Mirokuki/Battery-Charger/docs/board-top.png

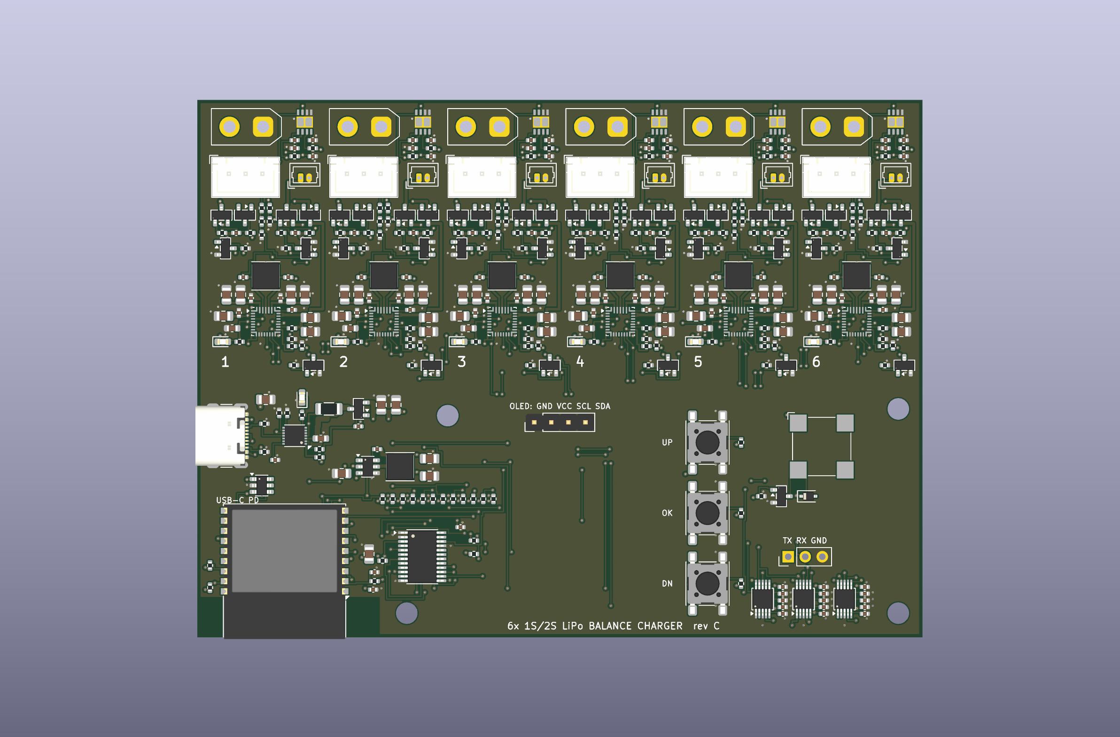
docs/board-top.png
