Mirokuki/Battery-Charger/docs/copper.png

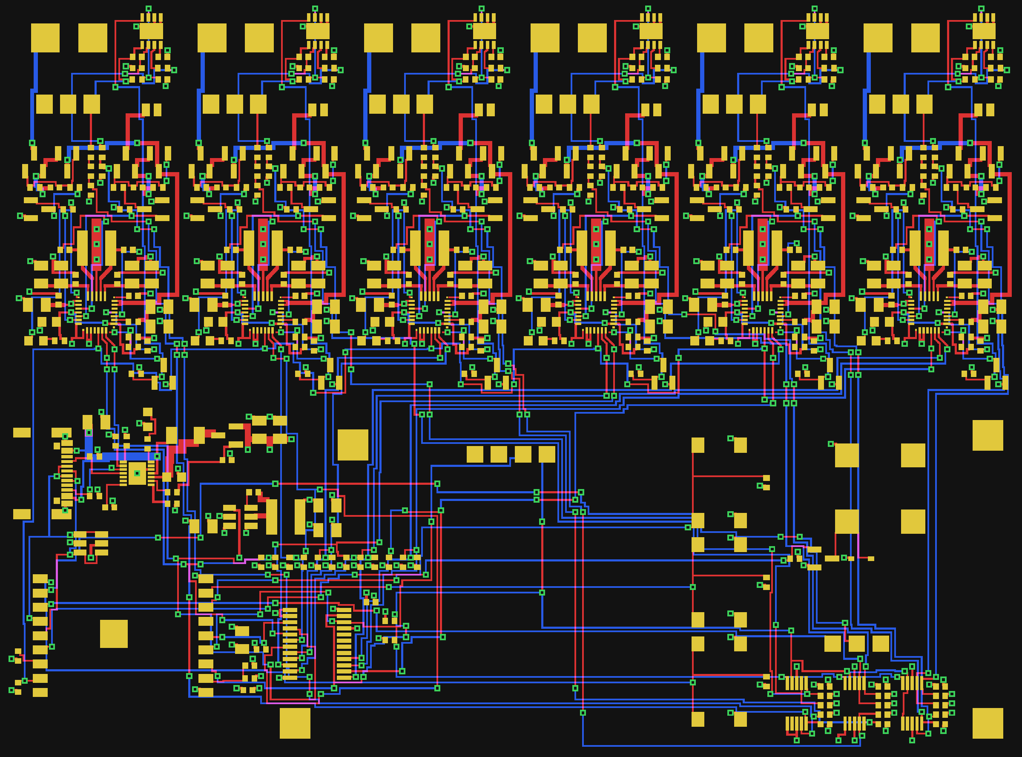
docs/copper.png
