Mirokuki/Battery-Charger/fab/BOM_JLCPCB.csv

Comment | Designator | Footprint | LCSC Part # | MPN | Qty | Assembly
CMT-8504-100-SMT | BZ1 | MagneticBuzzer_CUI_CMT-8504-100-SMT |  | CMT-8504-100-SMT-TR | 1 | SMT
100nF 50V | C1,C8,C12,C14,C20,C21,C22,C23,C24,C25,C26,C27,C28,C29,C30,C31,C32,C33,C34,C106,C109,C113,C116,C117,C118,C119,C120,C121,C206,C209,C213,C216,C217,C218,C219,C220,C221,C306,C309,C313,C316,C317,C318,C319,C320,C321,C406,C409,C413,C416,C417,C418,C419,C420,C421,C506,C509,C513,C516,C517,C518,C519,C520,C521,C606,C609,C613,C616,C617,C618,C619,C620,C621 | C_0402_1005Metric | C307331 | CL05B104KB54PNC | 73 | SMT
1uF 50V | C2 | C_0603_1608Metric | C15849 | CL10A105KB8NNNC | 1 | SMT
1uF 16V | C3,C13 | C_0402_1005Metric | C52923 | CL05A105KA5NQNC | 2 | SMT
10uF 25V | C4,C5,C6,C7,C11,C105,C107,C108,C114,C115,C205,C207,C208,C214,C215,C305,C307,C308,C314,C315,C405,C407,C408,C414,C415,C505,C507,C508,C514,C515,C605,C607,C608,C614,C615 | C_0805_2012Metric | C15850 | CL21A106KAYNNNE | 35 | SMT
22uF 25V | C9,C10,C110,C111,C210,C211,C310,C311,C410,C411,C510,C511,C610,C611 | C_0805_2012Metric | C45783 | CL21A226MAQNNNE | 14 | SMT
47nF 50V | C101,C103,C201,C203,C301,C303,C401,C403,C501,C503,C601,C603 | C_0402_1005Metric |  | CL05B473KB5NNNC | 12 | SMT
4.7uF 16V | C102,C202,C302,C402,C502,C602 | C_0603_1608Metric | C19666 | CL10A475KO8NNNC | 6 | SMT
1nF 50V | C104,C204,C304,C404,C504,C604 | C_0402_1005Metric | C1523 | CL05B102KB5NNNC | 6 | SMT
PD OK (blue) | D1 | LED_0603_1608Metric | C72041 | 19-217/BHC-ZL1M2RY/3T | 1 | SMT
1N4148WS | D2 | D_SOD-323 | C2128 | 1N4148WS | 1 | SMT
CHARGING (green) | D101,D201,D301,D401,D501,D601 | LED_0603_1608Metric | C72043 | 19-217/GHC-YR1S2/3T | 6 | SMT
USB4105-GF-A | J1 | USB_C_Receptacle_GCT_USB4105-xx-A_16P_TopMnt_Horizontal | C3020560 | USB4105-GF-A | 1 | SMT
OLED 0.96in SSD1306 (GND VCC SCL SDA) | J2 | PinHeader_1x04_P2.54mm_Vertical |  |  | 1 | hand-solder (through-hole)
XT30 2S | J101,J201,J301,J401,J501,J601 | AMASS_XT30UPB-M_1x02_P5.0mm_Vertical | C99101 | XT30UPB-M | 6 | hand-solder (through-hole)
PicoBlade 1S | J102,J202,J302,J402,J502,J602 | Molex_PicoBlade_53047-0210_1x02_P1.25mm_Vertical |  | 0530470210 | 6 | hand-solder (through-hole)
XH balance 2S | J103,J203,J303,J403,J503,J603 | JST_XH_B3B-XH-A_1x03_P2.50mm_Vertical | C144394 | B3B-XH-A | 6 | hand-solder (through-hole)
4.7uH 2A | L1 | L_Changjiang_FNR4030S |  | FNR4030S4R7MT | 1 | SMT
2.2uH 3A | L101,L201,L301,L401,L501,L601 | L_Changjiang_FNR4030S |  | FNR4030S2R2MT | 6 | SMT
AO3400A | Q1 | SOT-23 | C20917 | AO3400A | 1 | SMT
2N7002 | Q2,Q105,Q106,Q107,Q205,Q206,Q207,Q305,Q306,Q307,Q405,Q406,Q407,Q505,Q506,Q507,Q605,Q606,Q607 | SOT-23 | C8545 | 2N7002 | 19 | SMT
AO3401A | Q101,Q102,Q103,Q104,Q201,Q202,Q203,Q204,Q301,Q302,Q303,Q304,Q401,Q402,Q403,Q404,Q501,Q502,Q503,Q504,Q601,Q602,Q603,Q604 | SOT-23 | C15127 | AO3401A | 24 | SMT
5.1k | R1,R2 | R_0402_1005Metric | C25905 | 0402WGF5101TCE | 2 | SMT
5mR 1% | R3 | R_1206_3216Metric |  | PE1206FKF470R005Z | 1 | SMT
6.2k | R4 | R_0402_1005Metric |  | 0402WGF6201TCE | 1 | SMT
200R | R5 | R_0402_1005Metric | C25087 | 0402WGF2000TCE | 1 | SMT
82k | R6 | R_0402_1005Metric | C25958 | 0402WGF8202TCE | 1 | SMT
100k | R7,R17,R116,R216,R316,R416,R516,R616 | R_0402_1005Metric | C25741 | 0402WGF1003TCE | 8 | SMT
2.2k | R8 | R_0402_1005Metric | C25879 | 0402WGF2201TCE | 1 | SMT
10k | R9,R10,R11,R14,R15,R16,R18,R102,R103,R107,R110,R112,R113,R202,R203,R207,R210,R212,R213,R302,R303,R307,R310,R312,R313,R402,R403,R407,R410,R412,R413,R502,R503,R507,R510,R512,R513,R602,R603,R607,R610,R612,R613 | R_0402_1005Metric | C25744 | 0402WGF1002TCE | 43 | SMT
4.7k | R12,R13,R105,R205,R305,R405,R505,R605 | R_0402_1005Metric | C25900 | 0402WGF4701TCE | 8 | SMT
1k | R101,R201,R301,R401,R501,R601 | R_0402_1005Metric | C11702 | 0402WGF1001TCE | 6 | SMT
100R | R104,R115,R204,R215,R304,R315,R404,R415,R504,R515,R604,R615 | R_0402_1005Metric | C25076 | 0402WGF1000TCE | 12 | SMT
47k | R106,R109,R206,R209,R306,R309,R406,R409,R506,R509,R606,R609 | R_0402_1005Metric | C25792 | 0402WGF4702TCE | 12 | SMT
68k | R108,R111,R208,R211,R308,R311,R408,R411,R508,R511,R608,R611 | R_0402_1005Metric | C36871 | 0402WGF6802TCE | 12 | SMT
120R | R114,R214,R314,R414,R514,R614 | R_0402_1005Metric |  | 0402WGF1200TCE | 6 | SMT
1M 0.1% | R117,R118,R119,R120,R121,R217,R218,R219,R220,R221,R317,R318,R319,R320,R321,R417,R418,R419,R420,R421,R517,R518,R519,R520,R521,R617,R618,R619,R620,R621 | R_0402_1005Metric |  | RT0402BRD071ML | 30 | SMT
BTN_UP | SW1 | SW_SPST_PTS645Sx43SMTR92 |  | PTS645SM95SMTR92 LFS | 1 | SMT
BTN_OK | SW2 | SW_SPST_PTS645Sx43SMTR92 |  | PTS645SM95SMTR92 LFS | 1 | SMT
BTN_DN | SW3 | SW_SPST_PTS645Sx43SMTR92 |  | PTS645SM95SMTR92 LFS | 1 | SMT
AP33771C | U1 | DFN-14-1EP_3x3mm_P0.4mm_EP1.78x2.35mm |  | AP33771CFBZ-13-FA02 | 1 | SMT
AP63203WU | U2 | TSOT-23-6 | C780769 | AP63203WU-7 | 1 | SMT
ESP32-C3-WROOM-02-N4 | U3 | ESP32-C3-WROOM-02 | C2934560 | ESP32-C3-WROOM-02-N4 | 1 | SMT
USBLC6-2SC6 | U4 | SOT-23-6 | C7519 | USBLC6-2SC6 | 1 | SMT
TCA9548APWR | U5 | TSSOP-24_4.4x7.8mm_P0.65mm | C130026 | TCA9548APWR | 1 | SMT
ADS1115 | U6,U7,U8 | TSSOP-10_3x3mm_P0.5mm | C37593 | ADS1115IDGSR | 3 | SMT
BQ25798 | U101,U201,U301,U401,U501,U601 | Texas_RQM0029A_VQFN-29_4x4mm_P0.4mm | C2876768 | BQ25798RQMR | 6 | SMT
BQ29209 | U102,U202,U302,U402,U502,U602 | VSON-8-1EP_3x3mm_P0.65mm_EP1.65x2.4mm |  | BQ29209DRBR | 6 | SMT
