Mirokuki/Battery-Charger/case/case_lid.stl

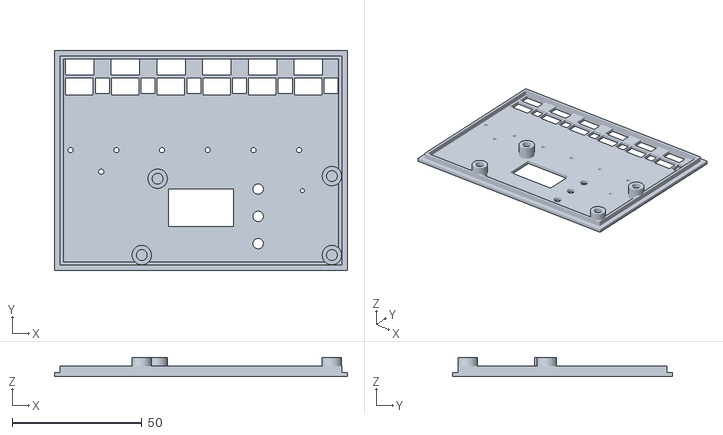
[picture p3: CAD file, 2026-11-12]
case/case_lid.stl
112.8 x 84.8 x 7.50
