Mirokuki/Battery-Charger/case/case_base.stl

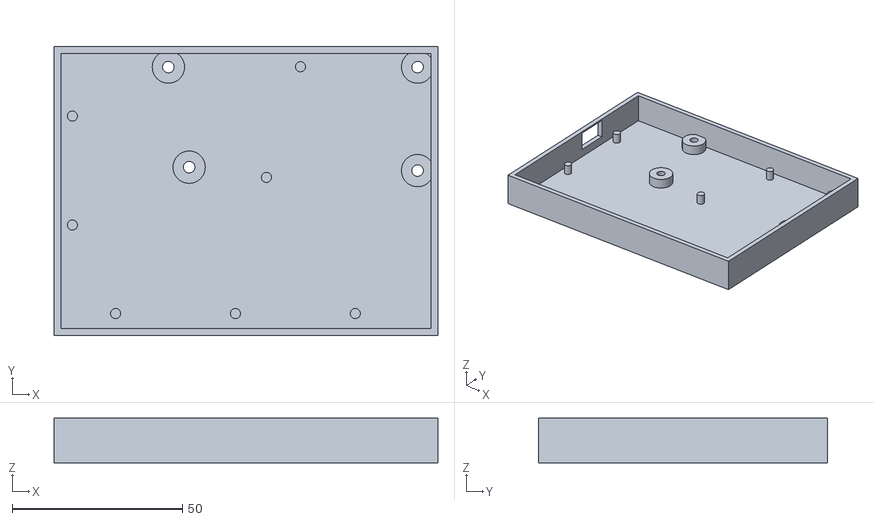
[picture p4: CAD file, 2026-11-12]
case/case_base.stl
112.8 x 84.8 x 13.2
