Mirokuki/Battery-Charger/docs/schematic.pdf

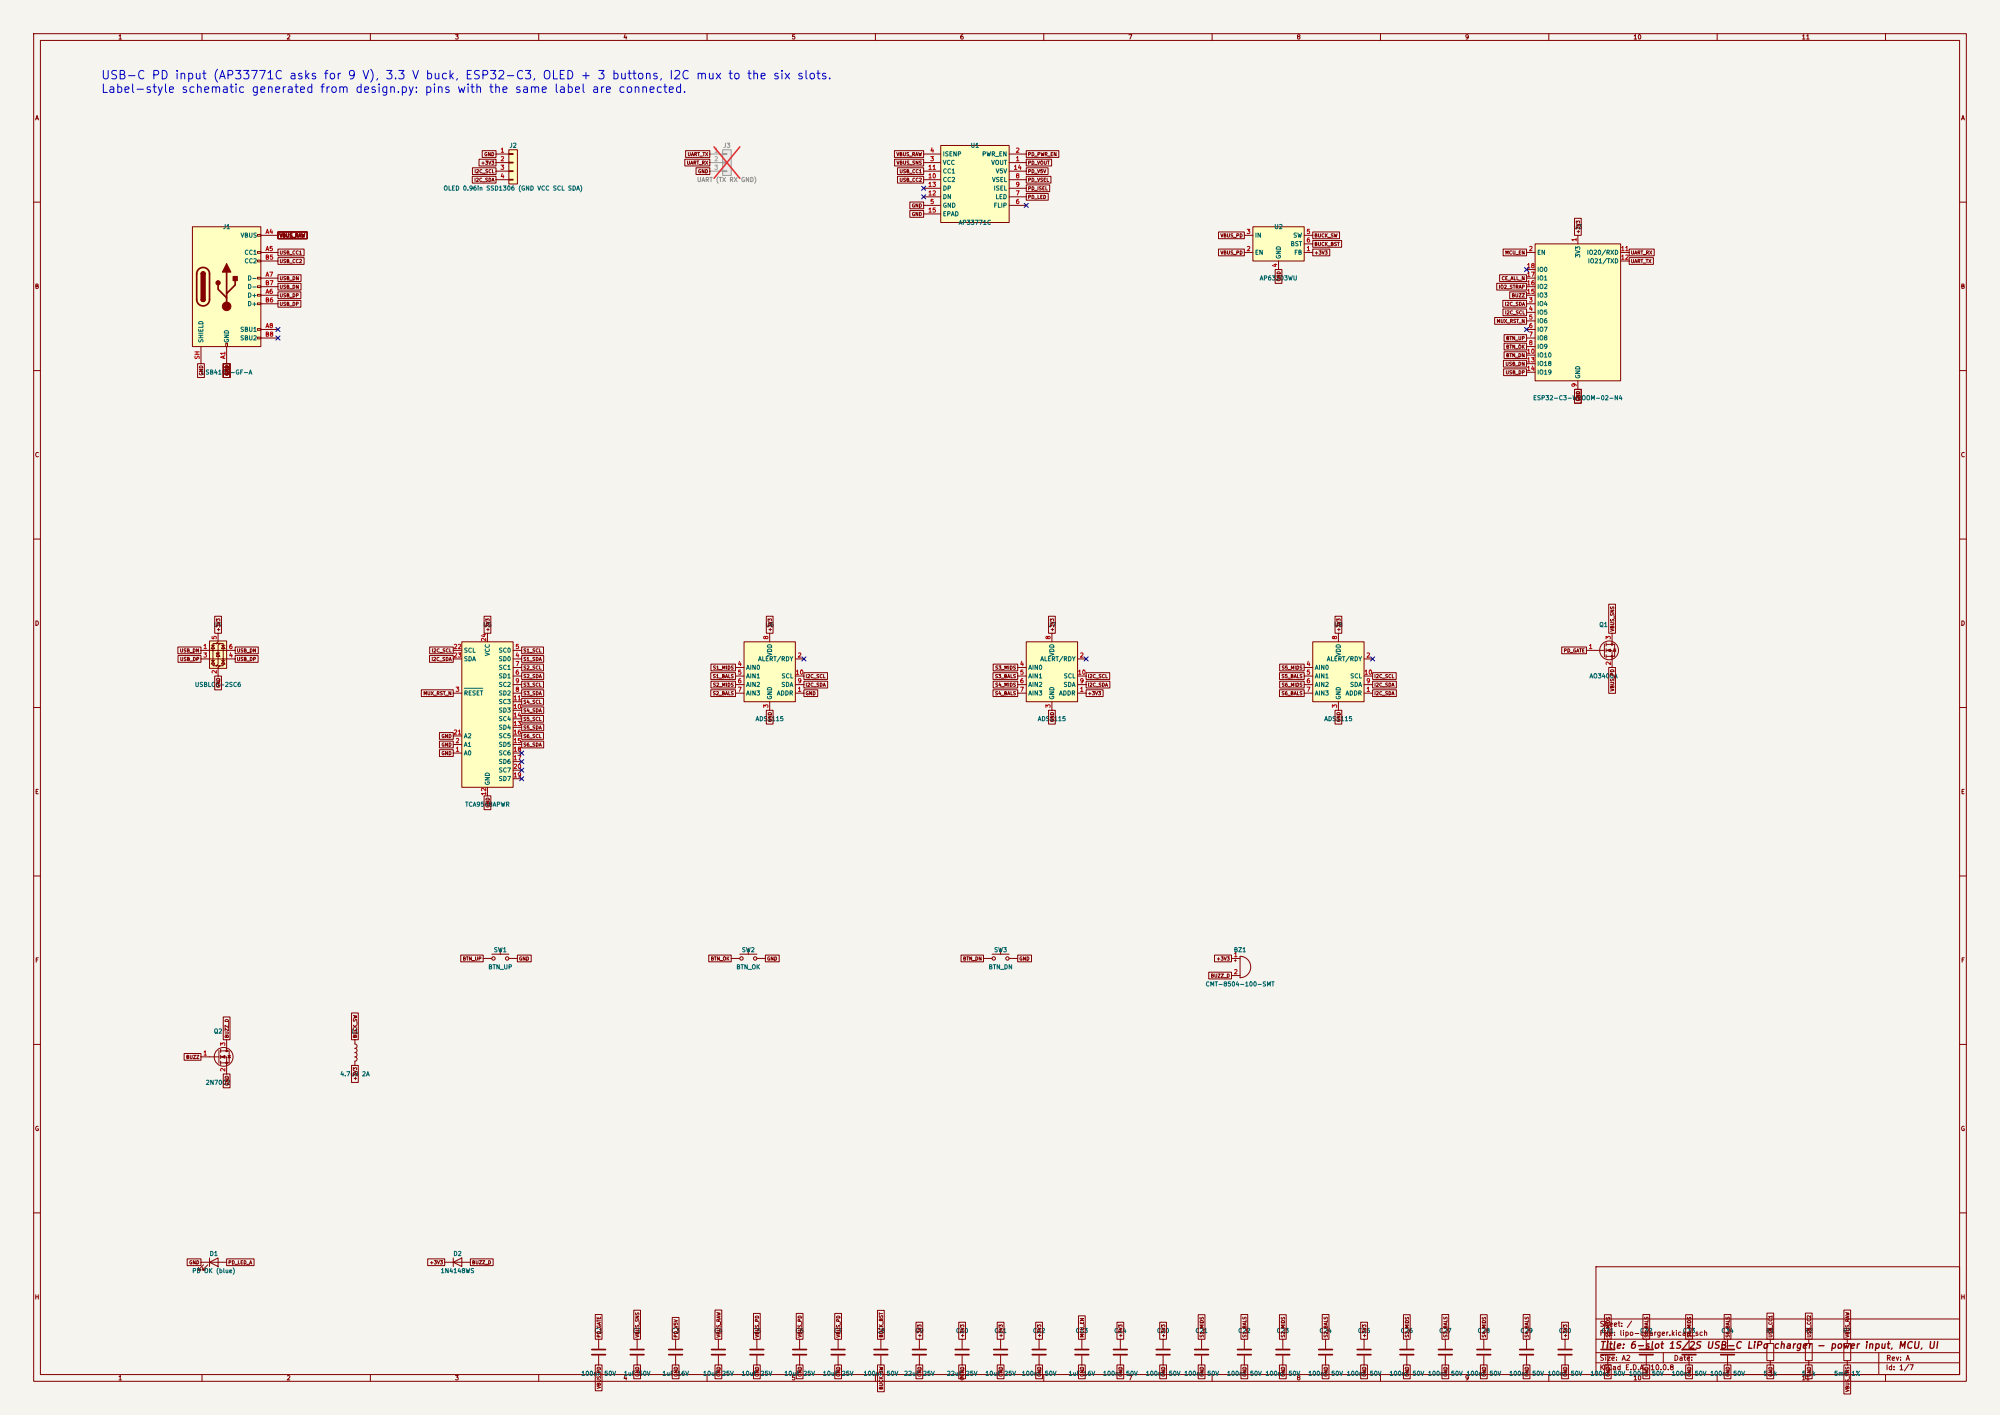
[picture p5: page 1]

USB-C PD input (AP33771C asks for 9 V), 3.3 V buck, ESP32-C3, OLED + 3 buttons, I2C mux to the six slots.
Label-style schematic generated from design.py: pins with the same label are connected.

J2 OLED 0.96in SSD1306 (GND VCC SCL SDA)

File: lipo-charger.kicad_sch
Title: 6-slot 1S/2S USB-C LiPo charger - power input, MCU, UI

Size: A2 | | | Rev: A
KiCad E.D.A. | 100nF | 10.0.8 50V | 5mR | 1% | Id: 1/7

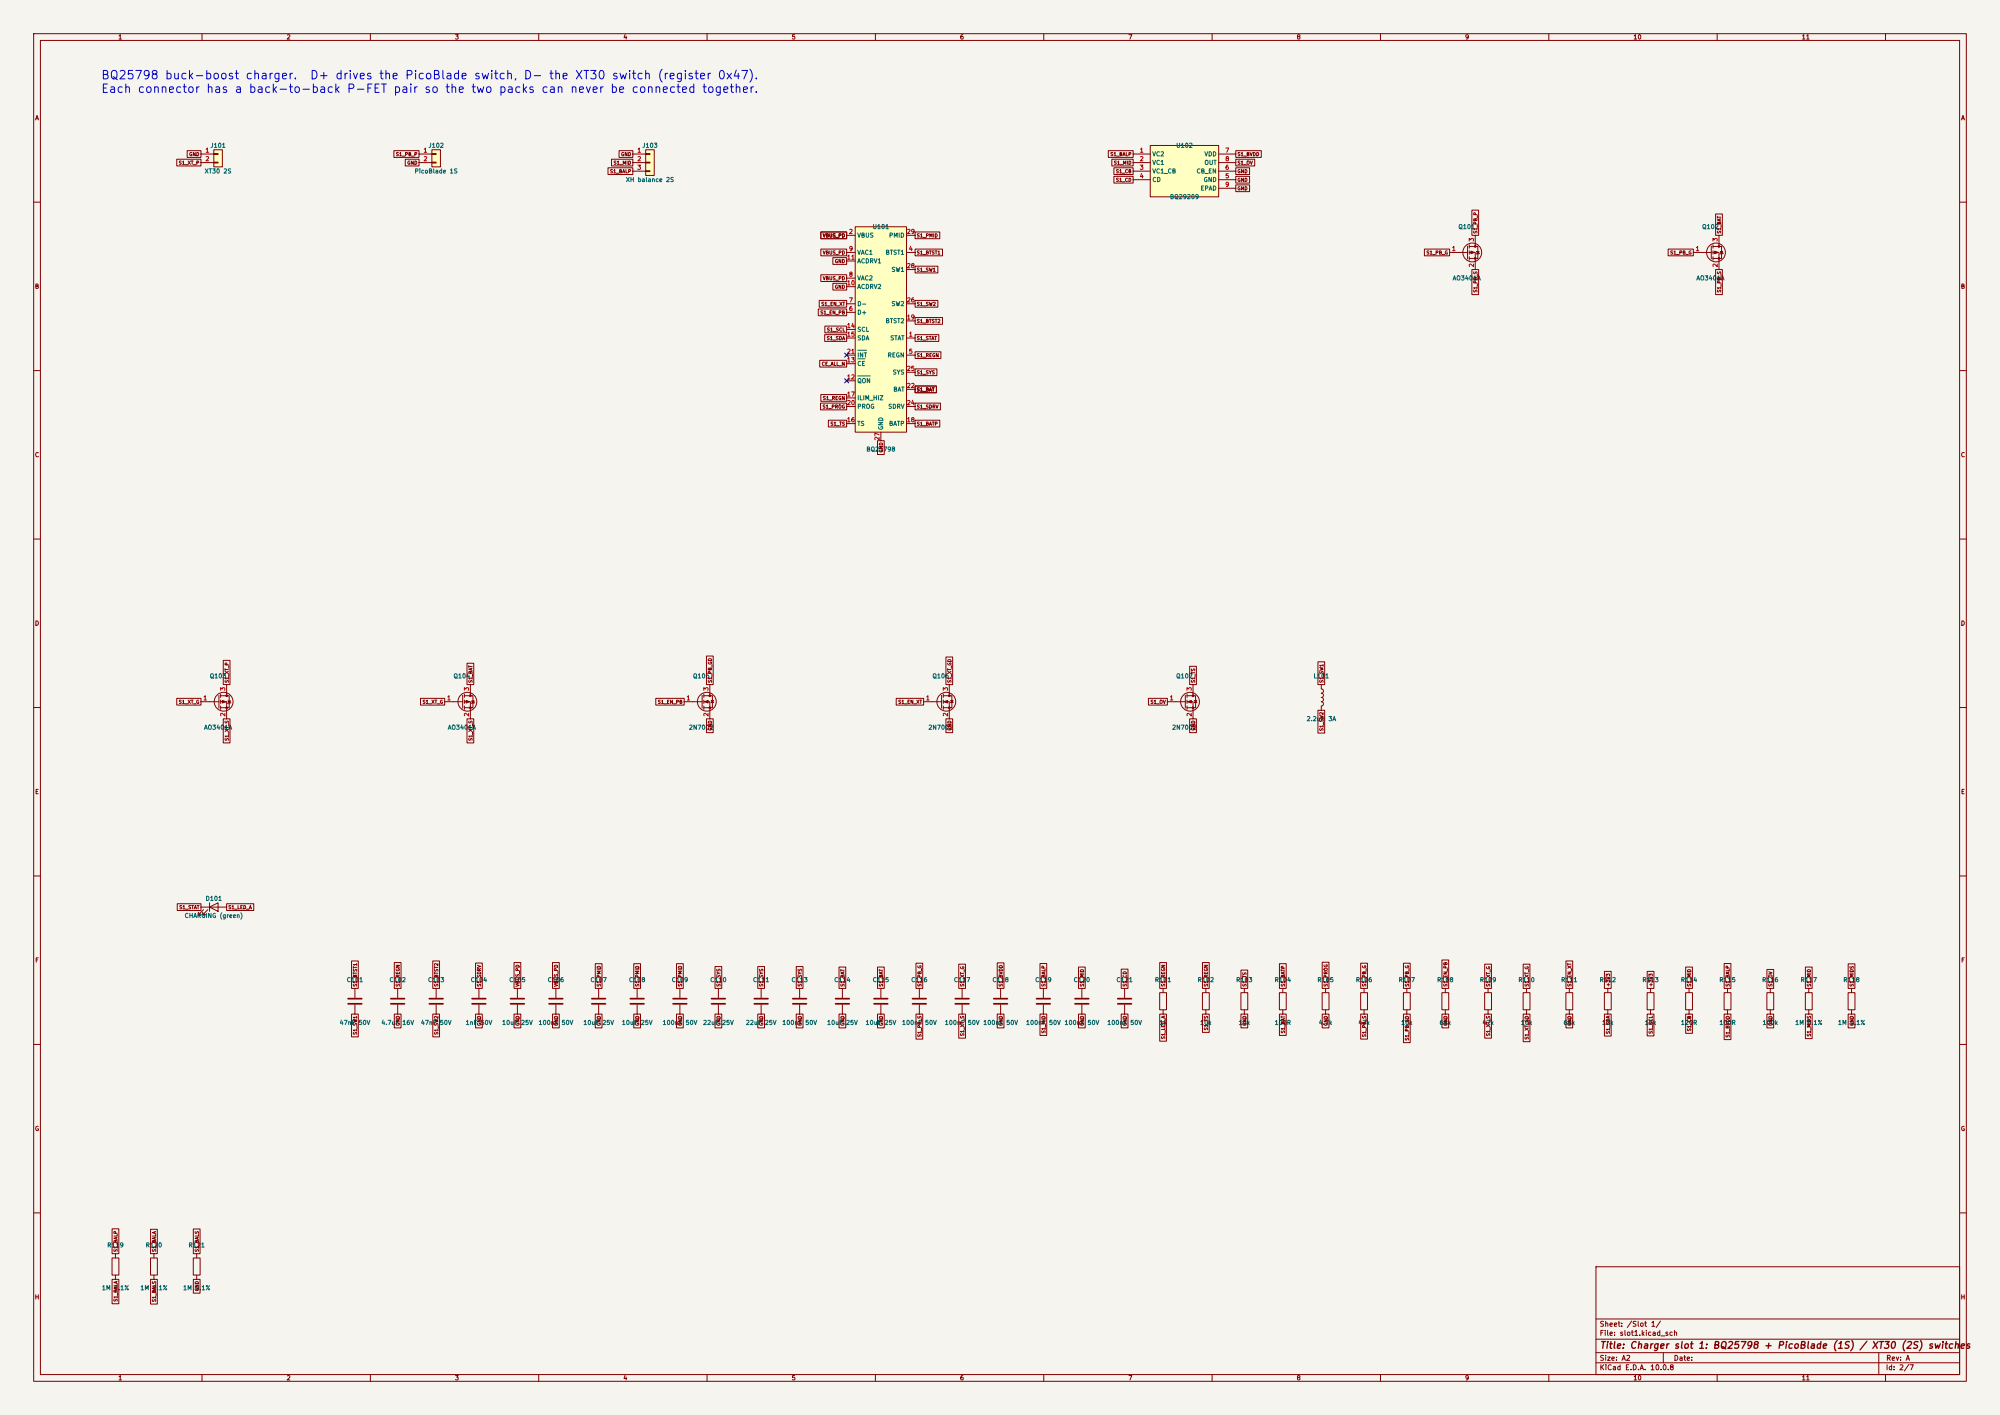
[picture p6: page 2]

BQ25798 buck-boost charger. D+ drives the PicoBlade switch, D- the XT30 switch (register 0x47).
Each connector has a back-to-back P-FET pair so the two packs can never be connected together.

Sheet: /Slot 1/
File: slot1.kicad_sch
Title: Charger slot 1: BQ25798 + PicoBlade (1S) / XT30 (2S) switches

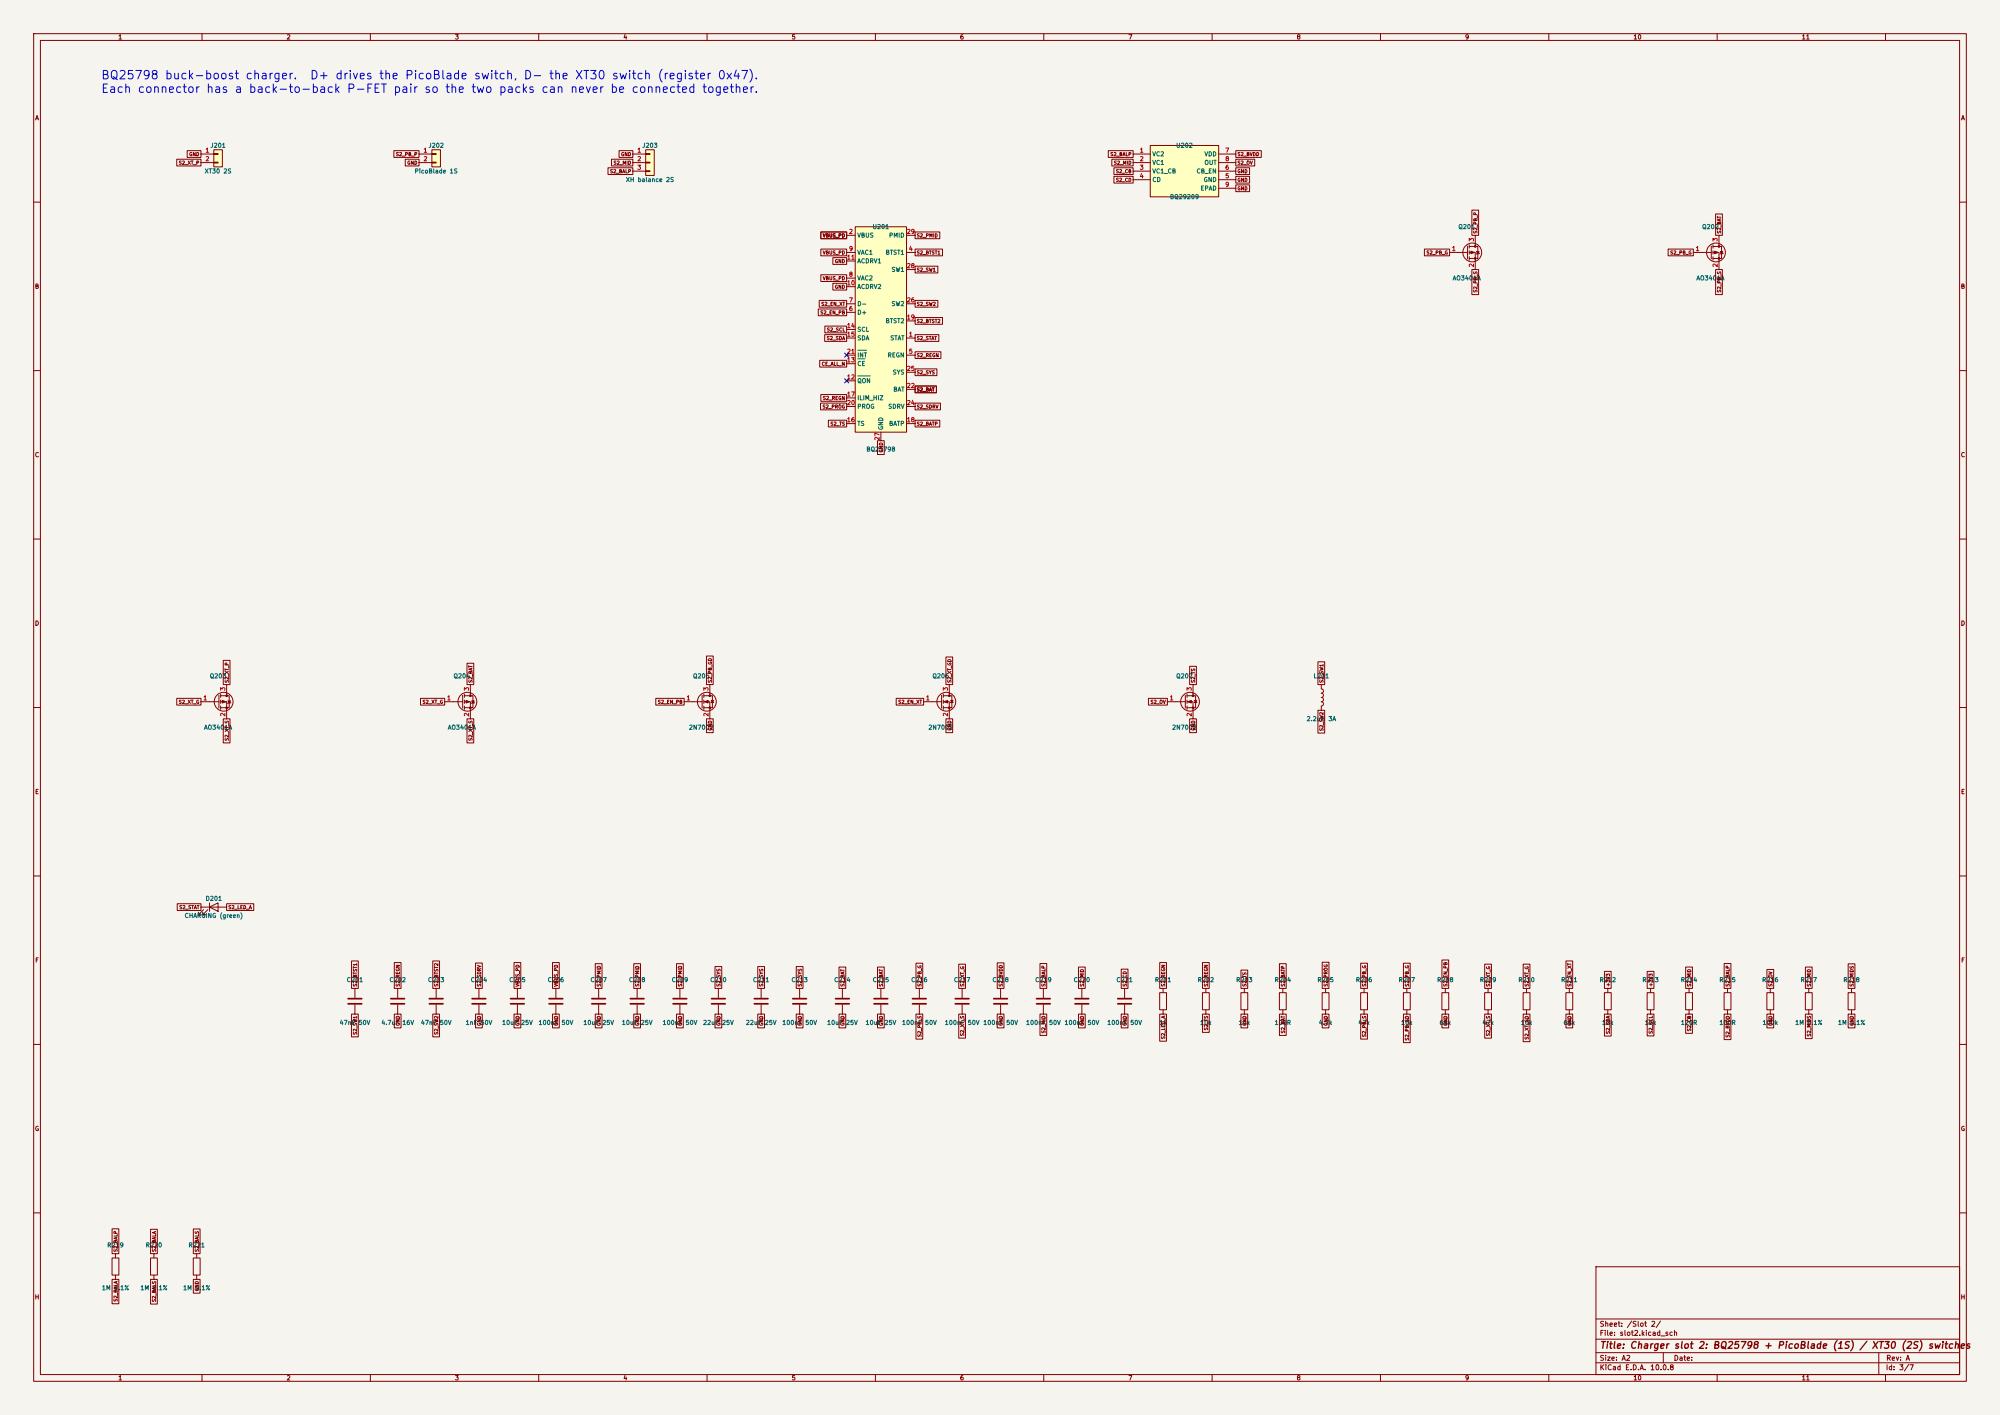
[picture p7: page 3]

File: slot2.kicad_sch
Title: Charger slot 2: BQ25798 + PicoBlade (1S) / XT30 (2S) switches

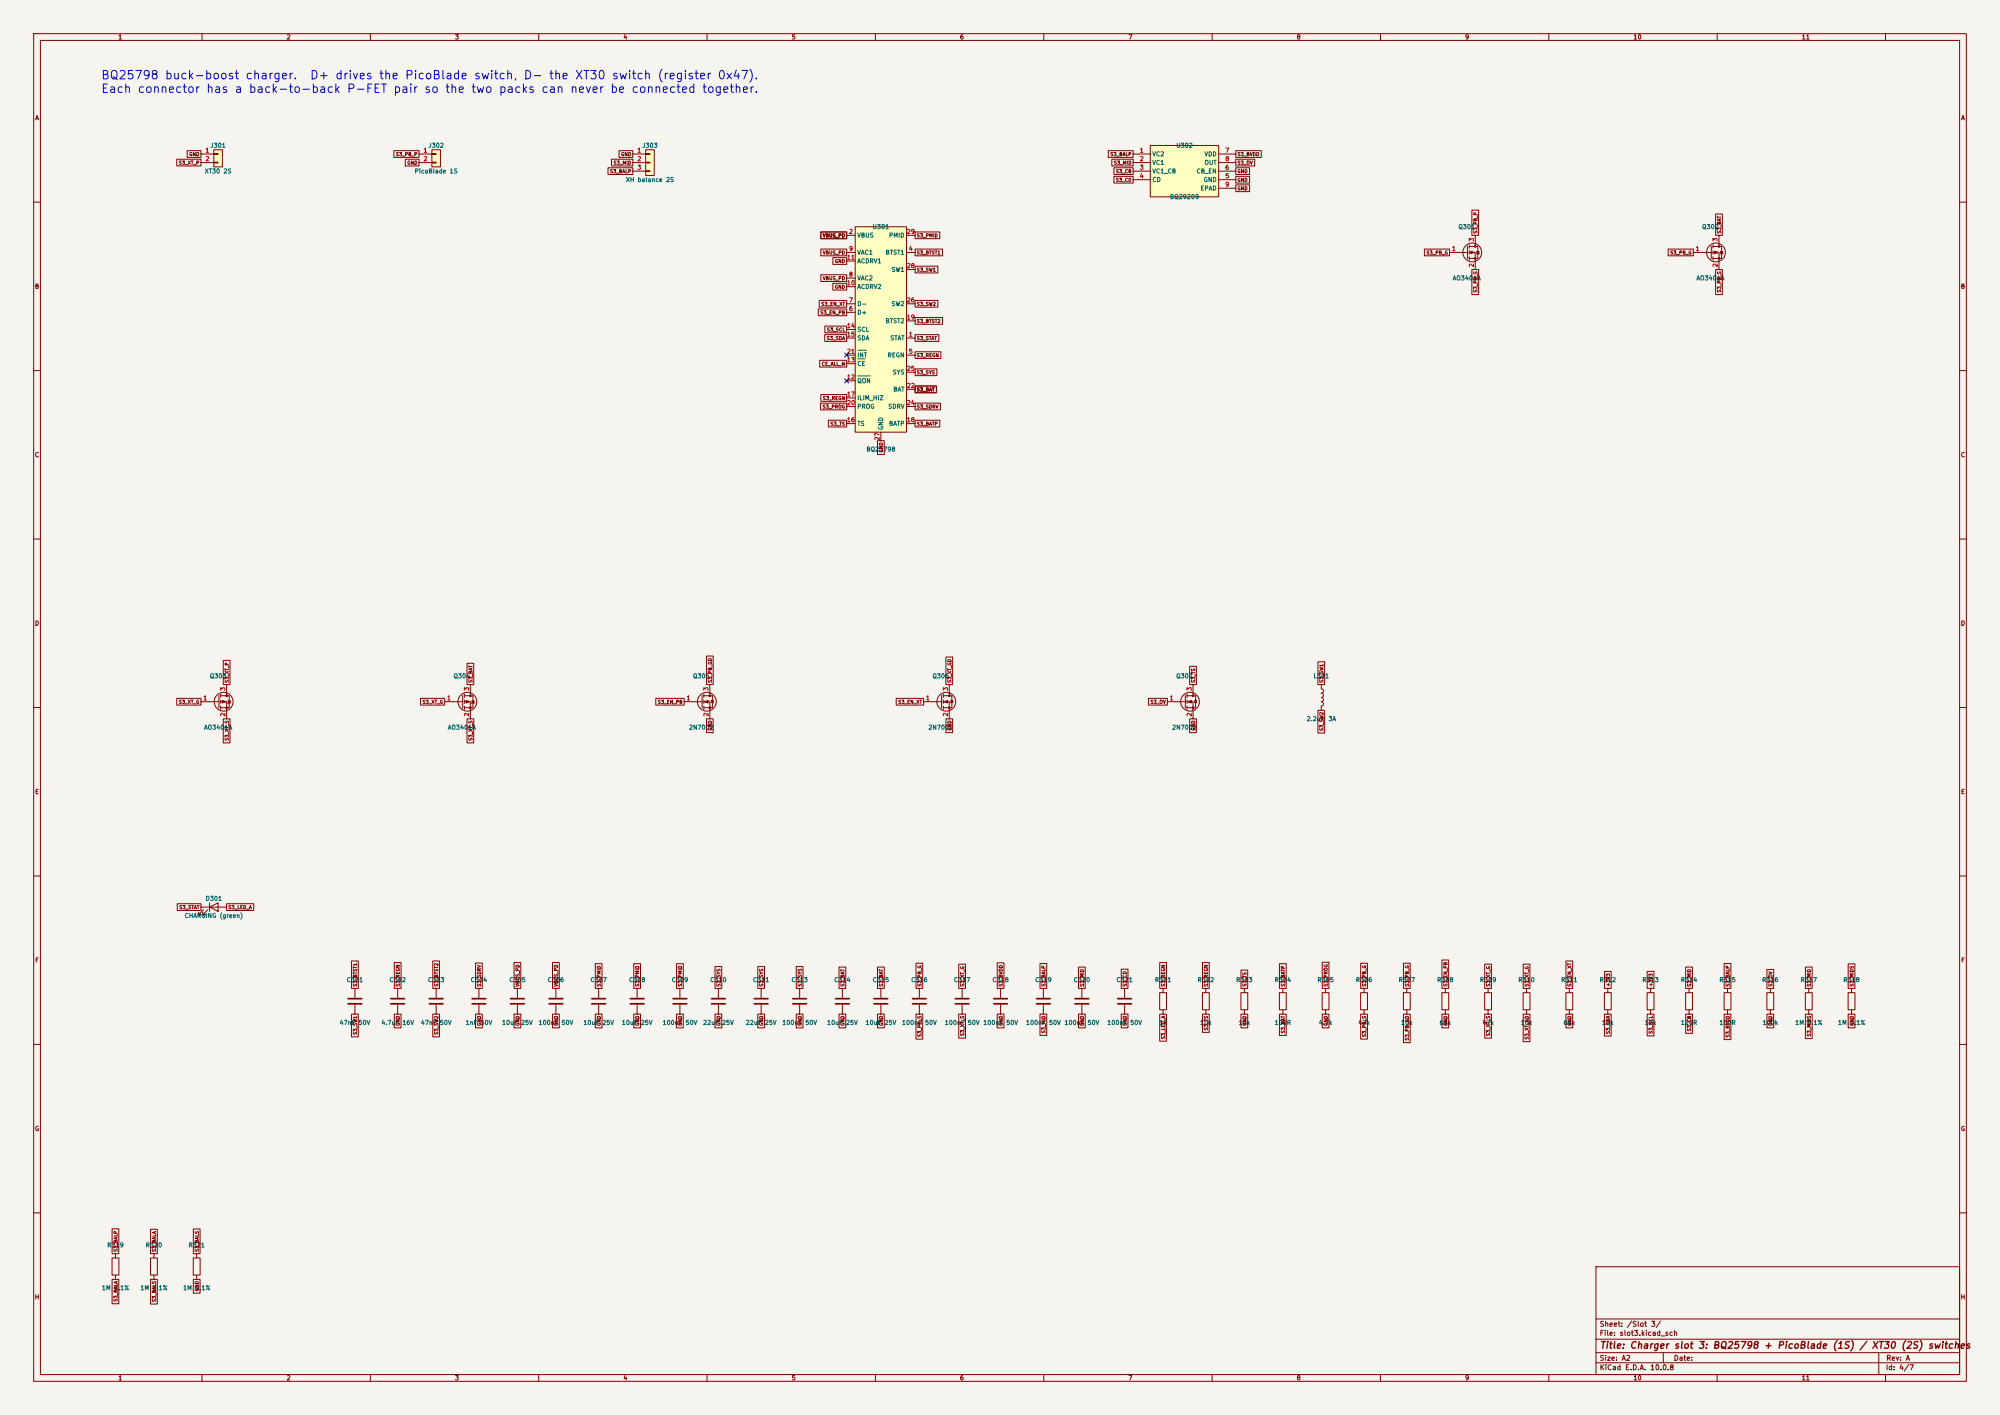
[picture p8: page 4]

File: slot3.kicad_sch
Title: Charger slot 3: BQ25798 + PicoBlade (1S) / XT30 (2S) switches

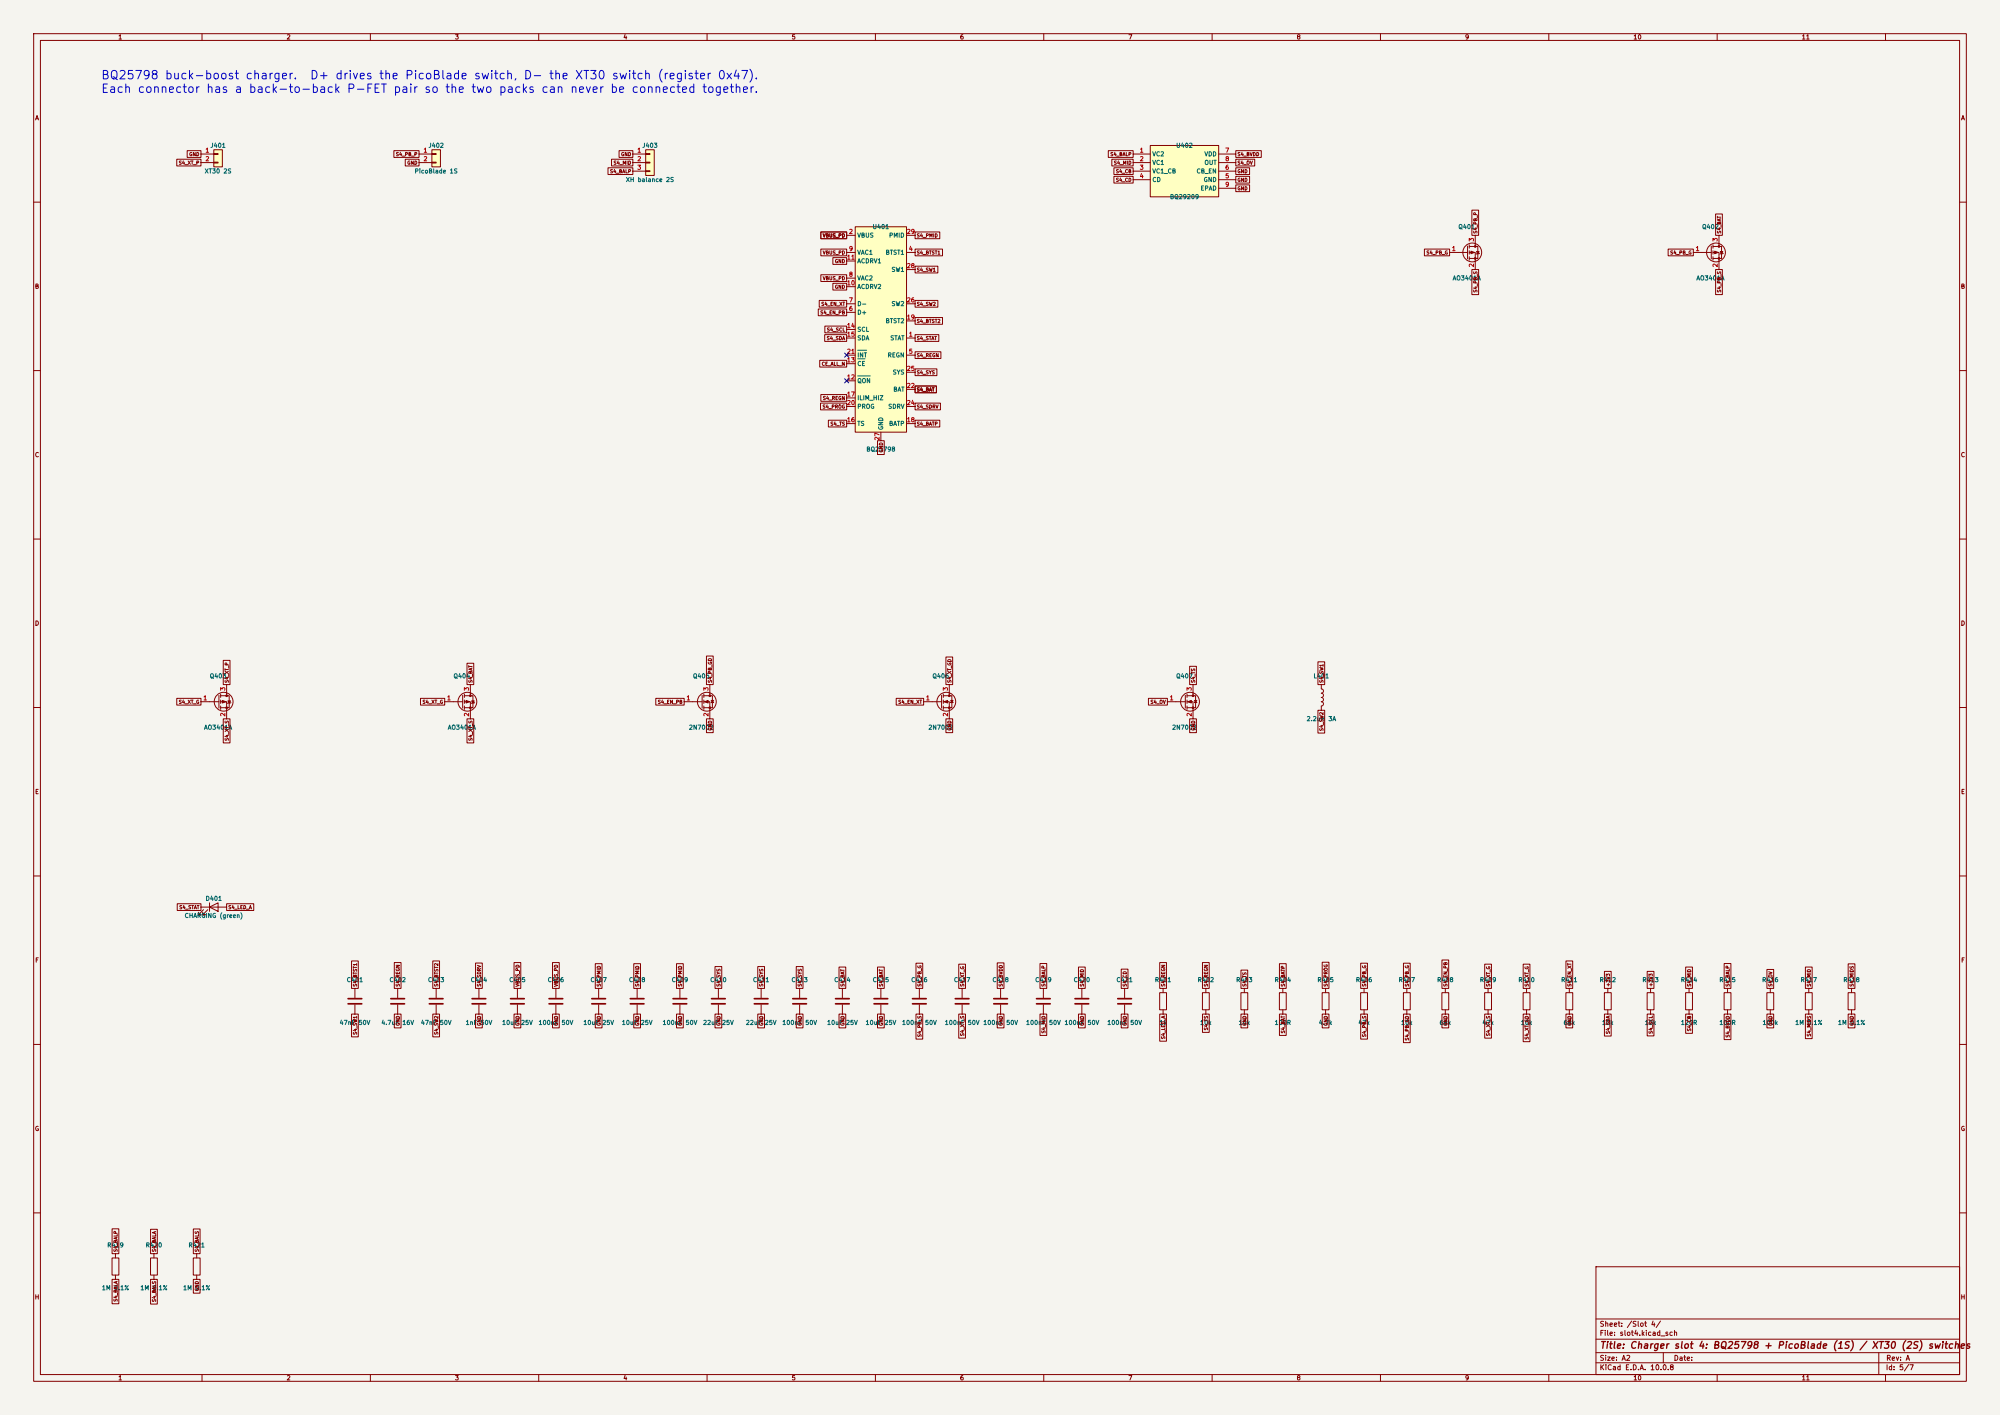
[picture p9: page 5]

File: slot4.kicad_sch
Title: Charger slot 4: BQ25798 + PicoBlade (1S) / XT30 (2S) switches

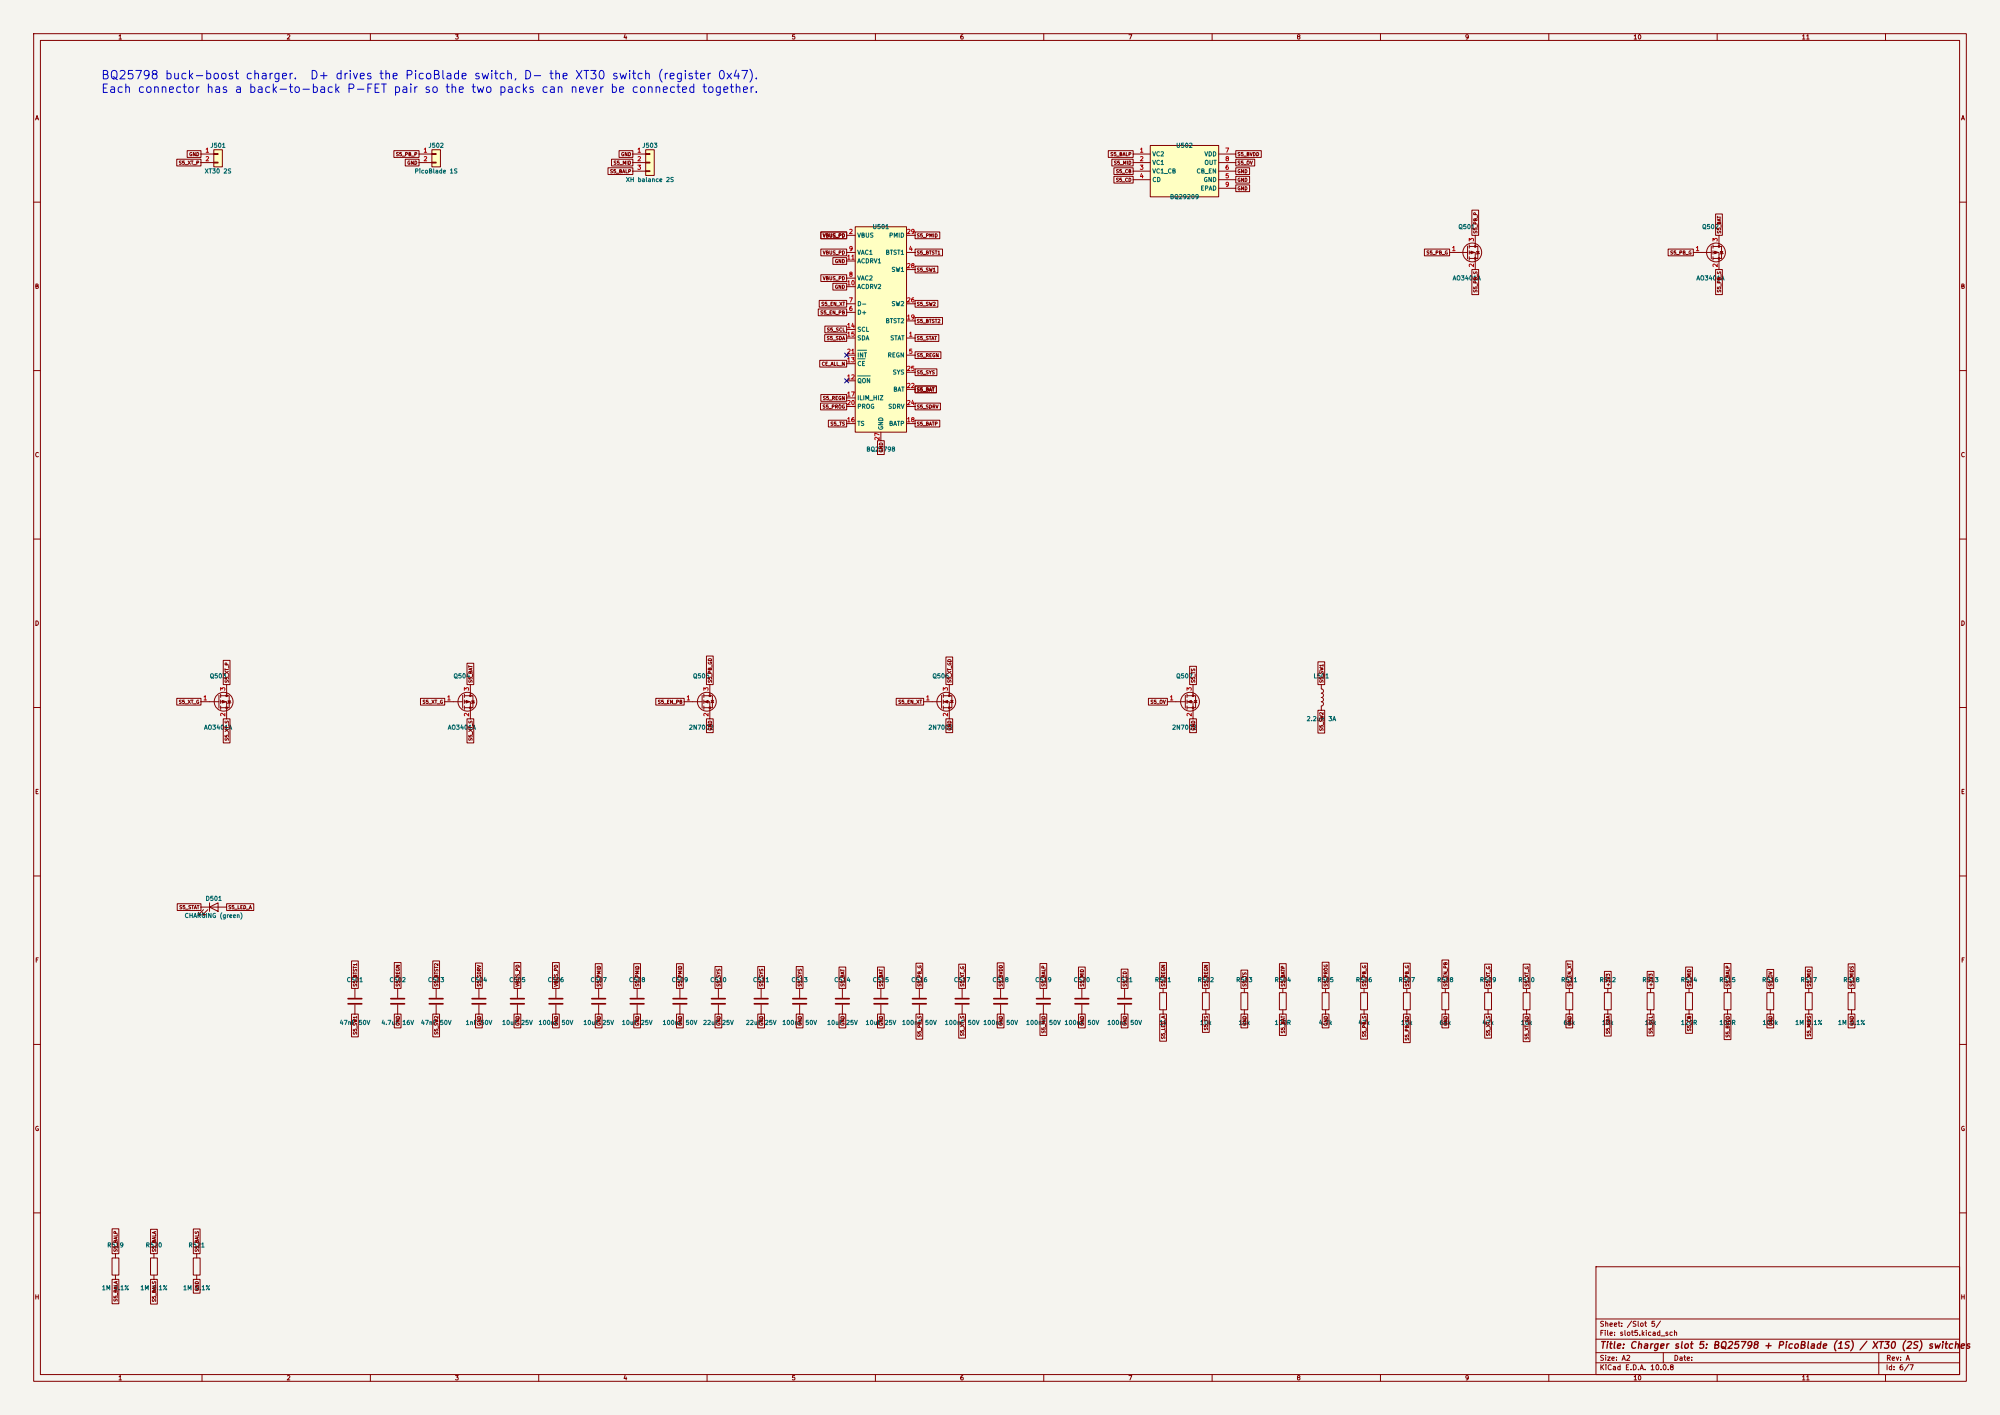
[picture p10: page 6]

File: slot5.kicad_sch
Title: Charger slot 5: BQ25798 + PicoBlade (1S) / XT30 (2S) switches

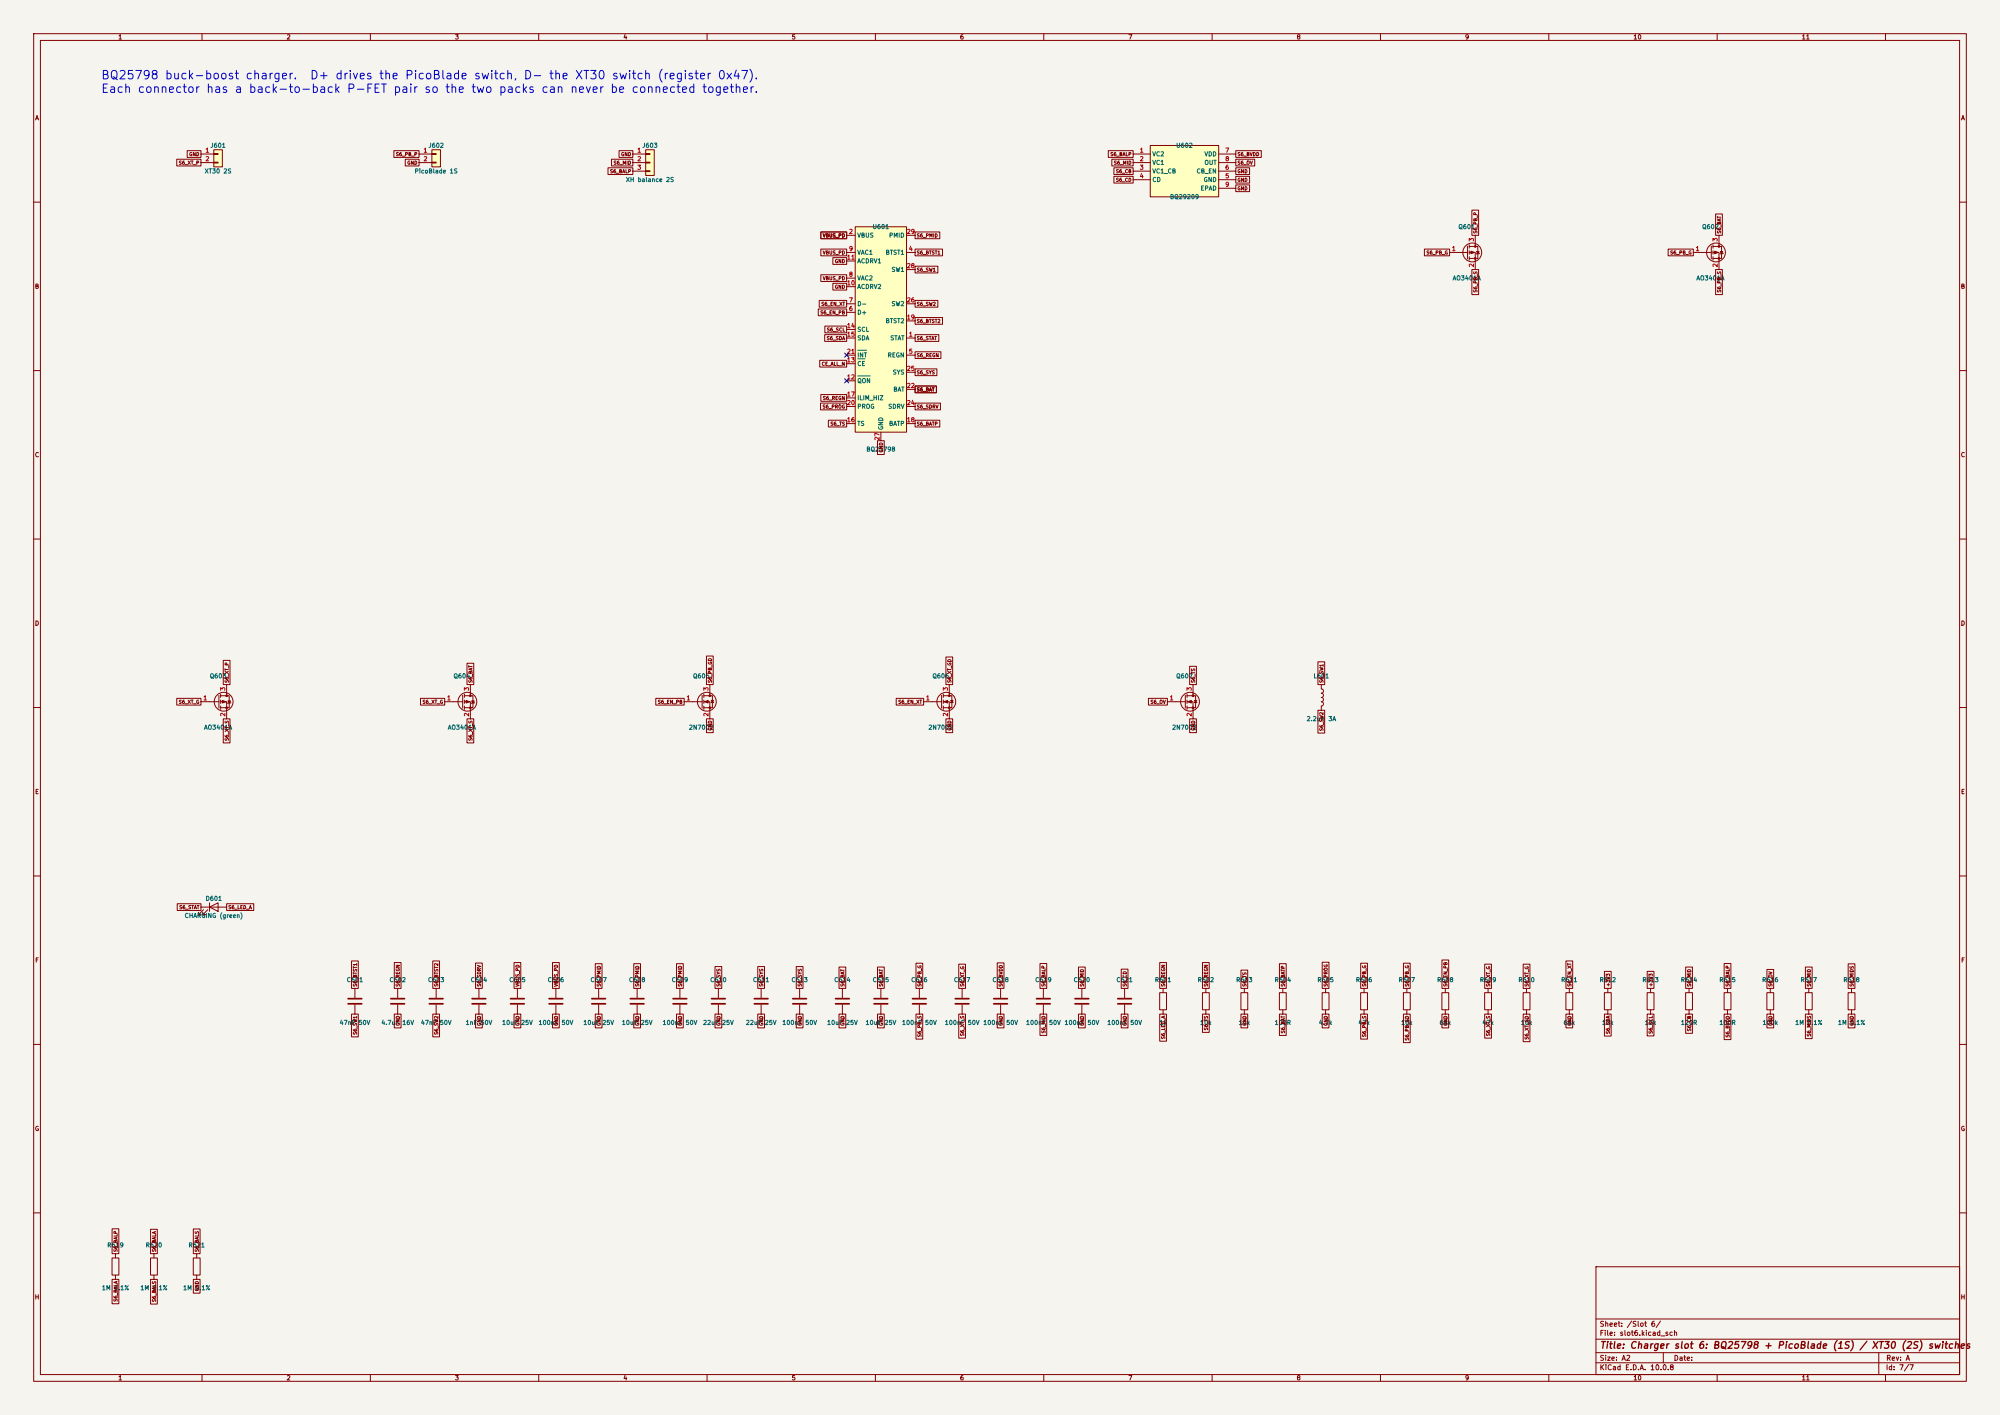
[picture p11: page 7]

File: slot6.kicad_sch
Title: Charger slot 6: BQ25798 + PicoBlade (1S) / XT30 (2S) switches
