Mirokuki/Battery-Charger/hardware/lipo-charger.kicad_pcb

## KiCad design hardware/lipo-charger.kicad_pcb (2026-11-13)

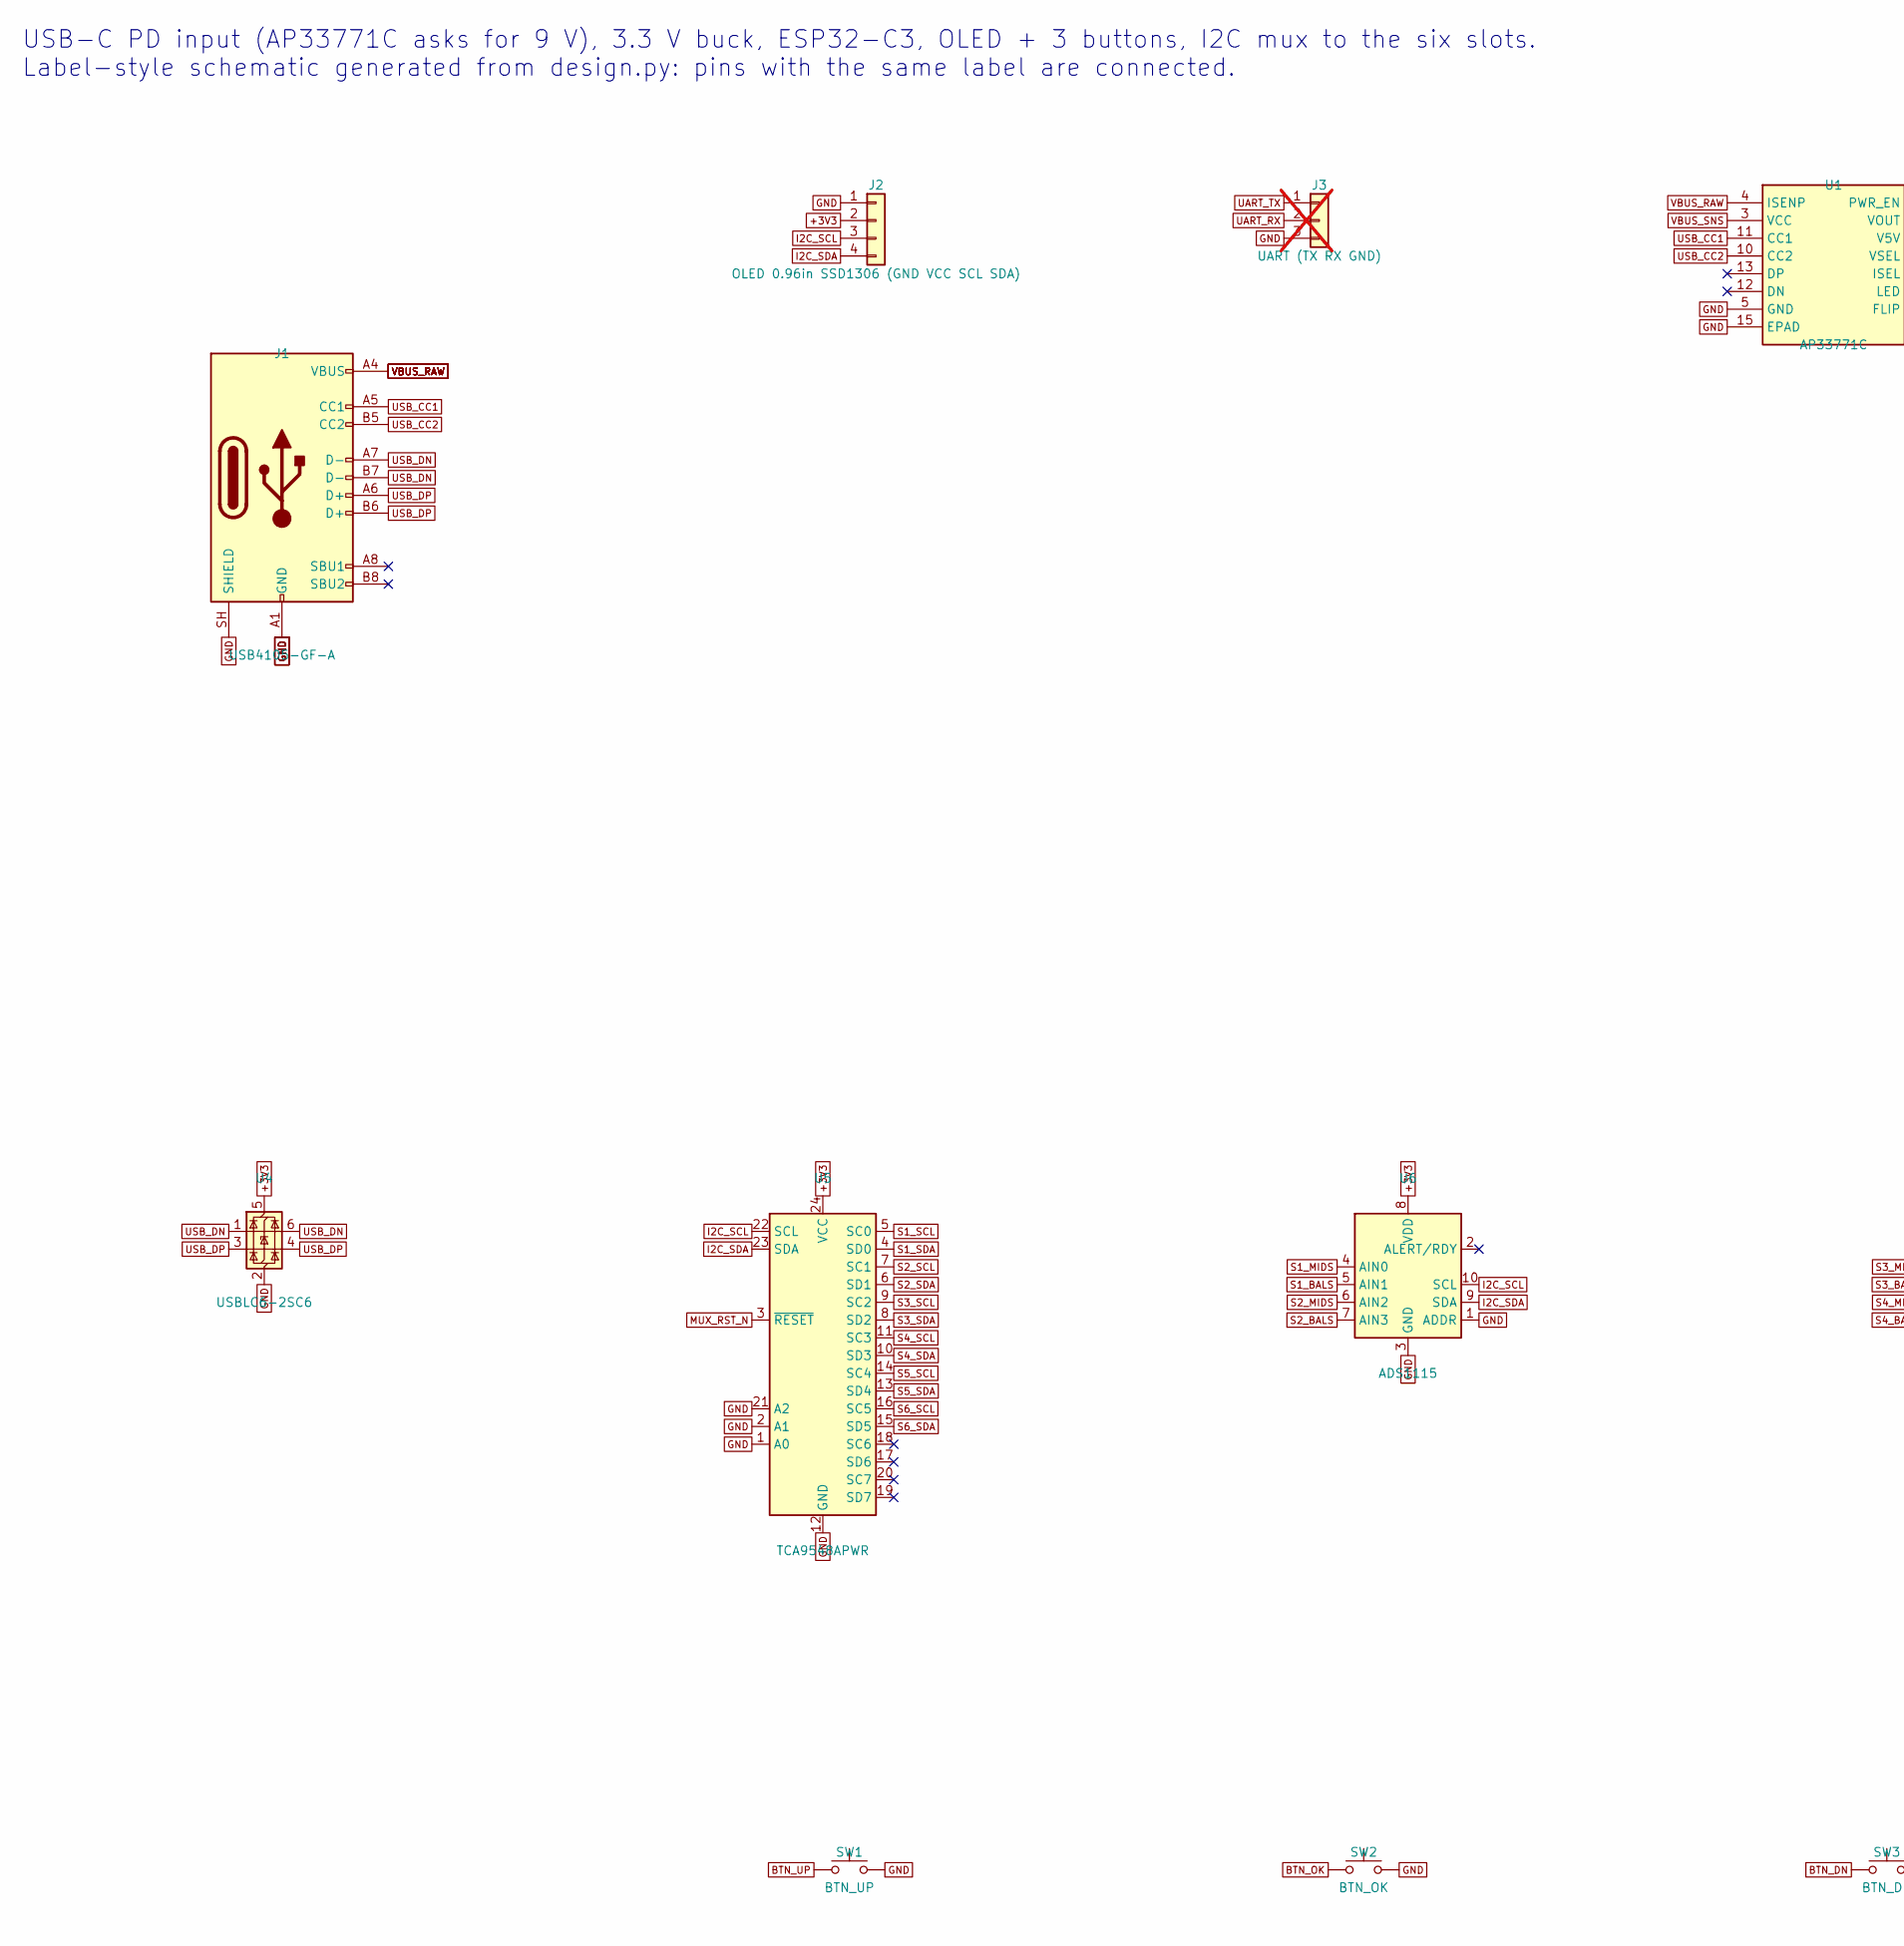
[picture p12: schematic lipo-charger.kicad_sch, 6-slot 1S/2S USB-C LiPo charger - power input, MCU, UI, part in row 1, column 1]

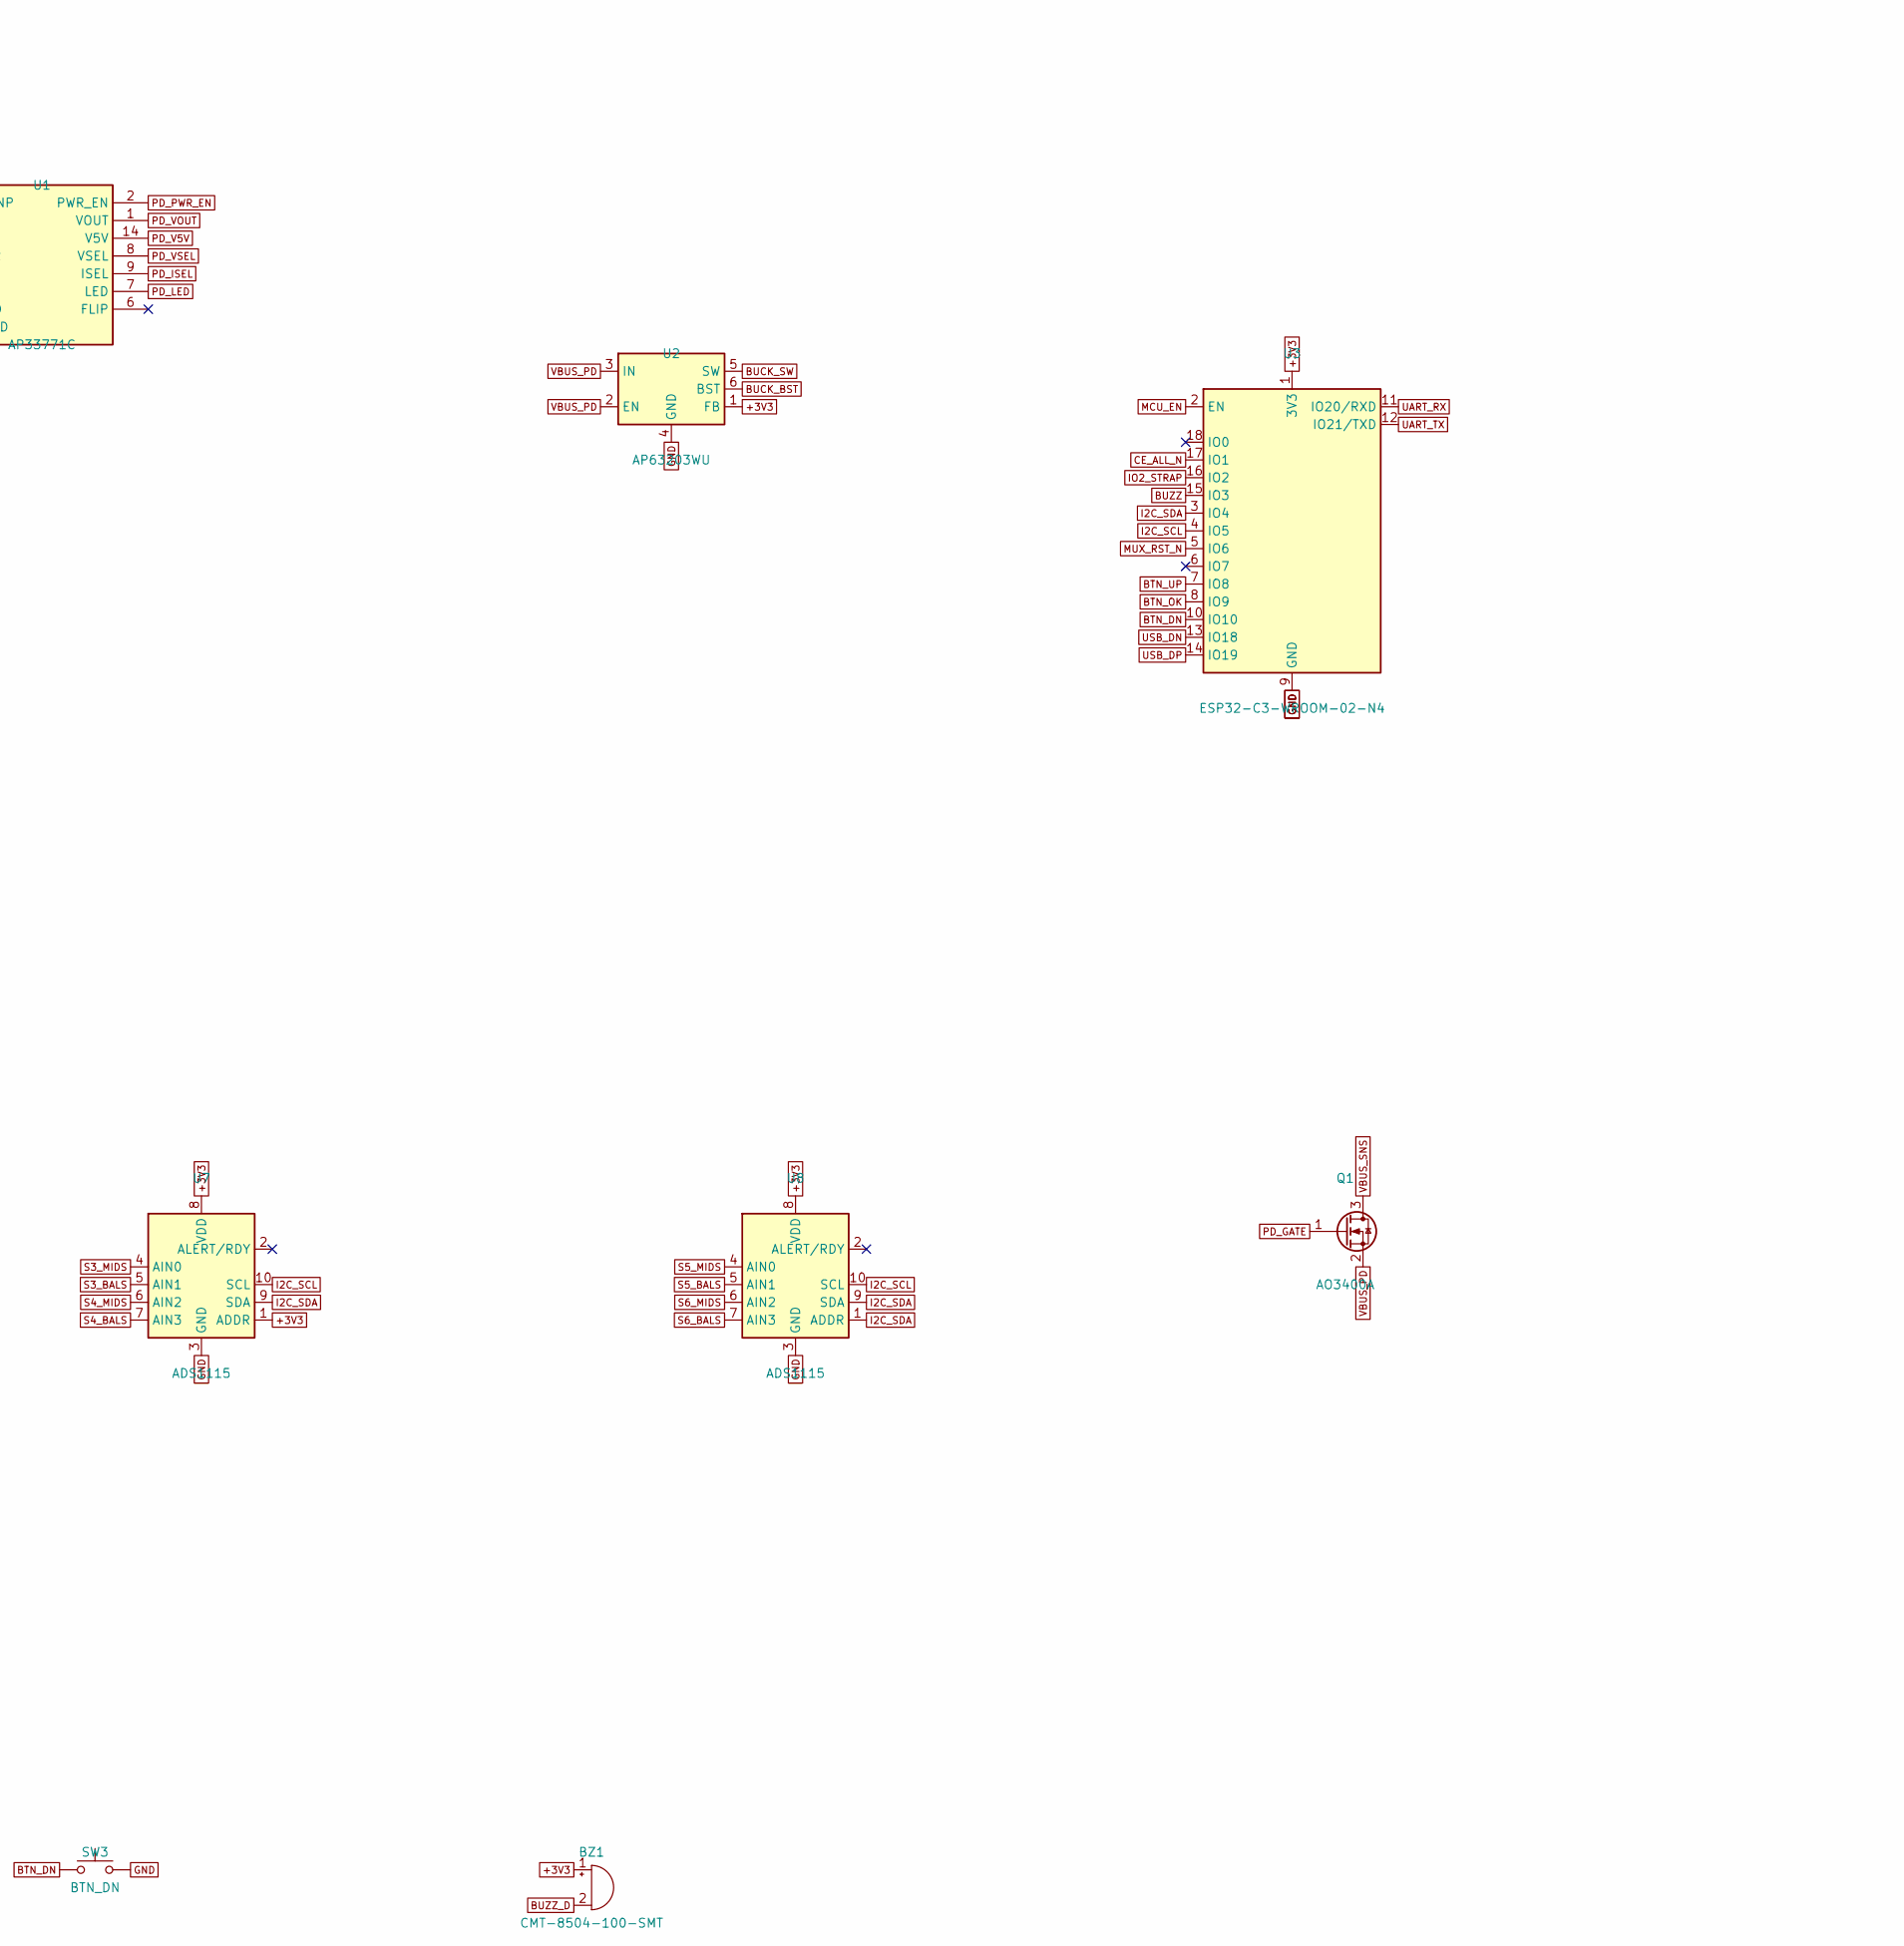
[picture p13: schematic lipo-charger.kicad_sch, 6-slot 1S/2S USB-C LiPo charger - power input, MCU, UI, part in row 1, column 2]

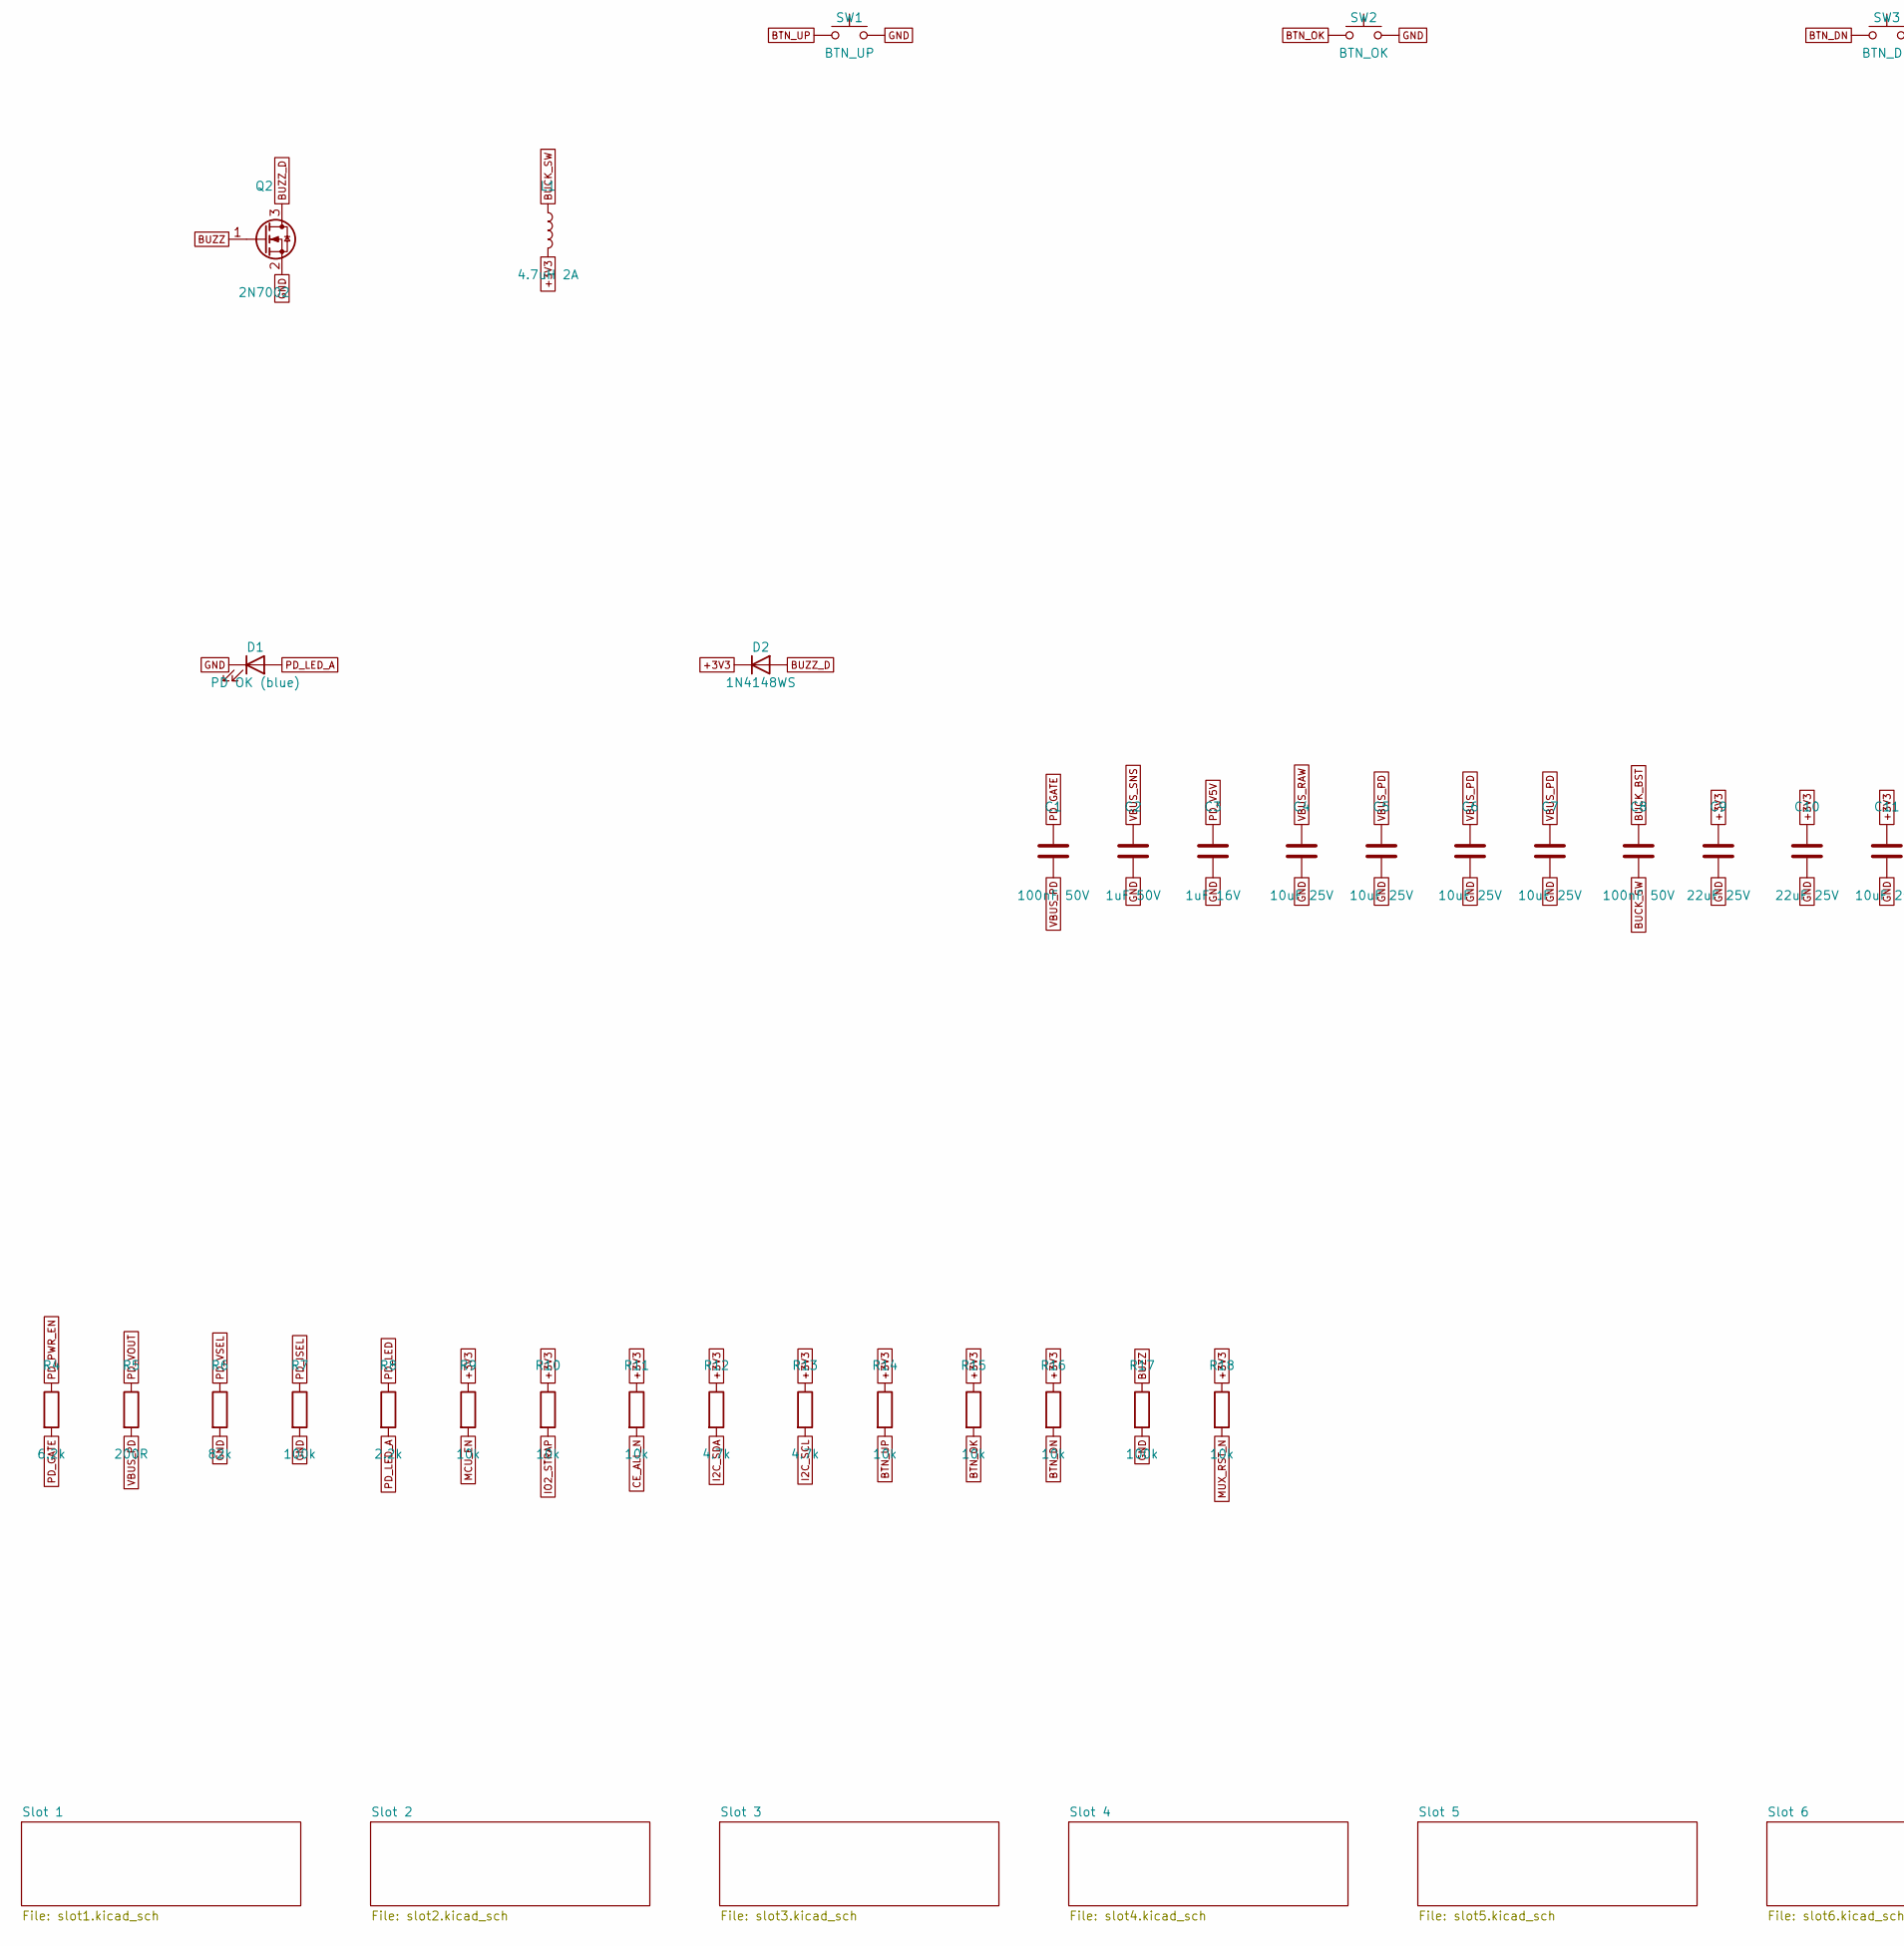
[picture p14: schematic lipo-charger.kicad_sch, 6-slot 1S/2S USB-C LiPo charger - power input, MCU, UI, part in row 2, column 1]

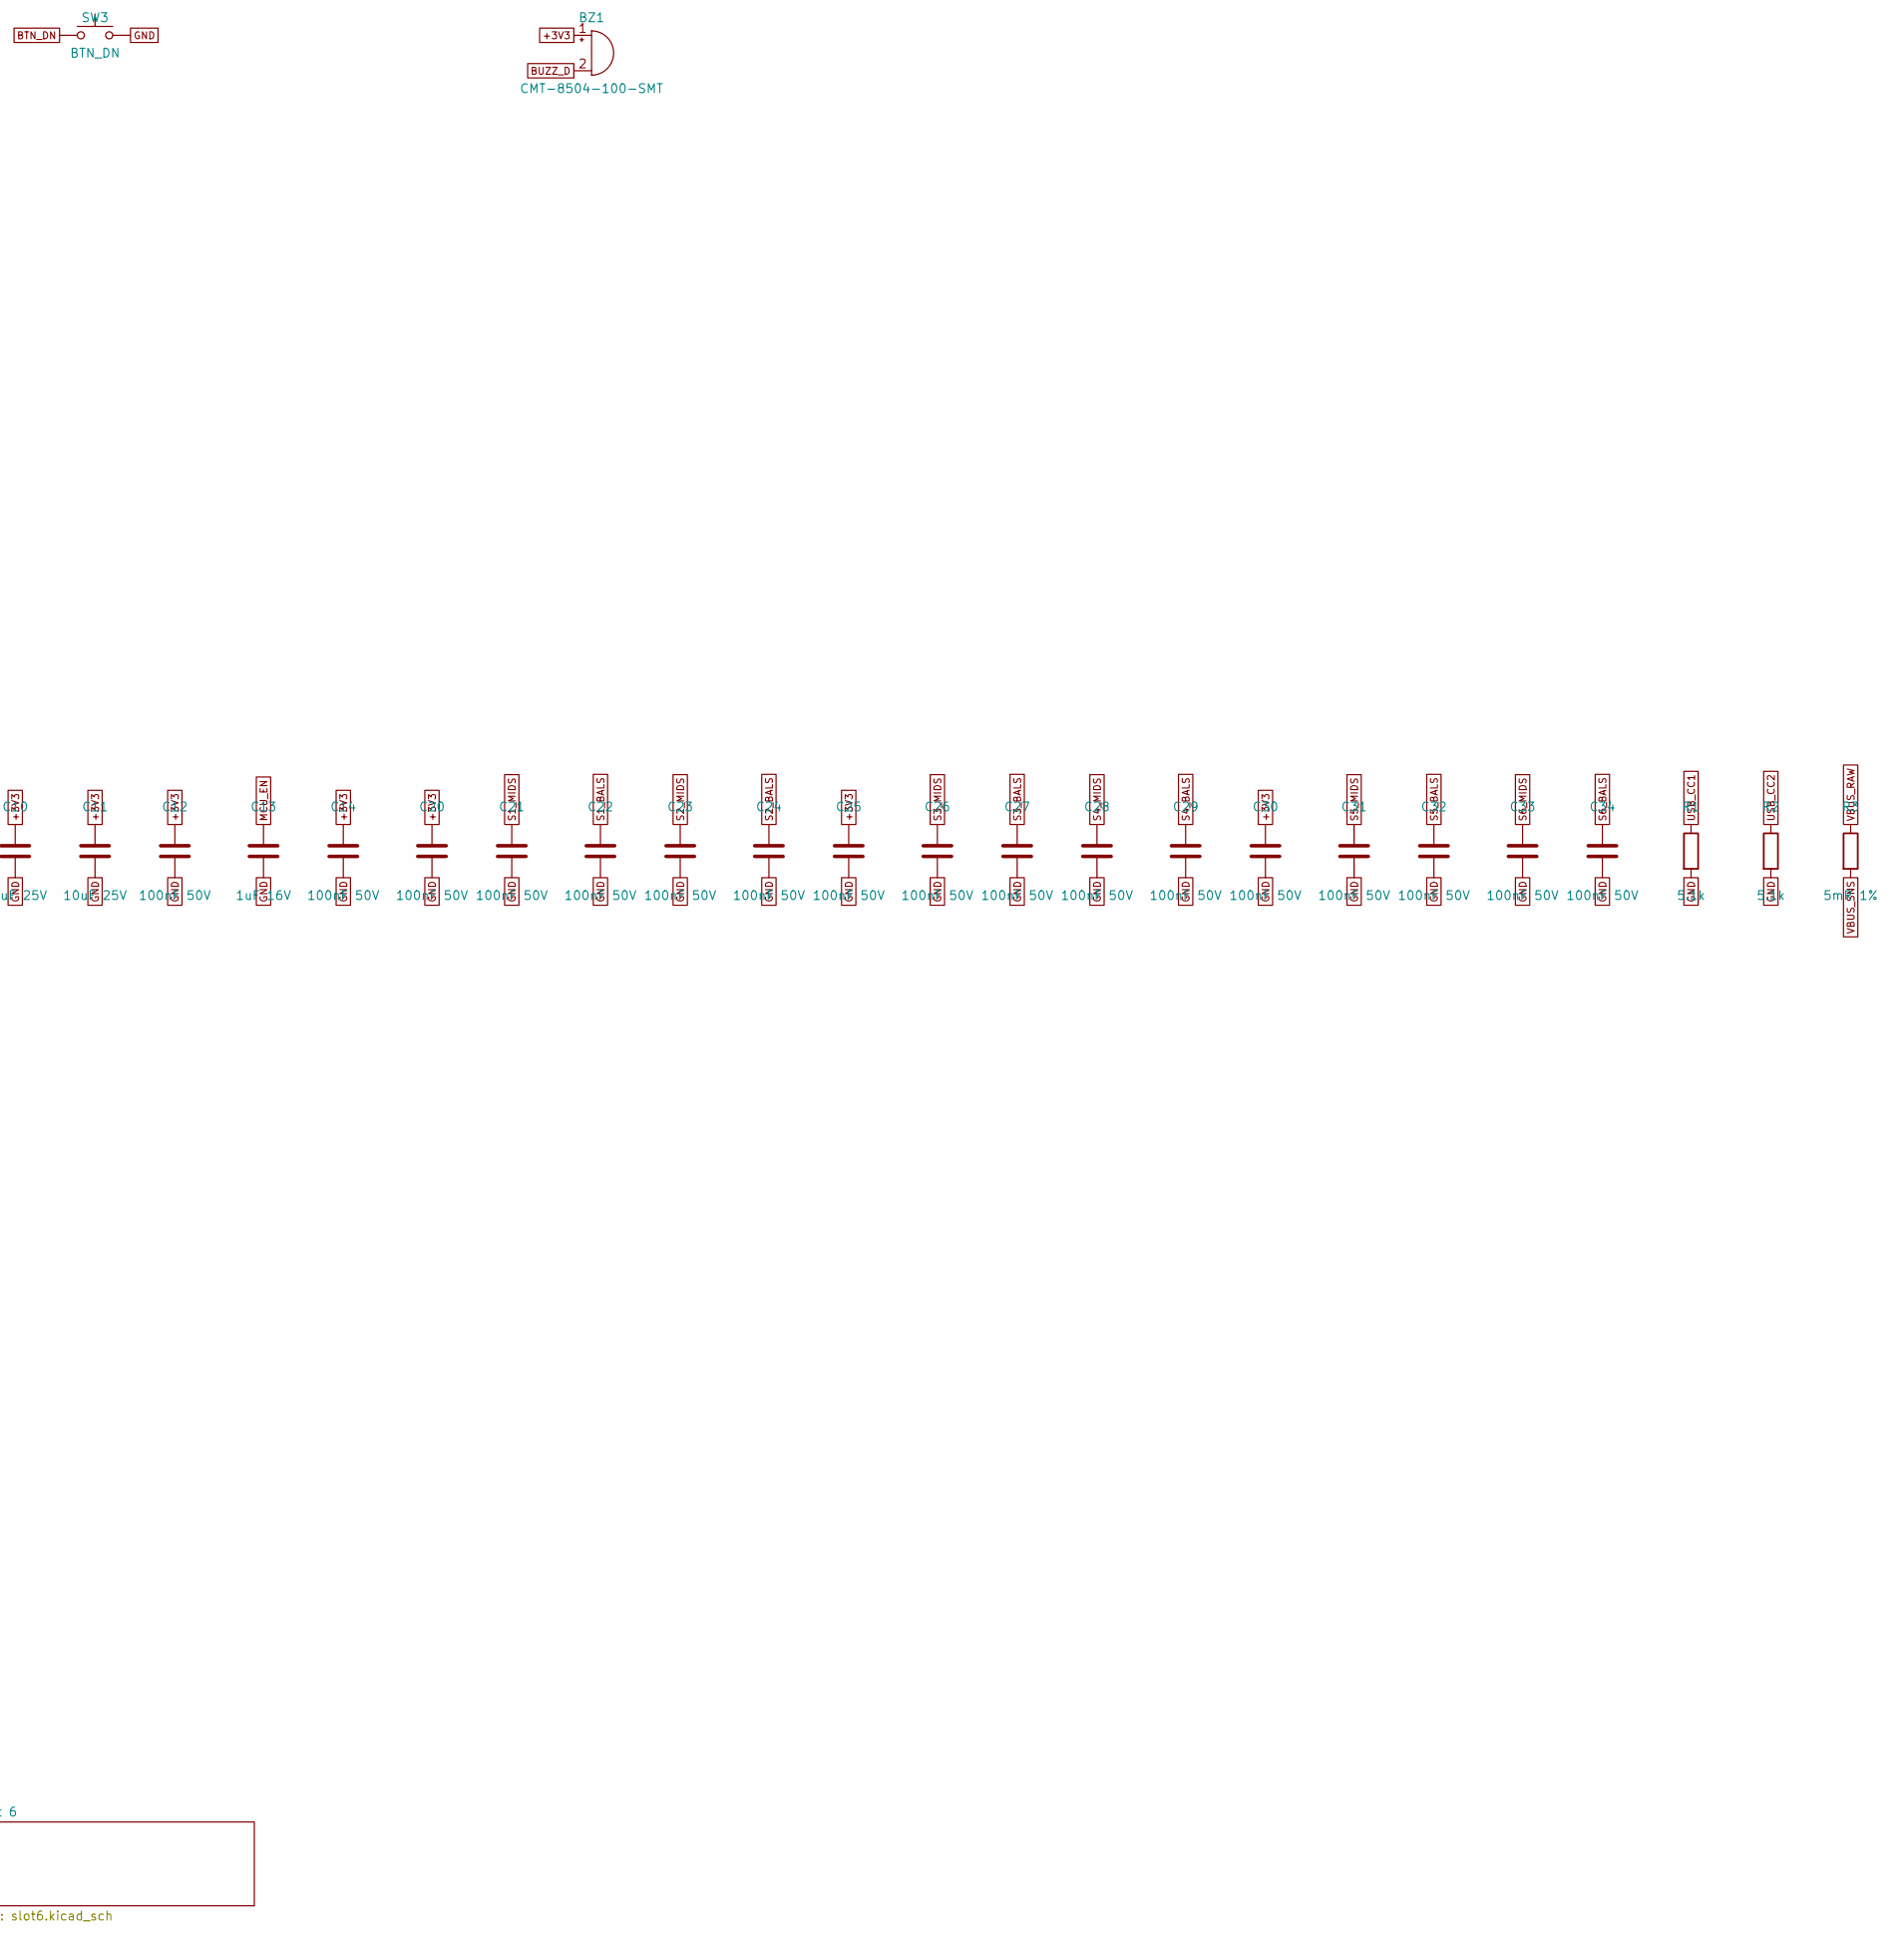
[picture p15: schematic lipo-charger.kicad_sch, 6-slot 1S/2S USB-C LiPo charger - power input, MCU, UI, part in row 2, column 2]

Parts:
BZ1: CMT-8504-100-SMT; MagneticBuzzer_CUI_CMT-8504-100-SMT; MPN CMT-8504-100-SMT-TR
C1, C8, C12, C14, C20, C21, C22, C23, C24, C25, C26, C27, C28, C29, C30, C31, C32, C33, C34: 100nF 50V; C_0402_1005Metric; MPN CL05B104KB54PNC; LCSC C307331
C2: 1uF 50V; C_0603_1608Metric; MPN CL10A105KB8NNNC; LCSC C15849
C3, C13: 1uF 16V; C_0402_1005Metric; MPN CL05A105KA5NQNC; LCSC C52923
C4, C5, C6, C7, C11: 10uF 25V; C_0805_2012Metric; MPN CL21A106KAYNNNE; LCSC C15850
C9, C10: 22uF 25V; C_0805_2012Metric; MPN CL21A226MAQNNNE; LCSC C45783
D1: PD OK (blue); LED_0603_1608Metric; MPN 19-217/BHC-ZL1M2RY/3T; LCSC C72041
D2: 1N4148WS; D_SOD-323; MPN 1N4148WS; LCSC C2128
J1: USB4105-GF-A; USB_C_Receptacle_GCT_USB4105-xx-A_16P_TopMnt_Horizontal; MPN USB4105-GF-A; LCSC C3020560
J2: OLED 0.96in SSD1306 (GND VCC SCL SDA); PinHeader_1x04_P2.54mm_Vertical
J3: UART (TX RX GND); PinHeader_1x03_P2.54mm_Vertical; not fitted
L1: 4.7uH 2A; L_Changjiang_FNR4030S; MPN FNR4030S4R7MT
Q1: AO3400A; SOT-23; MPN AO3400A; LCSC C20917
Q2: 2N7002; SOT-23; MPN 2N7002; LCSC C8545
R1, R2: 5.1k; R_0402_1005Metric; MPN 0402WGF5101TCE; LCSC C25905
R3: 5mR 1%; R_1206_3216Metric; MPN PE1206FKF470R005Z
R4: 6.2k; R_0402_1005Metric; MPN 0402WGF6201TCE
R5: 200R; R_0402_1005Metric; MPN 0402WGF2000TCE; LCSC C25087
R6: 82k; R_0402_1005Metric; MPN 0402WGF8202TCE; LCSC C25958
R7, R17: 100k; R_0402_1005Metric; MPN 0402WGF1003TCE; LCSC C25741
R8: 2.2k; R_0402_1005Metric; MPN 0402WGF2201TCE; LCSC C25879
R9, R10, R11, R14, R15, R16, R18: 10k; R_0402_1005Metric; MPN 0402WGF1002TCE; LCSC C25744
R12, R13: 4.7k; R_0402_1005Metric; MPN 0402WGF4701TCE; LCSC C25900
SW1: BTN_UP; SW_SPST_PTS645Sx43SMTR92; MPN PTS645SM95SMTR92 LFS
SW2: BTN_OK; SW_SPST_PTS645Sx43SMTR92; MPN PTS645SM95SMTR92 LFS
SW3: BTN_DN; SW_SPST_PTS645Sx43SMTR92; MPN PTS645SM95SMTR92 LFS
U1: AP33771C; DFN-14-1EP_3x3mm_P0.4mm_EP1.78x2.35mm; MPN AP33771CFBZ-13-FA02
U2: AP63203WU; TSOT-23-6; MPN AP63203WU-7; LCSC C780769
U3: ESP32-C3-WROOM-02-N4; ESP32-C3-WROOM-02; MPN ESP32-C3-WROOM-02-N4; LCSC C2934560
U4: USBLC6-2SC6; SOT-23-6; MPN USBLC6-2SC6; LCSC C7519
U5: TCA9548APWR; TSSOP-24_4.4x7.8mm_P0.65mm; MPN TCA9548APWR; LCSC C130026
U6, U7, U8: ADS1115; TSSOP-10_3x3mm_P0.5mm; MPN ADS1115IDGSR; LCSC C37593

Connections:
+3V3: BZ1.1 (+), C9.1, C10.1, C11.1, C12.1, C14.1, C20.1, C25.1, C30.1, D2.1 (K), J2.2, L1.2, R9.1, R10.1, R11.1, R12.1, R13.1, R14.1, R15.1, R16.1, R18.1, U2.1 (FB), U3.1 (3V3), U4.5 (VBUS), U5.24 (VCC), U6.8 (VDD), U7.1 (ADDR), U7.8 (VDD), U8.8 (VDD); also elsewhere on the board
BTN_DN: R16.2, SW3.1, U3.10 (IO10)
BTN_OK: R15.2, SW2.1, U3.8 (IO9)
BTN_UP: R14.2, SW1.1, U3.7 (IO8)
BUCK_BST: C8.1, U2.6 (BST)
BUCK_SW: C8.2, L1.1, U2.5 (SW)
BUZZ: Q2.1 (G), R17.1, U3.15 (IO3)
BUZZ_D: BZ1.2 (-), D2.2 (A), Q2.3 (D)
CE_ALL_N: R11.2, U3.17 (IO1); also elsewhere on the board
GND: C2.2, C3.2, C4.2, C5.2, C6.2, C7.2, C9.2, C10.2, C11.2, C12.2, C13.2, C14.2, C20.2, C21.2, C22.2, C23.2, C24.2, C25.2, C26.2, C27.2, C28.2, C29.2, C30.2, C31.2, C32.2, C33.2, C34.2, D1.1 (K), J1.A1 (GND), J1.A12 (GND), J1.B1 (GND), J1.B12 (GND), J1.SH (SHIELD), J2.1, J3.3, Q2.2 (S), R1.2, R2.2, R6.2, R7.2, R17.2, SW1.2, SW2.2, SW3.2, U1.5 (GND), U1.15 (EPAD), U2.4 (GND), U3.9 (GND), U3.19 (GND), U4.2 (GND), U5.1 (A0), U5.2 (A1), U5.12 (GND), U5.21 (A2), U6.1 (ADDR), U6.3 (GND), U7.3 (GND), U8.3 (GND); also elsewhere on the board
I2C_SCL: J2.3, R13.2, U3.4 (IO5), U5.22 (SCL), U6.10 (SCL), U7.10 (SCL), U8.10 (SCL)
I2C_SDA: J2.4, R12.2, U3.3 (IO4), U5.23 (SDA), U6.9 (SDA), U7.9 (SDA), U8.1 (ADDR), U8.9 (SDA)
IO2_STRAP: R10.2, U3.16 (IO2)
MCU_EN: C13.1, R9.2, U3.2 (EN)
MUX_RST_N: R18.2, U3.5 (IO6), U5.3 (~RESET)
PD_GATE: C1.1, Q1.1 (G), R4.2
PD_ISEL: R7.1, U1.9 (ISEL)
PD_LED: R8.1, U1.7 (LED)
PD_LED_A: D1.2 (A), R8.2
PD_PWR_EN: R4.1, U1.2 (PWR_EN)
PD_V5V: C3.1, U1.14 (V5V)
PD_VOUT: R5.1, U1.1 (VOUT)
PD_VSEL: R6.1, U1.8 (VSEL)
S1_BALS: C22.1, U6.5 (AIN1); also elsewhere on the board
S1_MIDS: C21.1, U6.4 (AIN0); also elsewhere on the board
S1_SCL: U5.5 (SC0); also elsewhere on the board
S1_SDA: U5.4 (SD0); also elsewhere on the board
S2_BALS: C24.1, U6.7 (AIN3); also elsewhere on the board
S2_MIDS: C23.1, U6.6 (AIN2); also elsewhere on the board
S2_SCL: U5.7 (SC1); also elsewhere on the board
S2_SDA: U5.6 (SD1); also elsewhere on the board
S3_BALS: C27.1, U7.5 (AIN1); also elsewhere on the board
S3_MIDS: C26.1, U7.4 (AIN0); also elsewhere on the board
S3_SCL: U5.9 (SC2); also elsewhere on the board
S3_SDA: U5.8 (SD2); also elsewhere on the board
S4_BALS: C29.1, U7.7 (AIN3); also elsewhere on the board
S4_MIDS: C28.1, U7.6 (AIN2); also elsewhere on the board
S4_SCL: U5.11 (SC3); also elsewhere on the board
S4_SDA: U5.10 (SD3); also elsewhere on the board
S5_BALS: C32.1, U8.5 (AIN1); also elsewhere on the board
S5_MIDS: C31.1, U8.4 (AIN0); also elsewhere on the board
S5_SCL: U5.14 (SC4); also elsewhere on the board
S5_SDA: U5.13 (SD4); also elsewhere on the board
S6_BALS: C34.1, U8.7 (AIN3); also elsewhere on the board
S6_MIDS: C33.1, U8.6 (AIN2); also elsewhere on the board
S6_SCL: U5.16 (SC5); also elsewhere on the board
S6_SDA: U5.15 (SD5); also elsewhere on the board
UART_RX: J3.2, U3.11 (IO20/RXD)
UART_TX: J3.1, U3.12 (IO21/TXD)
USB_CC1: J1.A5 (CC1), R1.1, U1.11 (CC1)
USB_CC2: J1.B5 (CC2), R2.1, U1.10 (CC2)
USB_DN: J1.A7 (D-), J1.B7 (D-), U3.13 (IO18), U4.1 (I/O1), U4.6 (I/O1)
USB_DP: J1.A6 (D+), J1.B6 (D+), U3.14 (IO19), U4.3 (I/O2), U4.4 (I/O2)
VBUS_PD: C1.2, C5.1, C6.1, C7.1, Q1.2 (S), R5.2, U2.2 (EN), U2.3 (IN); also elsewhere on the board
VBUS_RAW: C4.1, J1.A4 (VBUS), J1.A9 (VBUS), J1.B4 (VBUS), J1.B9 (VBUS), R3.1, U1.4 (ISENP)
VBUS_SNS: C2.1, Q1.3 (D), R3.2, U1.3 (VCC)

Notes on the sheet:
USB-C PD input (AP33771C asks for 9 V), 3.3 V buck, ESP32-C3, OLED + 3 buttons, I2C mux to the six slots. Label-style schematic generated from design.py: pins with the same label are connected.
