Mirokuki/Battery-Charger/hardware/lipo-charger.kicad_pcb

## KiCad design hardware/lipo-charger.kicad_pcb (continued)

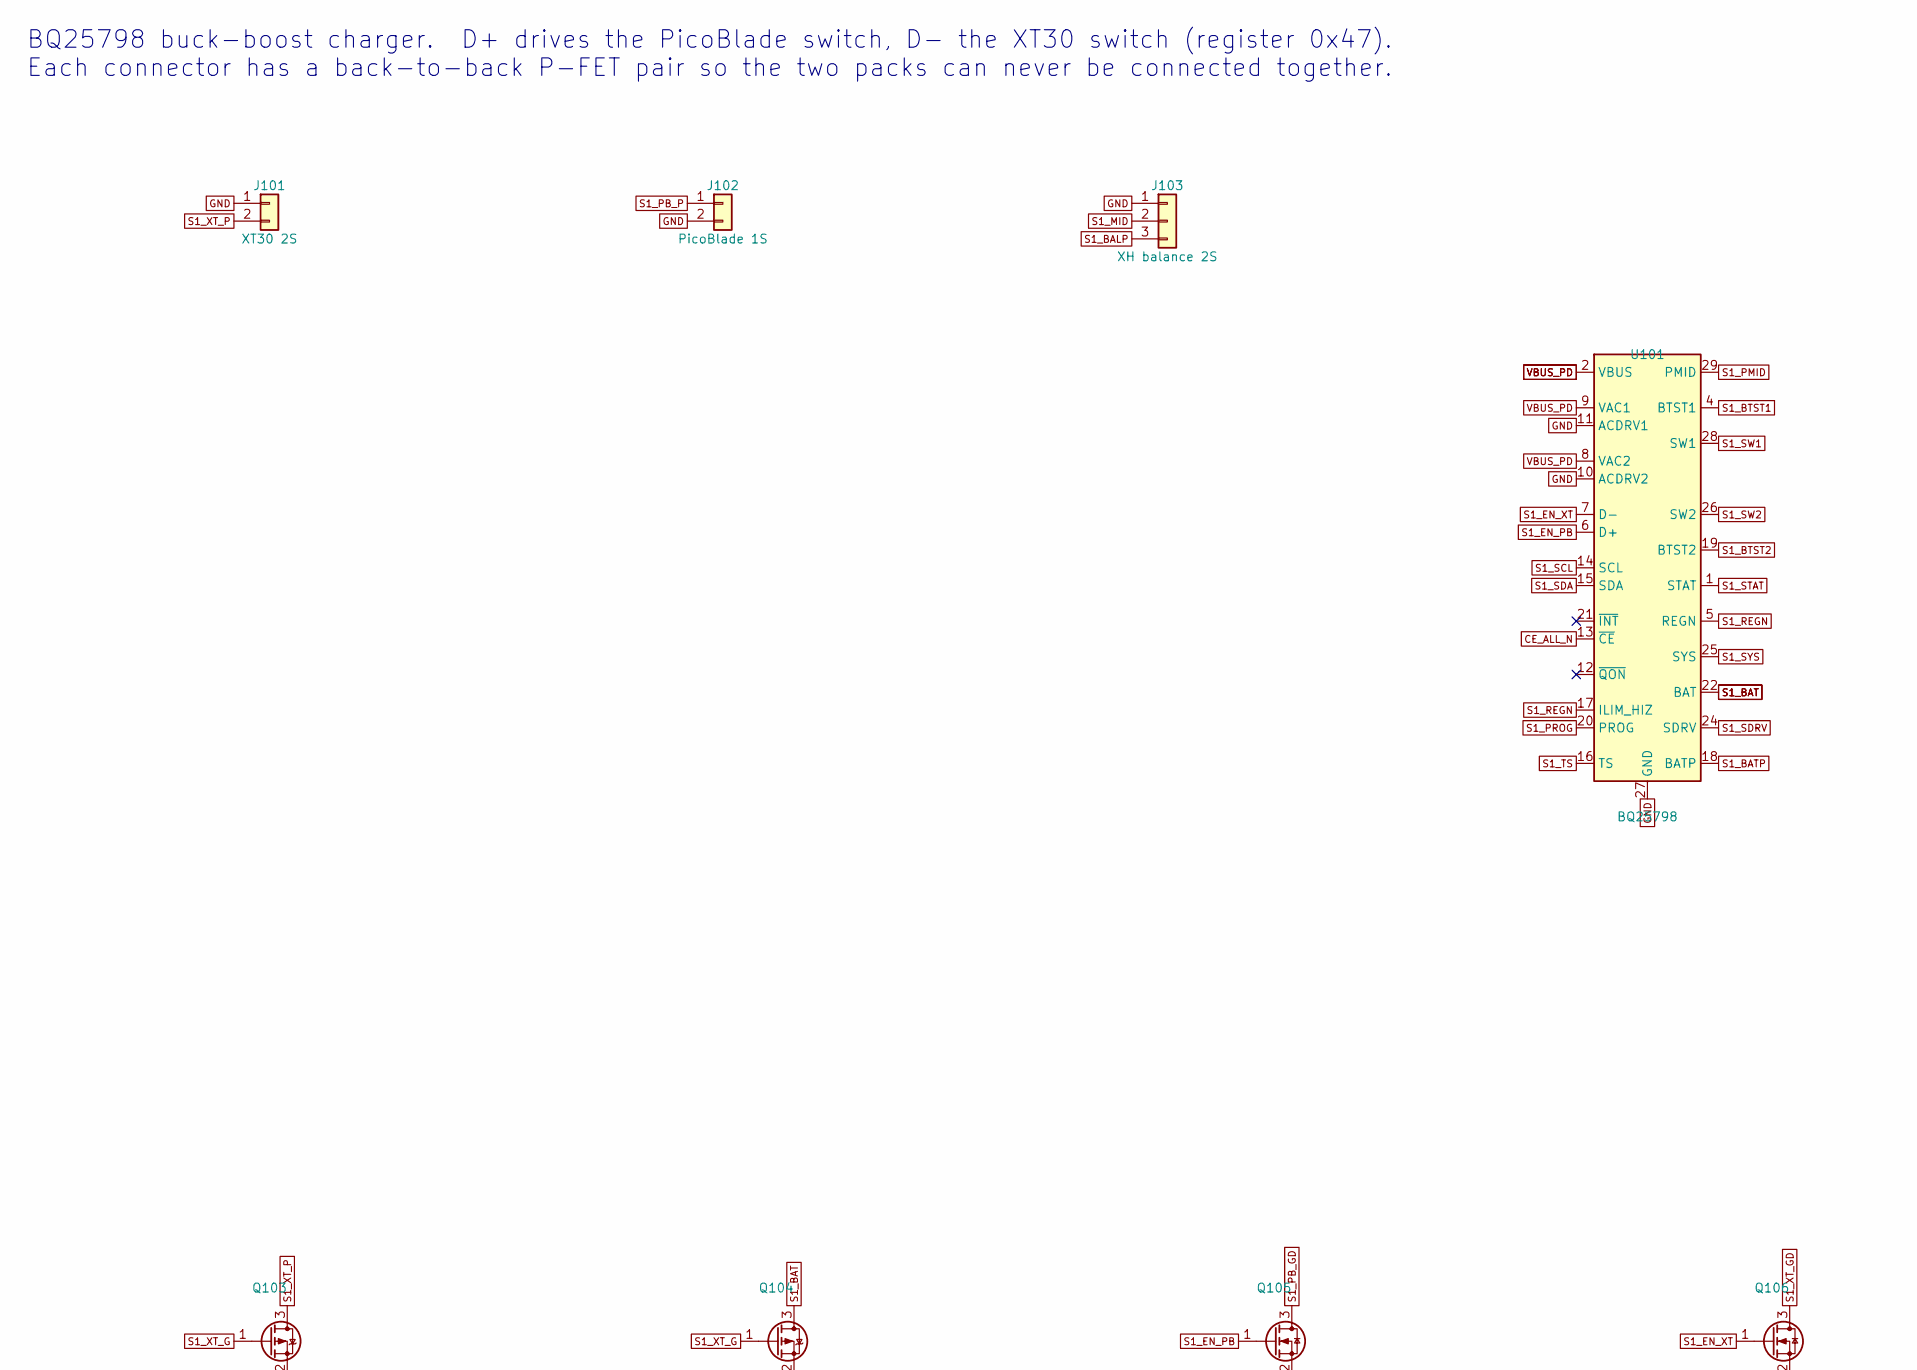
[picture p16: schematic slot1.kicad_sch, Charger slot 1: BQ25798 + PicoBlade (1S) / XT30 (2S) switch…, part in row 1, column 1]

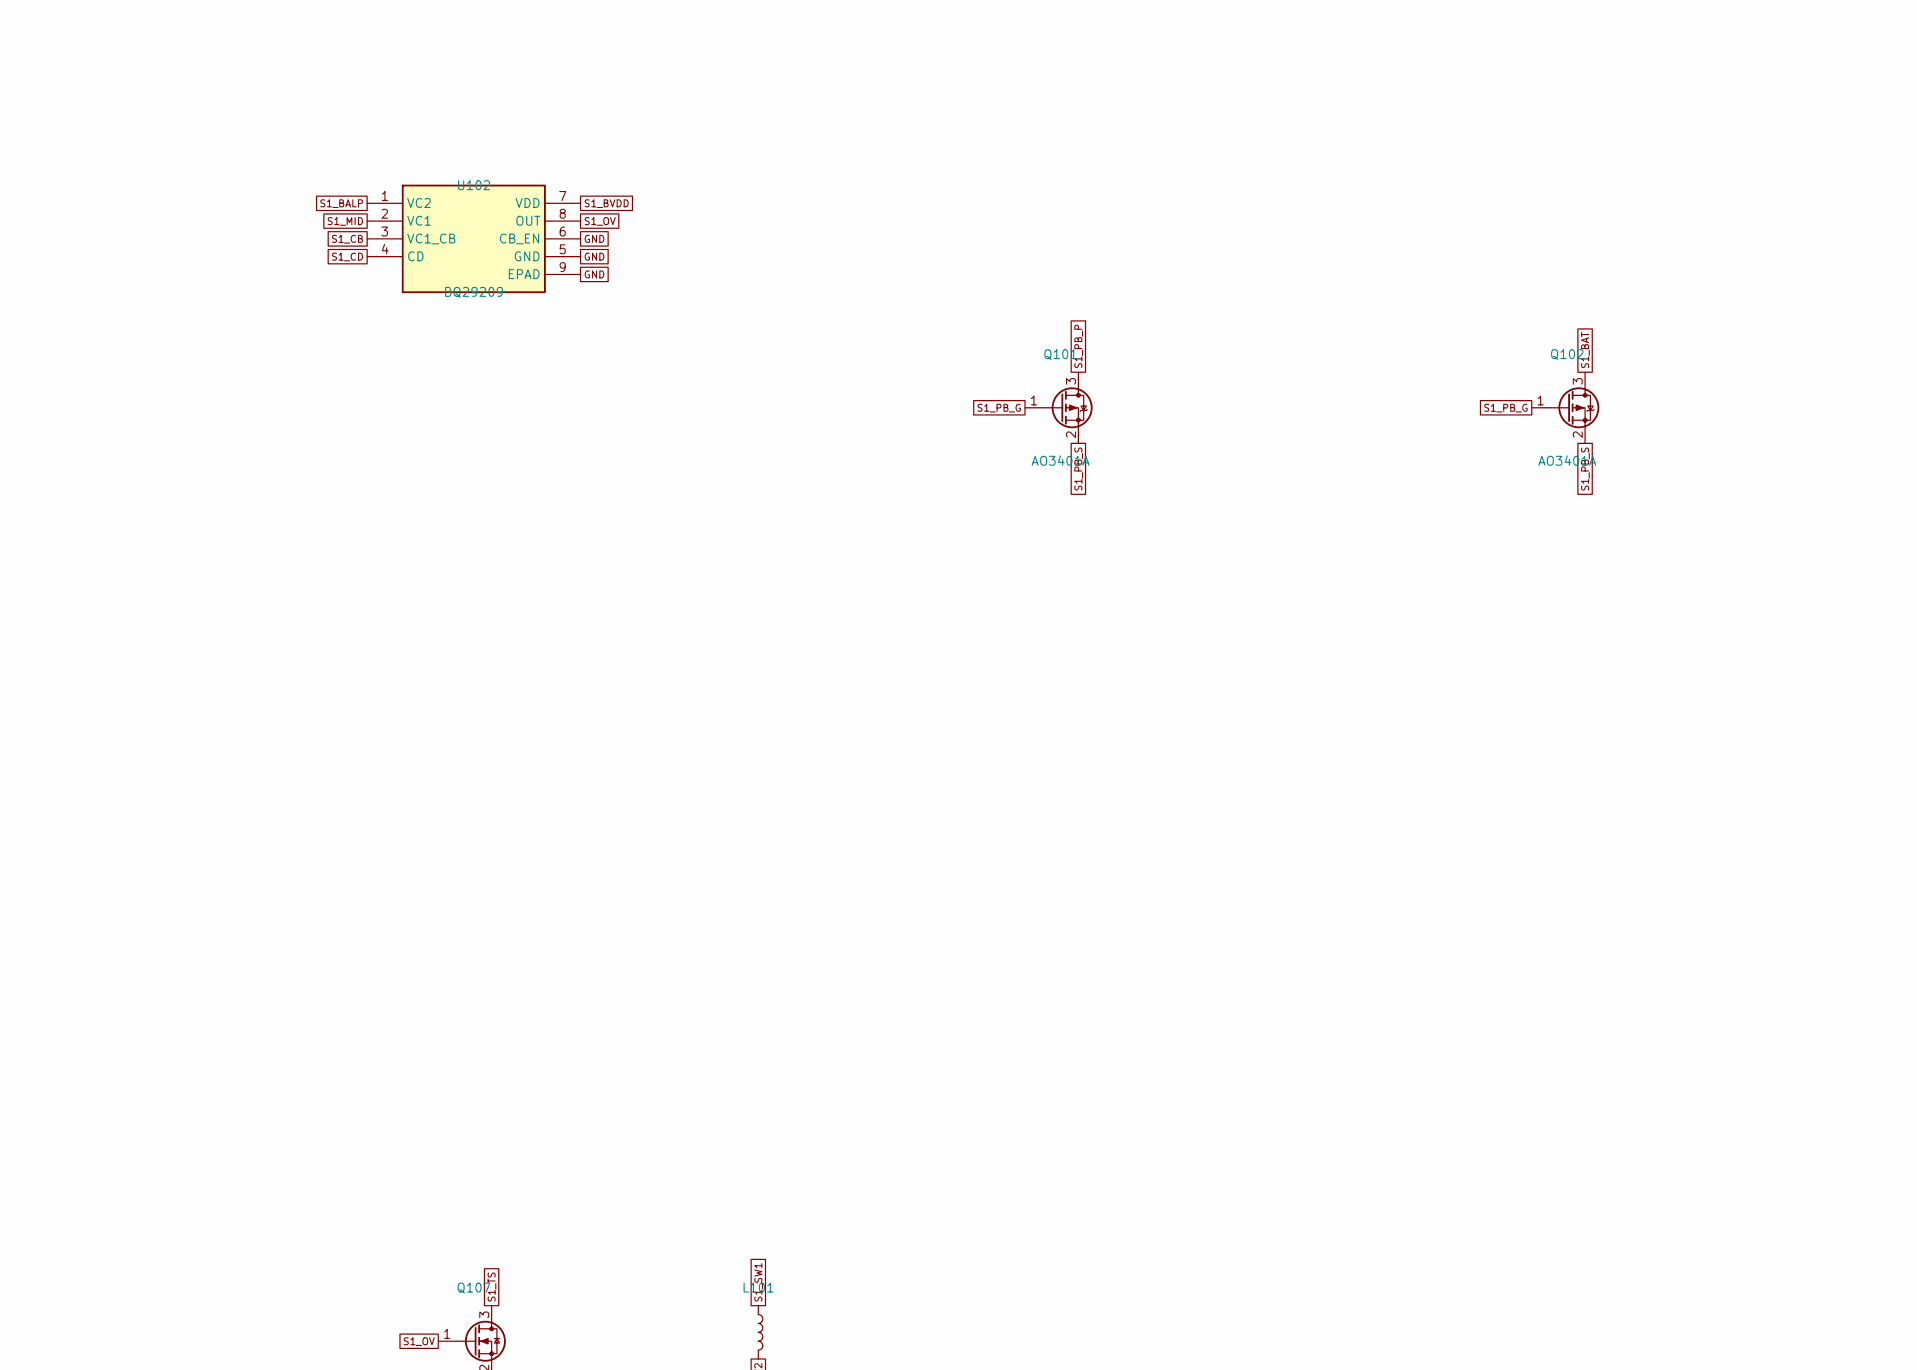
[picture p17: schematic slot1.kicad_sch, Charger slot 1: BQ25798 + PicoBlade (1S) / XT30 (2S) switch…, part in row 1, column 2]

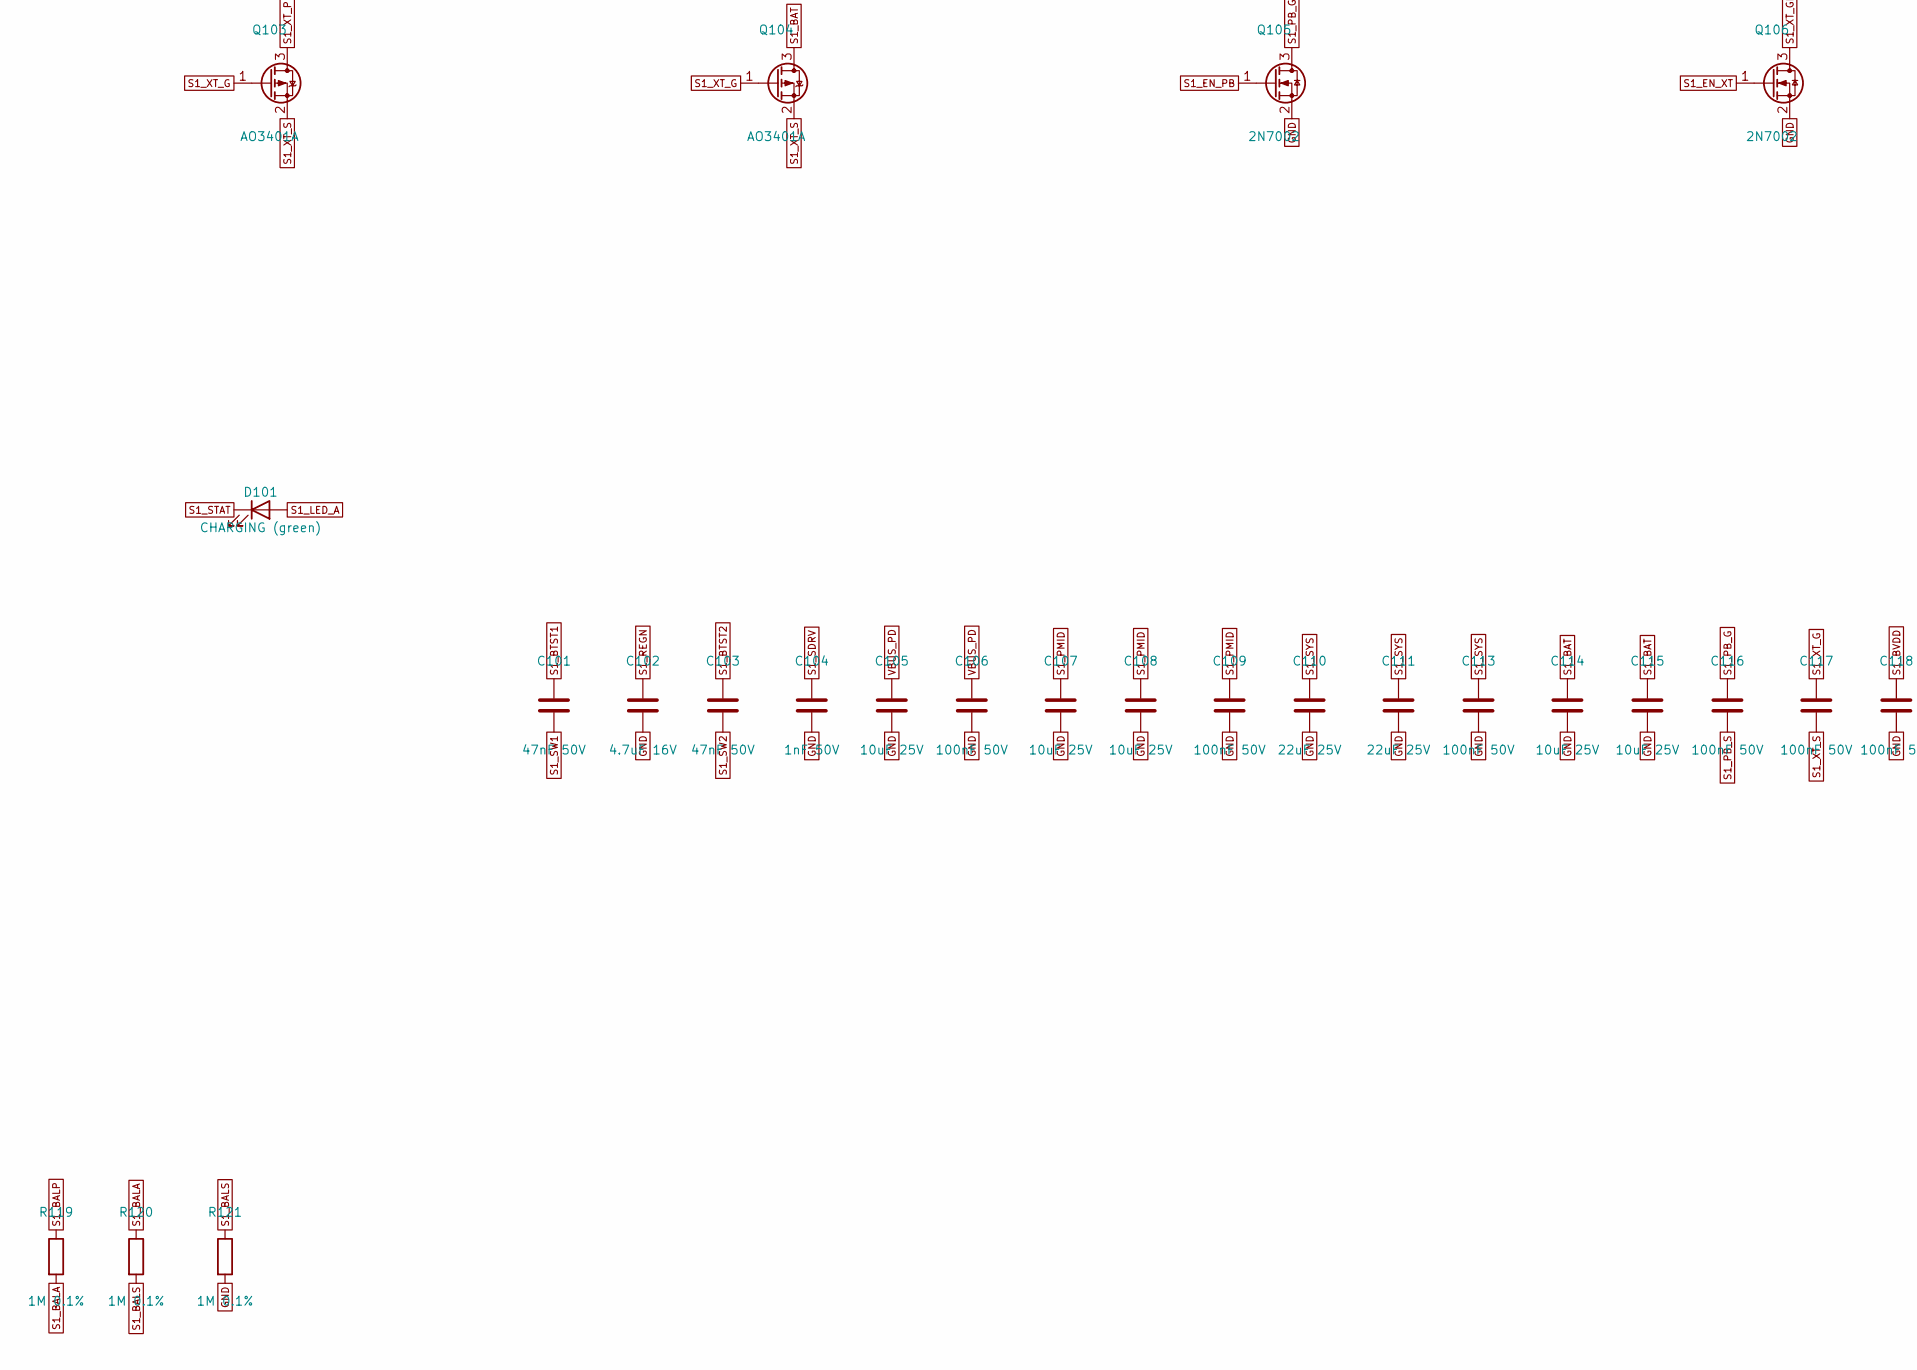
[picture p18: schematic slot1.kicad_sch, Charger slot 1: BQ25798 + PicoBlade (1S) / XT30 (2S) switch…, part in row 2, column 1]

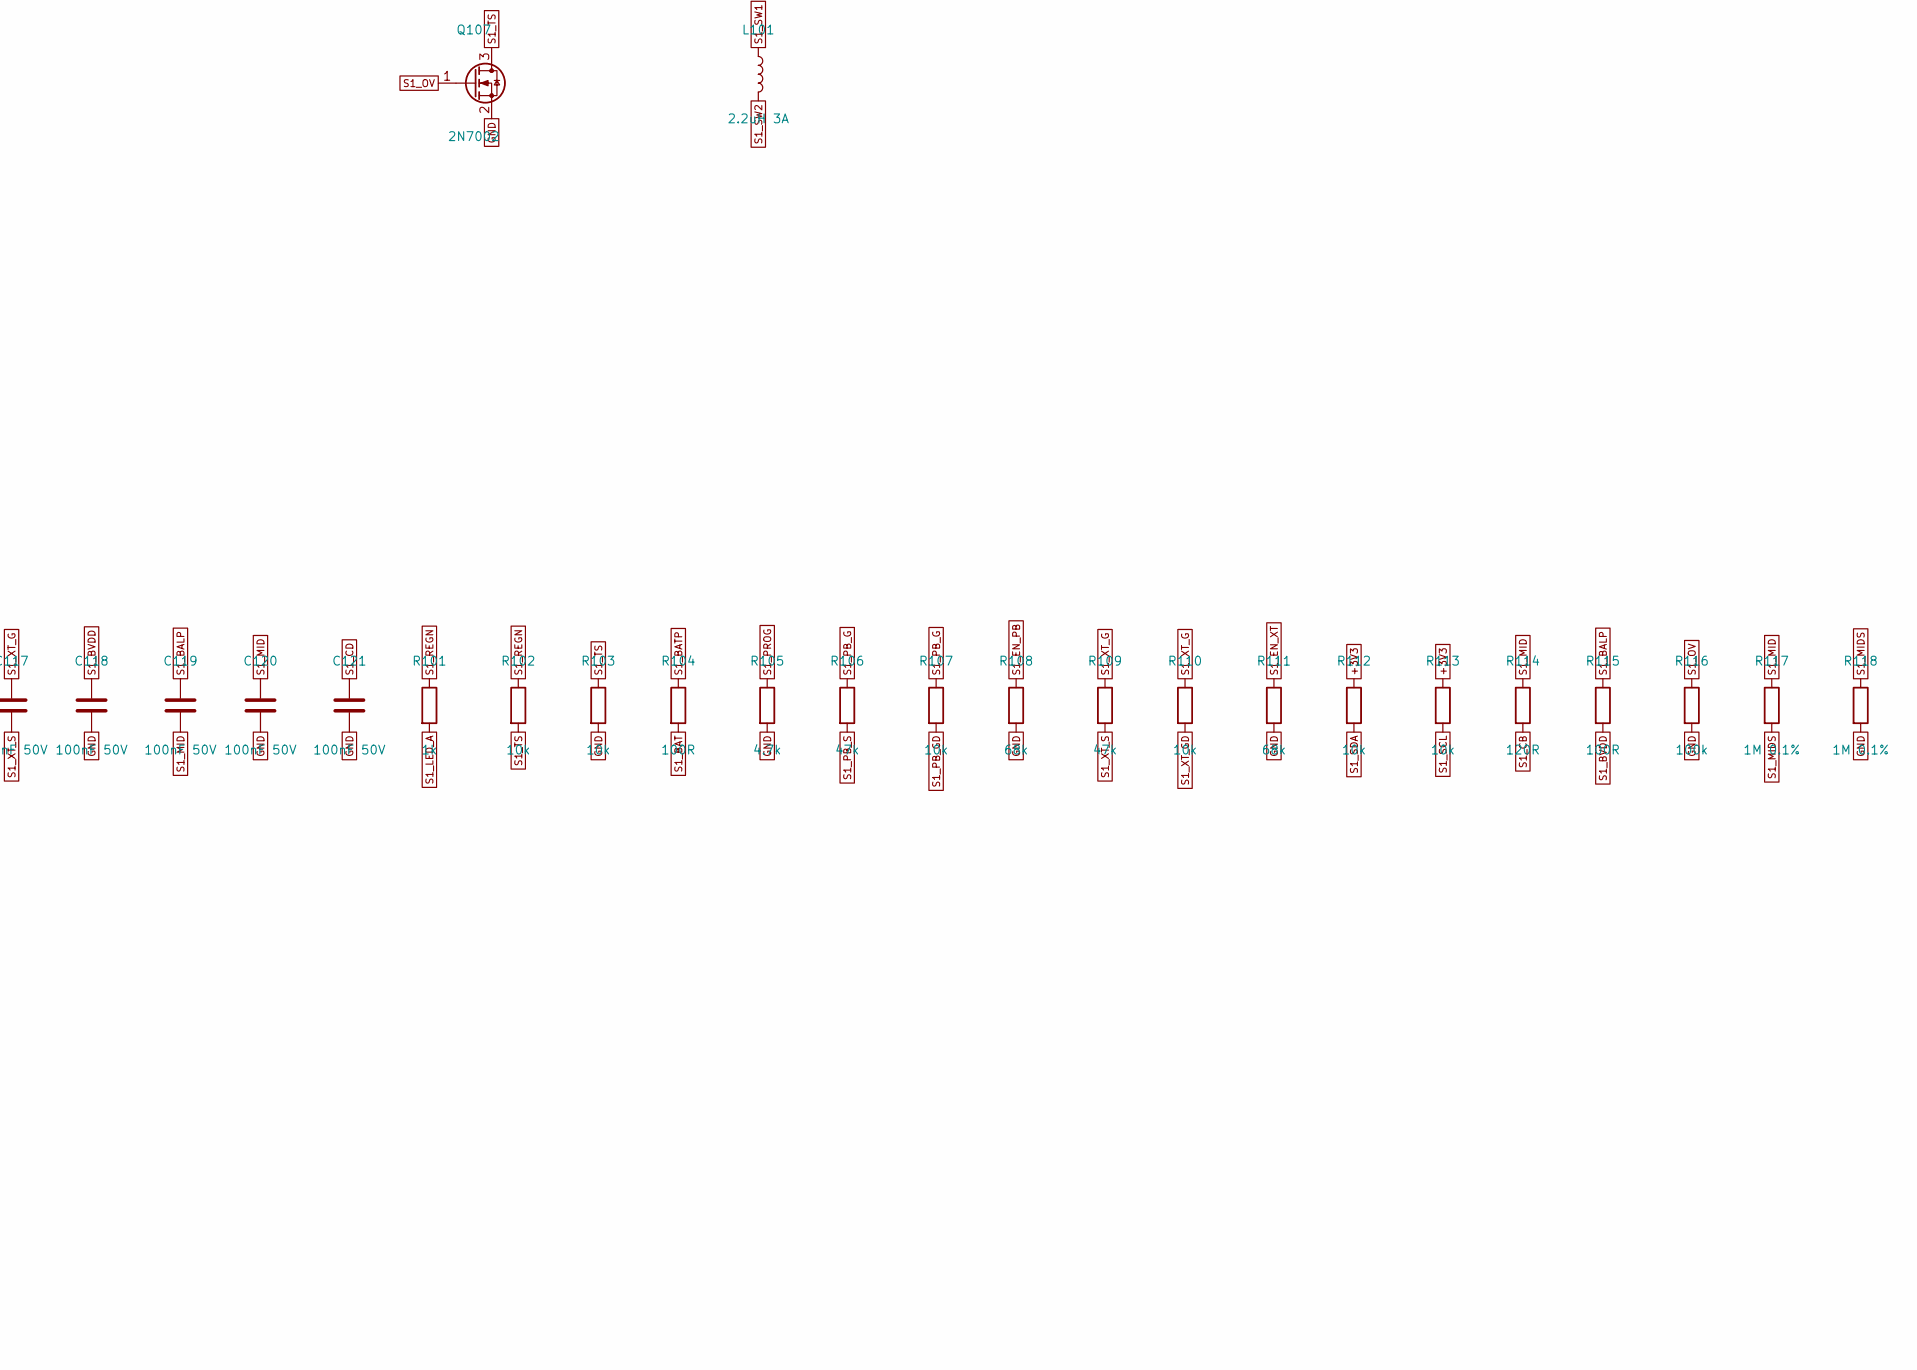
[picture p19: schematic slot1.kicad_sch, Charger slot 1: BQ25798 + PicoBlade (1S) / XT30 (2S) switch…, part in row 2, column 2]

Parts:
C101, C103: 47nF 50V; C_0402_1005Metric; MPN CL05B473KB5NNNC
C102: 4.7uF 16V; C_0603_1608Metric; MPN CL10A475KO8NNNC; LCSC C19666
C104: 1nF 50V; C_0402_1005Metric; MPN CL05B102KB5NNNC; LCSC C1523
C105, C107, C108, C114, C115: 10uF 25V; C_0805_2012Metric; MPN CL21A106KAYNNNE; LCSC C15850
C106, C109, C113, C116, C117, C118, C119, C120, C121: 100nF 50V; C_0402_1005Metric; MPN CL05B104KB54PNC; LCSC C307331
C110, C111: 22uF 25V; C_0805_2012Metric; MPN CL21A226MAQNNNE; LCSC C45783
D101: CHARGING (green); LED_0603_1608Metric; MPN 19-217/GHC-YR1S2/3T; LCSC C72043
J101: XT30 2S; AMASS_XT30UPB-M_1x02_P5.0mm_Vertical; MPN XT30UPB-M; LCSC C99101
J102: PicoBlade 1S; Molex_PicoBlade_53047-0210_1x02_P1.25mm_Vertical; MPN 0530470210
J103: XH balance 2S; JST_XH_B3B-XH-A_1x03_P2.50mm_Vertical; MPN B3B-XH-A; LCSC C144394
L101: 2.2uH 3A; L_Changjiang_FNR4030S; MPN FNR4030S2R2MT
Q101, Q102, Q103, Q104: AO3401A; SOT-23; MPN AO3401A; LCSC C15127
Q105, Q106, Q107: 2N7002; SOT-23; MPN 2N7002; LCSC C8545
R101: 1k; R_0402_1005Metric; MPN 0402WGF1001TCE; LCSC C11702
R102, R103, R107, R110, R112, R113: 10k; R_0402_1005Metric; MPN 0402WGF1002TCE; LCSC C25744
R104, R115: 100R; R_0402_1005Metric; MPN 0402WGF1000TCE; LCSC C25076
R105: 4.7k; R_0402_1005Metric; MPN 0402WGF4701TCE; LCSC C25900
R106, R109: 47k; R_0402_1005Metric; MPN 0402WGF4702TCE; LCSC C25792
R108, R111: 68k; R_0402_1005Metric; MPN 0402WGF6802TCE; LCSC C36871
R114: 120R; R_0402_1005Metric; MPN 0402WGF1200TCE
R116: 100k; R_0402_1005Metric; MPN 0402WGF1003TCE; LCSC C25741
R117, R118, R119, R120, R121: 1M 0.1%; R_0402_1005Metric; MPN RT0402BRD071ML
U101: BQ25798; Texas_RQM0029A_VQFN-29_4x4mm_P0.4mm; MPN BQ25798RQMR; LCSC C2876768
U102: BQ29209; VSON-8-1EP_3x3mm_P0.65mm_EP1.65x2.4mm; MPN BQ29209DRBR

Connections:
+3V3: R112.1, R113.1; also elsewhere on the board
CE_ALL_N: U101.13 (~CE); also elsewhere on the board
GND: C102.2, C104.2, C105.2, C106.2, C107.2, C108.2, C109.2, C110.2, C111.2, C113.2, C114.2, C115.2, C118.2, C120.2, C121.2, J101.1, J102.2, J103.1, Q105.2 (S), Q106.2 (S), Q107.2 (S), R103.2, R105.2, R108.2, R111.2, R116.2, R118.2, R121.2, U101.10 (ACDRV2), U101.11 (ACDRV1), U101.27 (GND), U102.5 (GND), U102.6 (CB_EN), U102.9 (EPAD); also elsewhere on the board
S1_BALA: R119.2, R120.1
S1_BALP: C119.1, J103.3, R115.1, R119.1, U102.1 (VC2)
S1_BALS: R120.2, R121.1; also elsewhere on the board
S1_BAT: C114.1, C115.1, Q102.3 (D), Q104.3 (D), R104.2, U101.22 (BAT), U101.23 (BAT)
S1_BATP: R104.1, U101.18 (BATP)
S1_BTST1: C101.1, U101.4 (BTST1)
S1_BTST2: C103.1, U101.19 (BTST2)
S1_BVDD: C118.1, R115.2, U102.7 (VDD)
S1_CB: R114.2, U102.3 (VC1_CB)
S1_CD: C121.1, U102.4 (CD)
S1_EN_PB: Q105.1 (G), R108.1, U101.6 (D+)
S1_EN_XT: Q106.1 (G), R111.1, U101.7 (D-)
S1_LED_A: D101.2 (A), R101.2
S1_MID: C119.2, C120.1, J103.2, R114.1, R117.1, U102.2 (VC1)
S1_MIDS: R117.2, R118.1; also elsewhere on the board
S1_OV: Q107.1 (G), R116.1, U102.8 (OUT)
S1_PB_G: C116.1, Q101.1 (G), Q102.1 (G), R106.1, R107.1
S1_PB_GD: Q105.3 (D), R107.2
S1_PB_P: J102.1, Q101.3 (D)
S1_PB_S: C116.2, Q101.2 (S), Q102.2 (S), R106.2
S1_PMID: C107.1, C108.1, C109.1, U101.29 (PMID)
S1_PROG: R105.1, U101.20 (PROG)
S1_REGN: C102.1, R101.1, R102.1, U101.5 (REGN), U101.17 (ILIM_HIZ)
S1_SCL: R113.2, U101.14 (SCL); also elsewhere on the board
S1_SDA: R112.2, U101.15 (SDA); also elsewhere on the board
S1_SDRV: C104.1, U101.24 (SDRV)
S1_STAT: D101.1 (K), U101.1 (STAT)
S1_SW1: C101.2, L101.1, U101.28 (SW1)
S1_SW2: C103.2, L101.2, U101.26 (SW2)
S1_SYS: C110.1, C111.1, C113.1, U101.25 (SYS)
S1_TS: Q107.3 (D), R102.2, R103.1, U101.16 (TS)
S1_XT_G: C117.1, Q103.1 (G), Q104.1 (G), R109.1, R110.1
S1_XT_GD: Q106.3 (D), R110.2
S1_XT_P: J101.2, Q103.3 (D)
S1_XT_S: C117.2, Q103.2 (S), Q104.2 (S), R109.2
VBUS_PD: C105.1, C106.1, U101.2 (VBUS), U101.3 (VBUS), U101.8 (VAC2), U101.9 (VAC1); also elsewhere on the board

Notes on the sheet:
BQ25798 buck-boost charger. D+ drives the PicoBlade switch, D- the XT30 switch (register 0x47). Each connector has a back-to-back P-FET pair so the two packs can never be connected together.
