Mirokuki/Battery-Charger/hardware/lipo-charger.kicad_pcb

## KiCad design hardware/lipo-charger.kicad_pcb (continued)

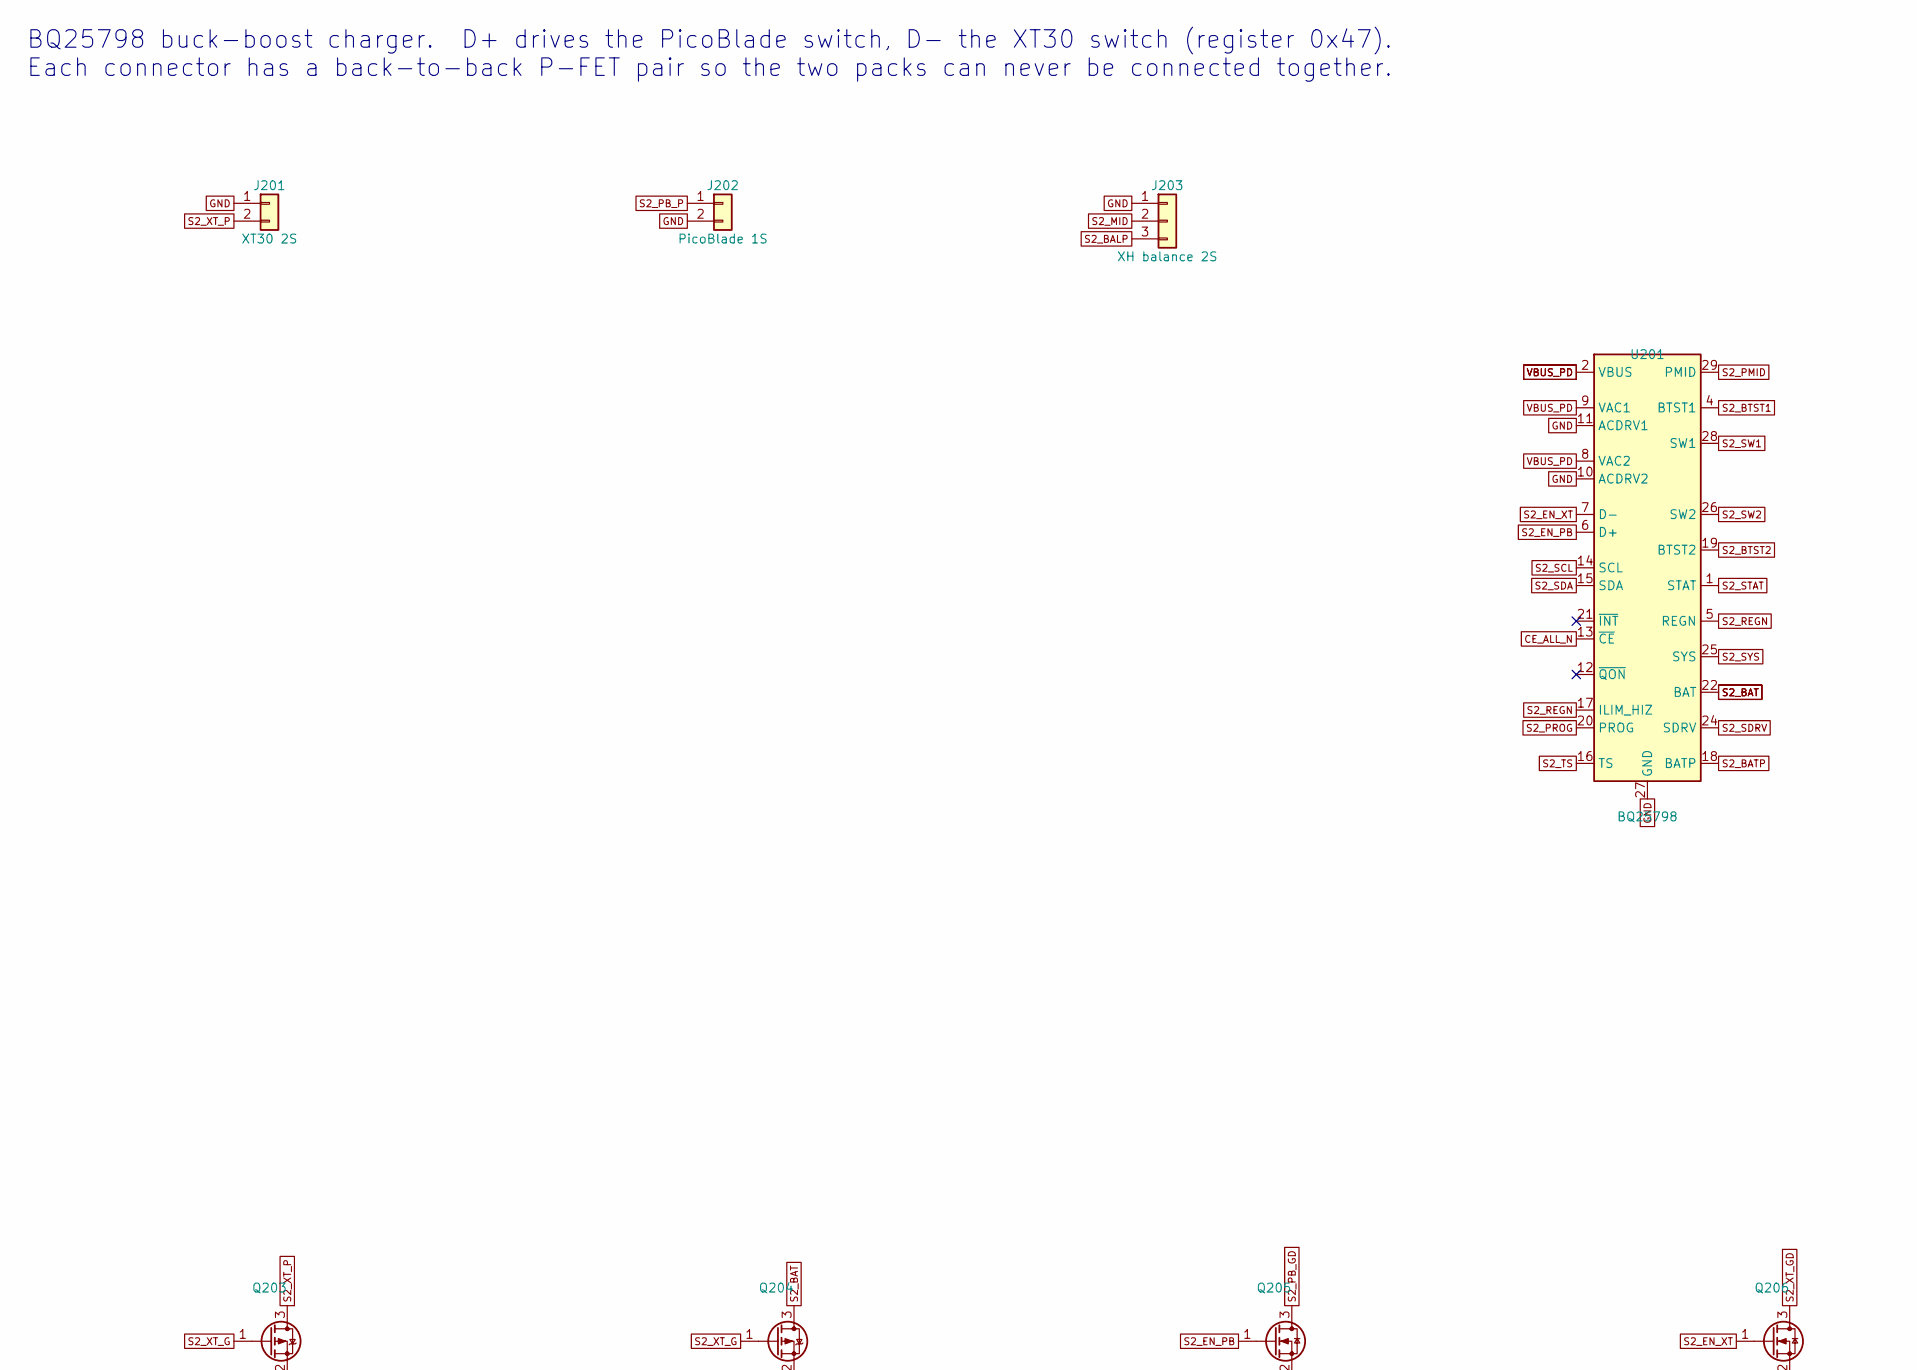
[picture p20: schematic slot2.kicad_sch, Charger slot 2: BQ25798 + PicoBlade (1S) / XT30 (2S) switch…, part in row 1, column 1]

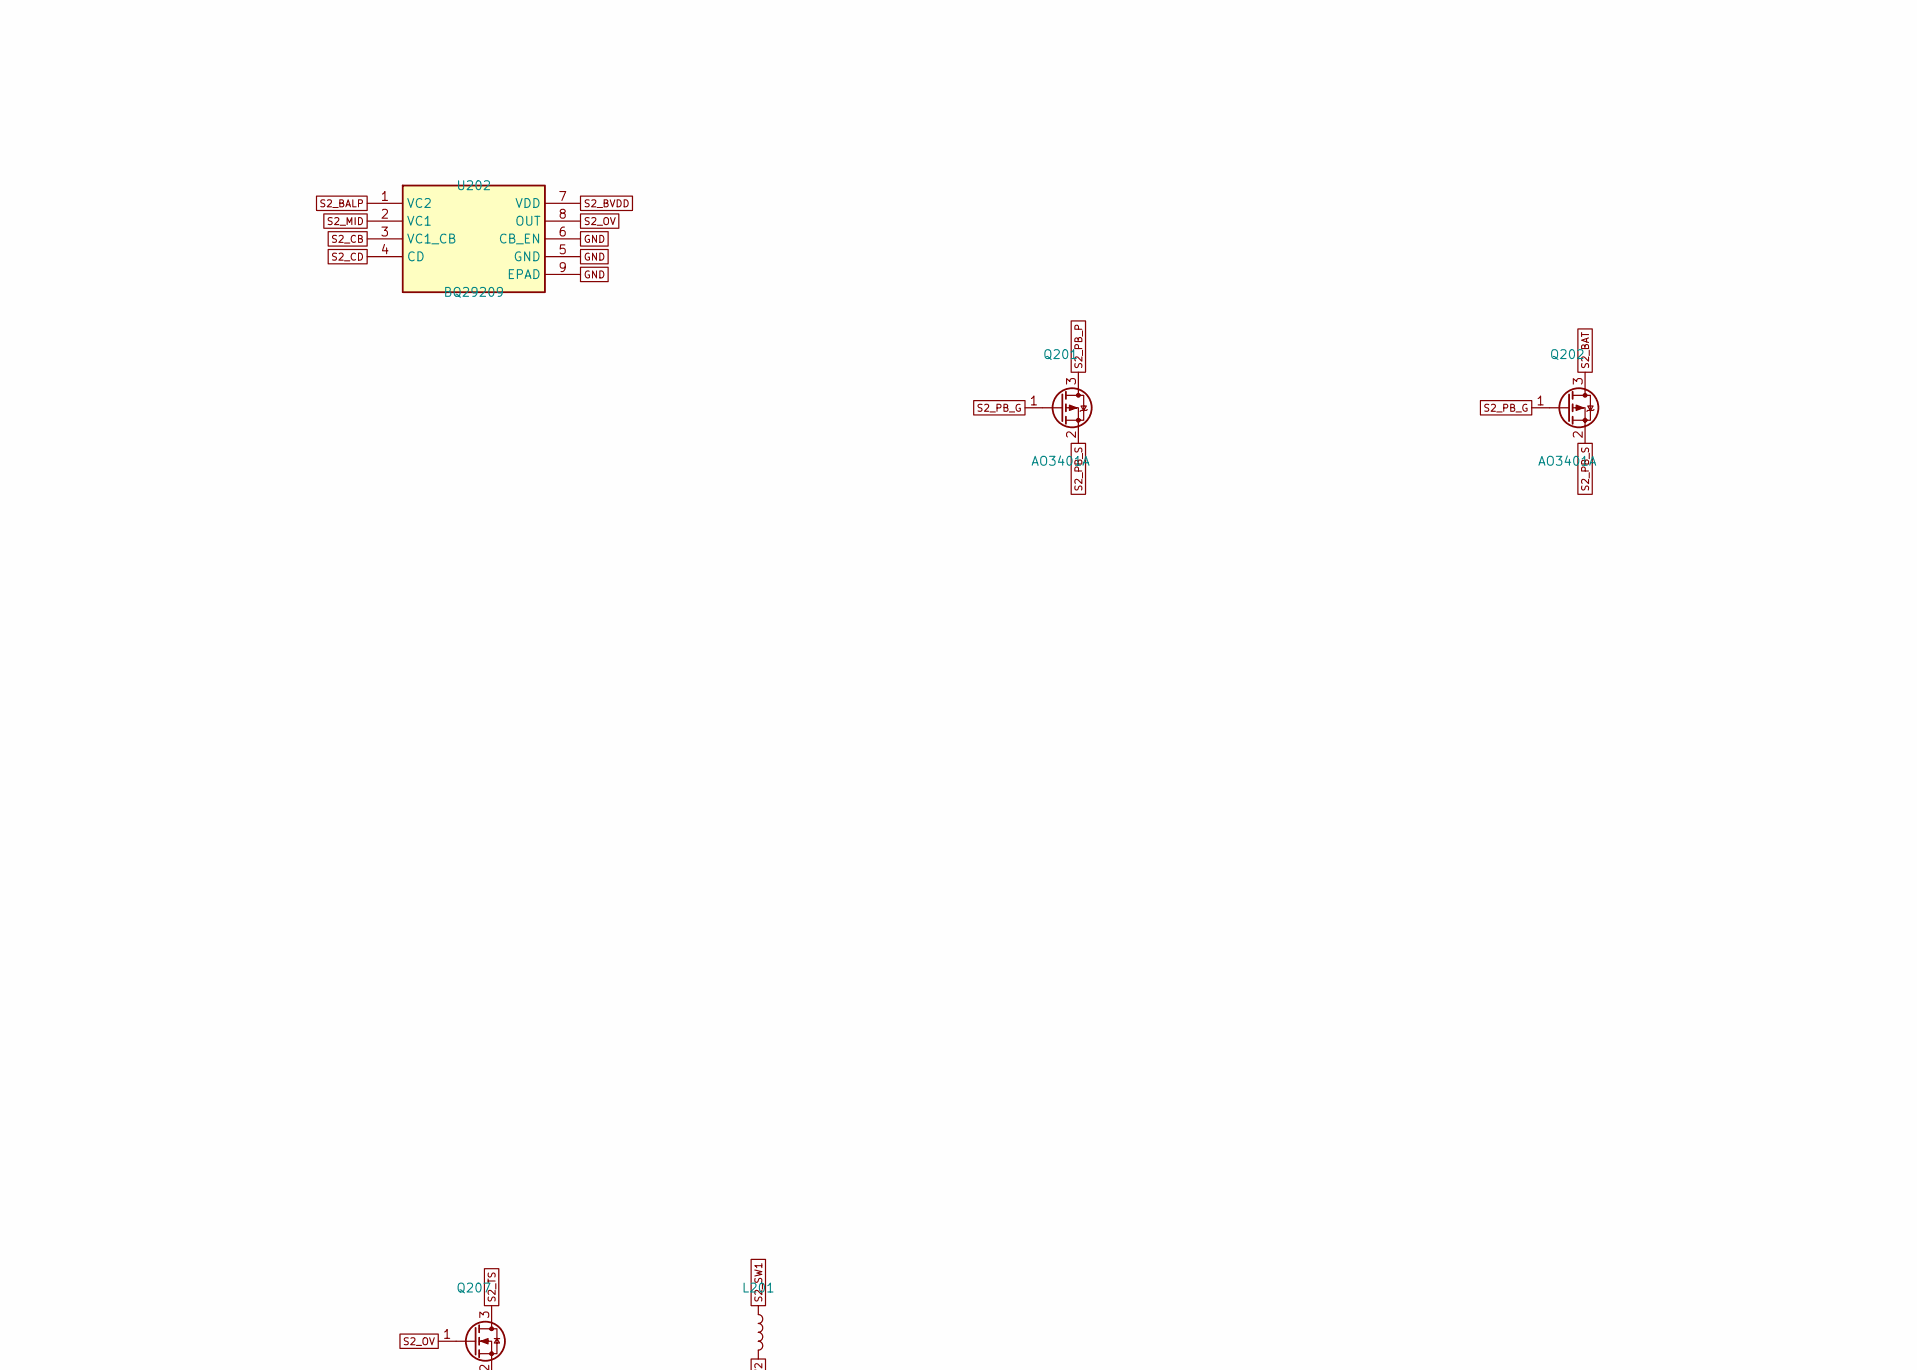
[picture p21: schematic slot2.kicad_sch, Charger slot 2: BQ25798 + PicoBlade (1S) / XT30 (2S) switch…, part in row 1, column 2]

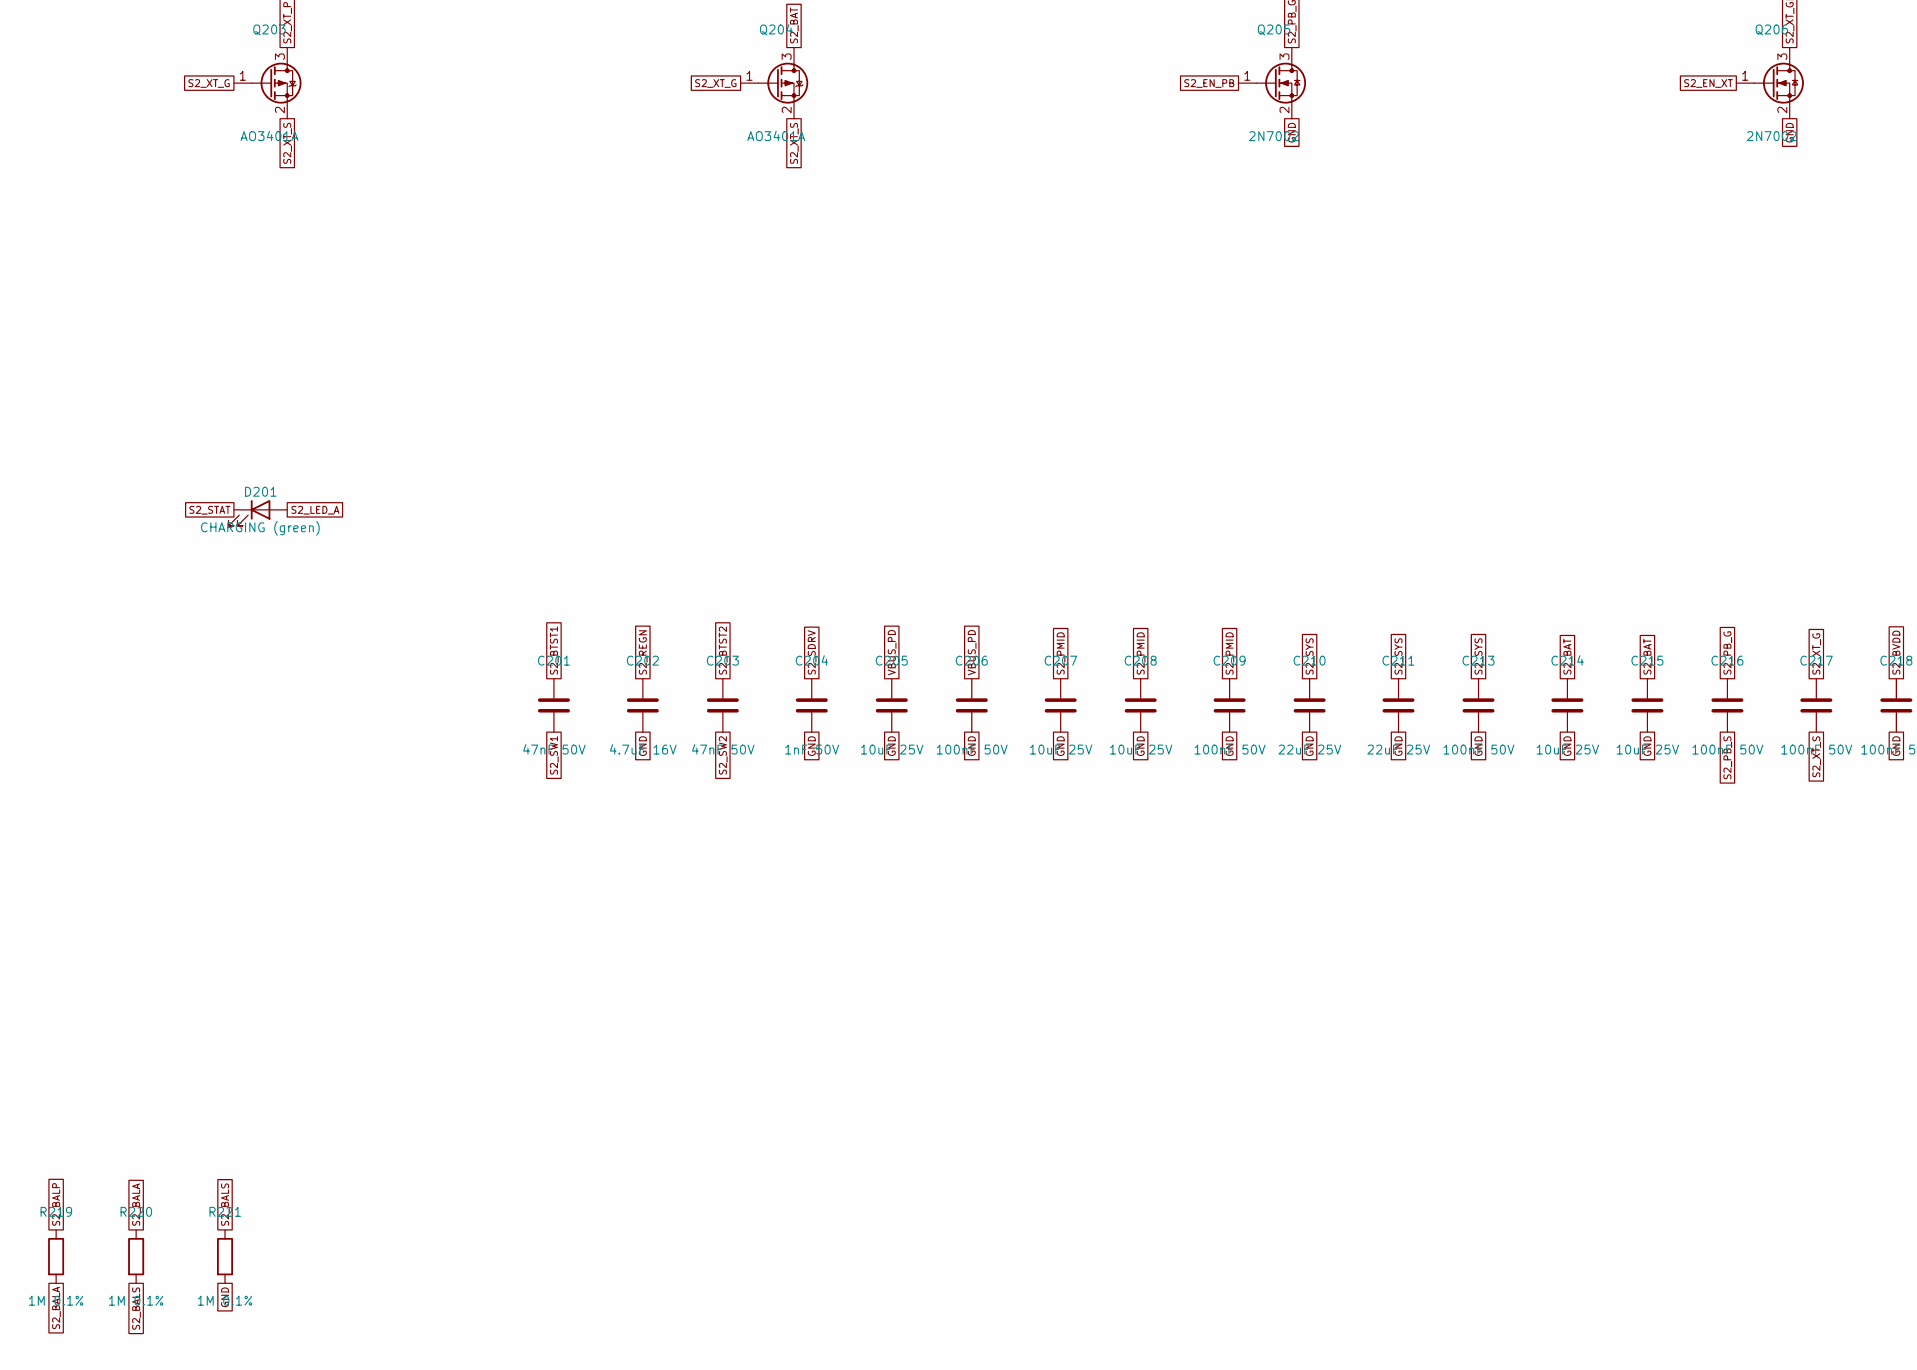
[picture p22: schematic slot2.kicad_sch, Charger slot 2: BQ25798 + PicoBlade (1S) / XT30 (2S) switch…, part in row 2, column 1]

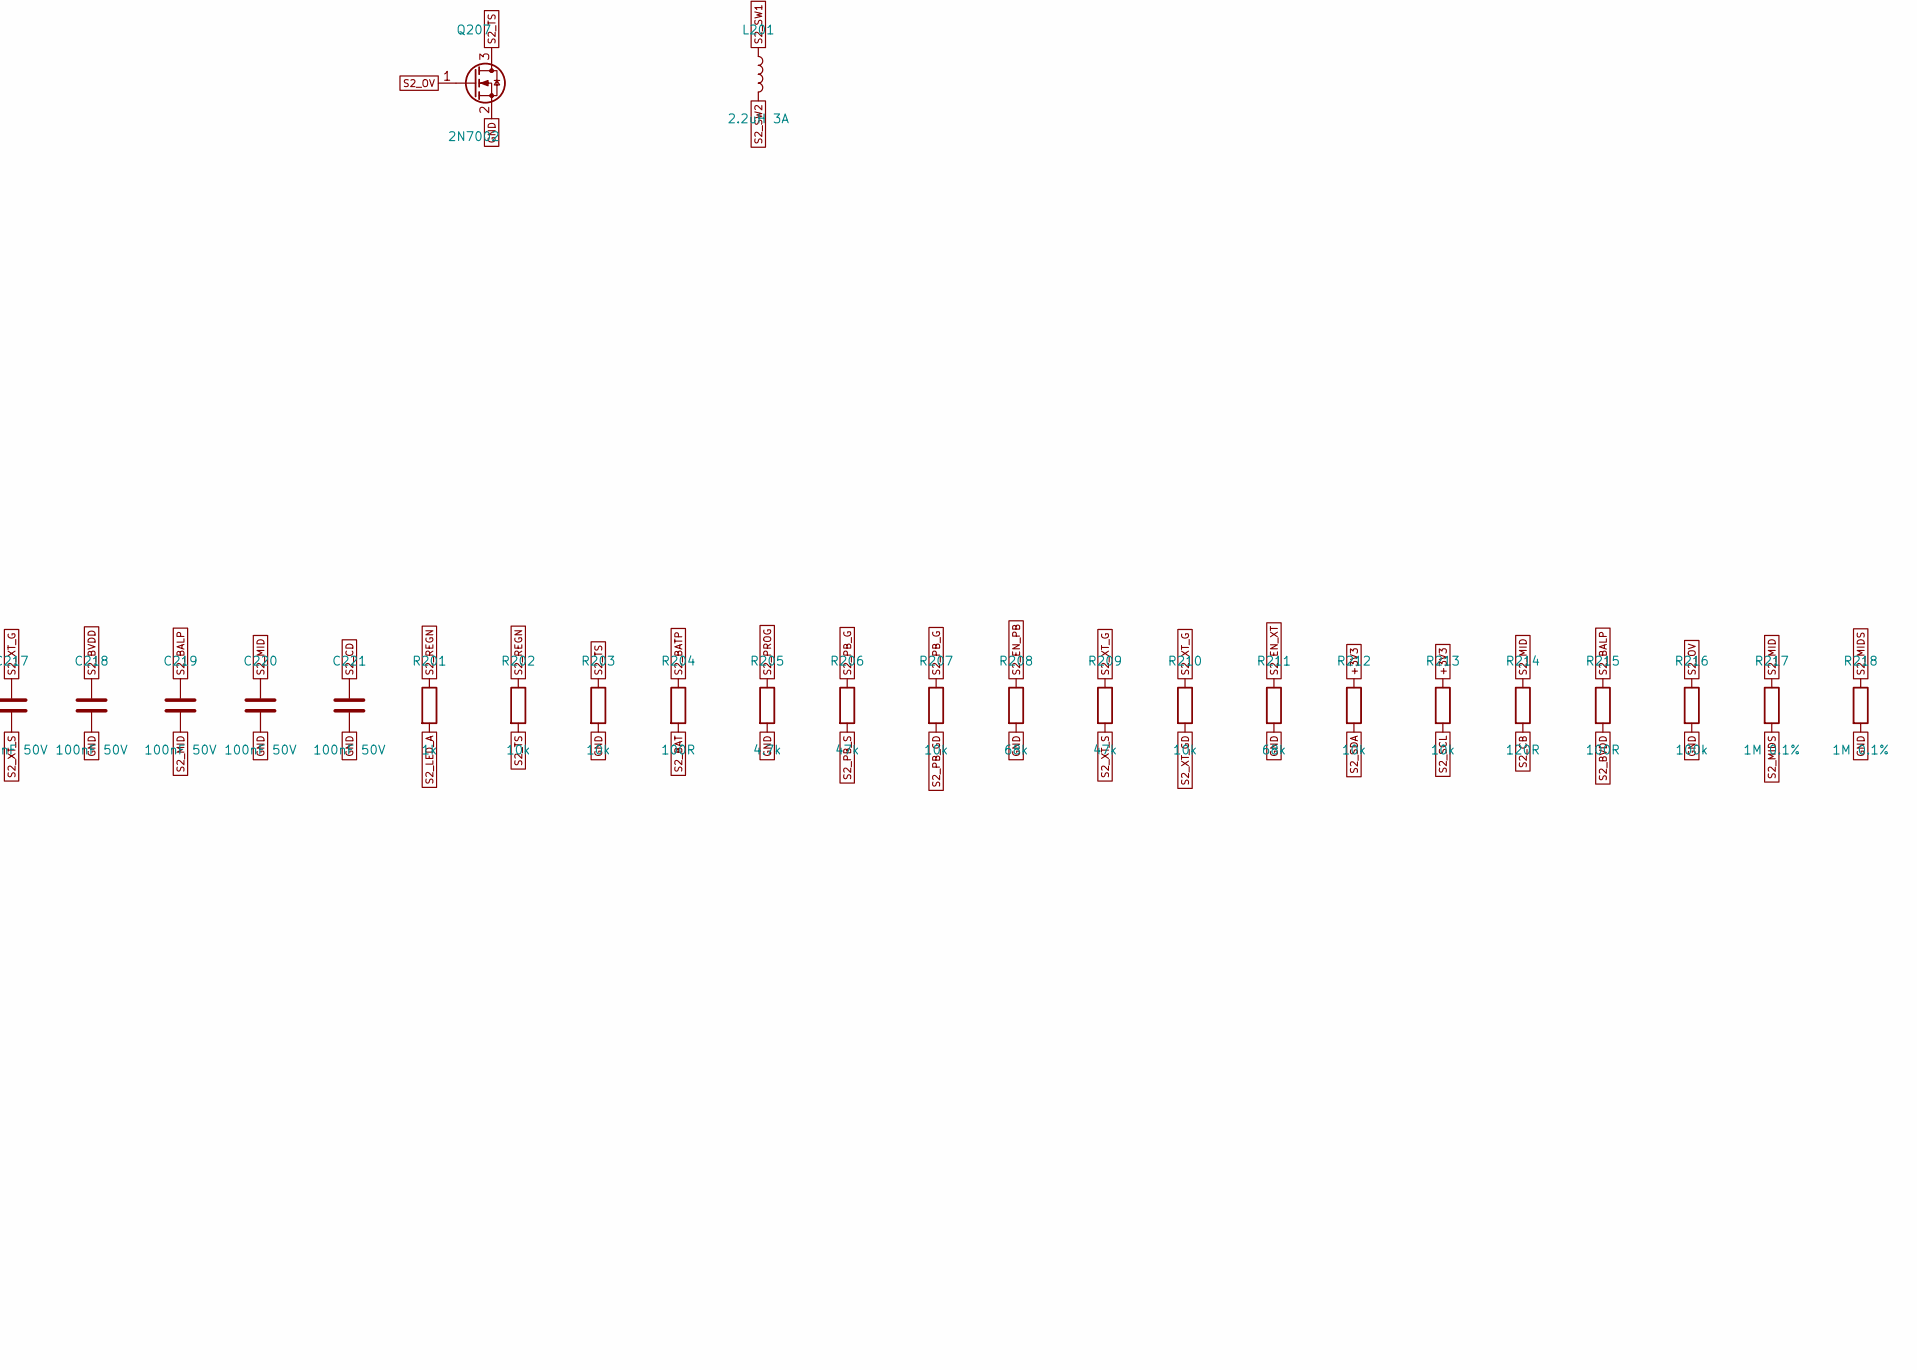
[picture p23: schematic slot2.kicad_sch, Charger slot 2: BQ25798 + PicoBlade (1S) / XT30 (2S) switch…, part in row 2, column 2]

Parts:
C201, C203: 47nF 50V; C_0402_1005Metric; MPN CL05B473KB5NNNC
C202: 4.7uF 16V; C_0603_1608Metric; MPN CL10A475KO8NNNC; LCSC C19666
C204: 1nF 50V; C_0402_1005Metric; MPN CL05B102KB5NNNC; LCSC C1523
C205, C207, C208, C214, C215: 10uF 25V; C_0805_2012Metric; MPN CL21A106KAYNNNE; LCSC C15850
C206, C209, C213, C216, C217, C218, C219, C220, C221: 100nF 50V; C_0402_1005Metric; MPN CL05B104KB54PNC; LCSC C307331
C210, C211: 22uF 25V; C_0805_2012Metric; MPN CL21A226MAQNNNE; LCSC C45783
D201: CHARGING (green); LED_0603_1608Metric; MPN 19-217/GHC-YR1S2/3T; LCSC C72043
J201: XT30 2S; AMASS_XT30UPB-M_1x02_P5.0mm_Vertical; MPN XT30UPB-M; LCSC C99101
J202: PicoBlade 1S; Molex_PicoBlade_53047-0210_1x02_P1.25mm_Vertical; MPN 0530470210
J203: XH balance 2S; JST_XH_B3B-XH-A_1x03_P2.50mm_Vertical; MPN B3B-XH-A; LCSC C144394
L201: 2.2uH 3A; L_Changjiang_FNR4030S; MPN FNR4030S2R2MT
Q201, Q202, Q203, Q204: AO3401A; SOT-23; MPN AO3401A; LCSC C15127
Q205, Q206, Q207: 2N7002; SOT-23; MPN 2N7002; LCSC C8545
R201: 1k; R_0402_1005Metric; MPN 0402WGF1001TCE; LCSC C11702
R202, R203, R207, R210, R212, R213: 10k; R_0402_1005Metric; MPN 0402WGF1002TCE; LCSC C25744
R204, R215: 100R; R_0402_1005Metric; MPN 0402WGF1000TCE; LCSC C25076
R205: 4.7k; R_0402_1005Metric; MPN 0402WGF4701TCE; LCSC C25900
R206, R209: 47k; R_0402_1005Metric; MPN 0402WGF4702TCE; LCSC C25792
R208, R211: 68k; R_0402_1005Metric; MPN 0402WGF6802TCE; LCSC C36871
R214: 120R; R_0402_1005Metric; MPN 0402WGF1200TCE
R216: 100k; R_0402_1005Metric; MPN 0402WGF1003TCE; LCSC C25741
R217, R218, R219, R220, R221: 1M 0.1%; R_0402_1005Metric; MPN RT0402BRD071ML
U201: BQ25798; Texas_RQM0029A_VQFN-29_4x4mm_P0.4mm; MPN BQ25798RQMR; LCSC C2876768
U202: BQ29209; VSON-8-1EP_3x3mm_P0.65mm_EP1.65x2.4mm; MPN BQ29209DRBR

Connections:
+3V3: R212.1, R213.1; also elsewhere on the board
CE_ALL_N: U201.13 (~CE); also elsewhere on the board
GND: C202.2, C204.2, C205.2, C206.2, C207.2, C208.2, C209.2, C210.2, C211.2, C213.2, C214.2, C215.2, C218.2, C220.2, C221.2, J201.1, J202.2, J203.1, Q205.2 (S), Q206.2 (S), Q207.2 (S), R203.2, R205.2, R208.2, R211.2, R216.2, R218.2, R221.2, U201.10 (ACDRV2), U201.11 (ACDRV1), U201.27 (GND), U202.5 (GND), U202.6 (CB_EN), U202.9 (EPAD); also elsewhere on the board
S2_BALA: R219.2, R220.1
S2_BALP: C219.1, J203.3, R215.1, R219.1, U202.1 (VC2)
S2_BALS: R220.2, R221.1; also elsewhere on the board
S2_BAT: C214.1, C215.1, Q202.3 (D), Q204.3 (D), R204.2, U201.22 (BAT), U201.23 (BAT)
S2_BATP: R204.1, U201.18 (BATP)
S2_BTST1: C201.1, U201.4 (BTST1)
S2_BTST2: C203.1, U201.19 (BTST2)
S2_BVDD: C218.1, R215.2, U202.7 (VDD)
S2_CB: R214.2, U202.3 (VC1_CB)
S2_CD: C221.1, U202.4 (CD)
S2_EN_PB: Q205.1 (G), R208.1, U201.6 (D+)
S2_EN_XT: Q206.1 (G), R211.1, U201.7 (D-)
S2_LED_A: D201.2 (A), R201.2
S2_MID: C219.2, C220.1, J203.2, R214.1, R217.1, U202.2 (VC1)
S2_MIDS: R217.2, R218.1; also elsewhere on the board
S2_OV: Q207.1 (G), R216.1, U202.8 (OUT)
S2_PB_G: C216.1, Q201.1 (G), Q202.1 (G), R206.1, R207.1
S2_PB_GD: Q205.3 (D), R207.2
S2_PB_P: J202.1, Q201.3 (D)
S2_PB_S: C216.2, Q201.2 (S), Q202.2 (S), R206.2
S2_PMID: C207.1, C208.1, C209.1, U201.29 (PMID)
S2_PROG: R205.1, U201.20 (PROG)
S2_REGN: C202.1, R201.1, R202.1, U201.5 (REGN), U201.17 (ILIM_HIZ)
S2_SCL: R213.2, U201.14 (SCL); also elsewhere on the board
S2_SDA: R212.2, U201.15 (SDA); also elsewhere on the board
S2_SDRV: C204.1, U201.24 (SDRV)
S2_STAT: D201.1 (K), U201.1 (STAT)
S2_SW1: C201.2, L201.1, U201.28 (SW1)
S2_SW2: C203.2, L201.2, U201.26 (SW2)
S2_SYS: C210.1, C211.1, C213.1, U201.25 (SYS)
S2_TS: Q207.3 (D), R202.2, R203.1, U201.16 (TS)
S2_XT_G: C217.1, Q203.1 (G), Q204.1 (G), R209.1, R210.1
S2_XT_GD: Q206.3 (D), R210.2
S2_XT_P: J201.2, Q203.3 (D)
S2_XT_S: C217.2, Q203.2 (S), Q204.2 (S), R209.2
VBUS_PD: C205.1, C206.1, U201.2 (VBUS), U201.3 (VBUS), U201.8 (VAC2), U201.9 (VAC1); also elsewhere on the board

Notes on the sheet:
BQ25798 buck-boost charger. D+ drives the PicoBlade switch, D- the XT30 switch (register 0x47). Each connector has a back-to-back P-FET pair so the two packs can never be connected together.
