Mirokuki/Battery-Charger/hardware/lipo-charger.kicad_pcb

## KiCad design hardware/lipo-charger.kicad_pcb (continued)

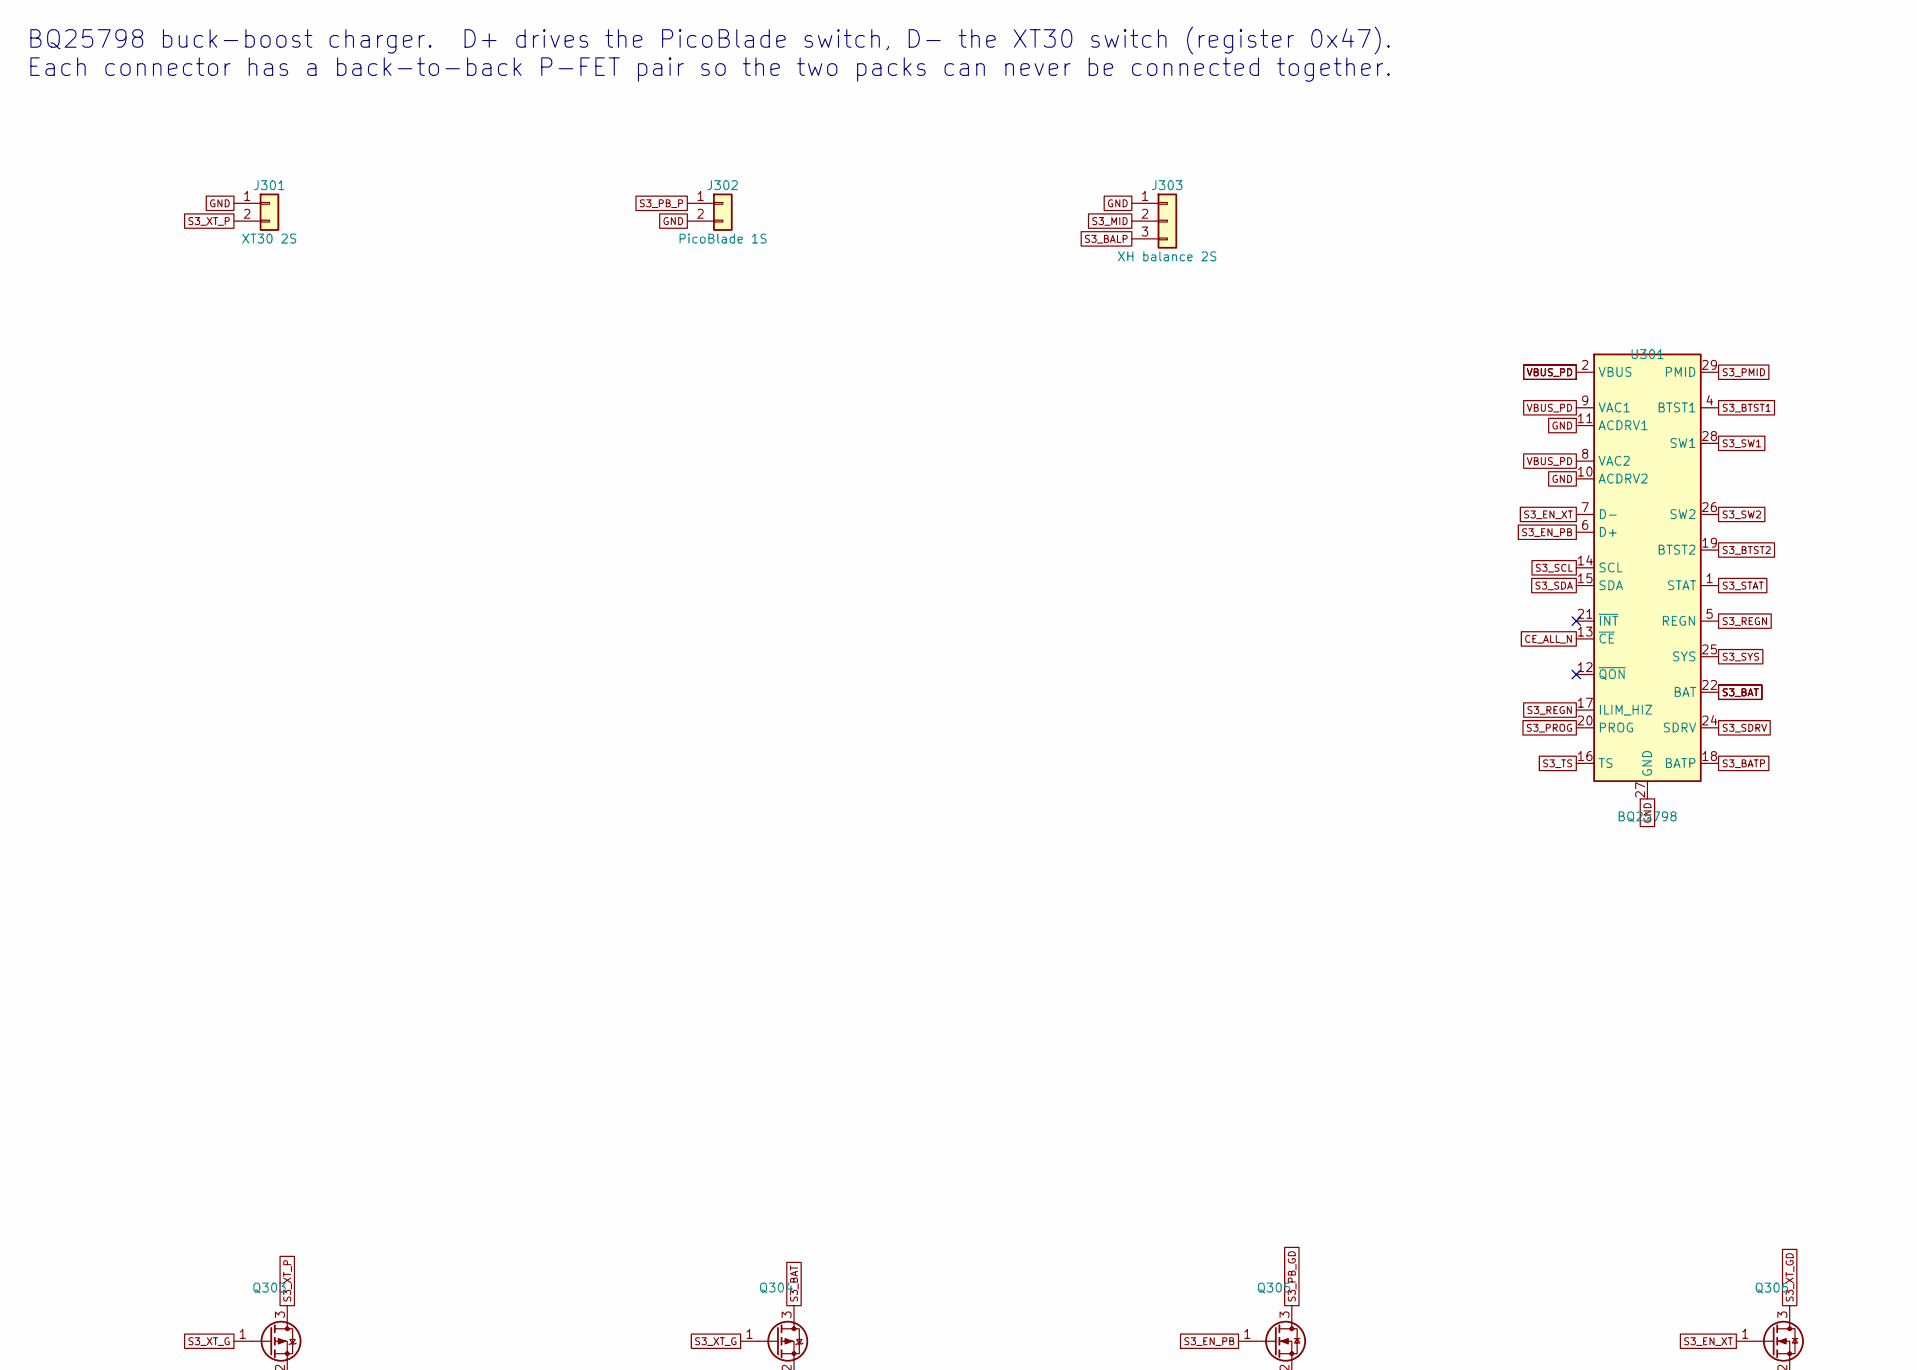
[picture p24: schematic slot3.kicad_sch, Charger slot 3: BQ25798 + PicoBlade (1S) / XT30 (2S) switch…, part in row 1, column 1]

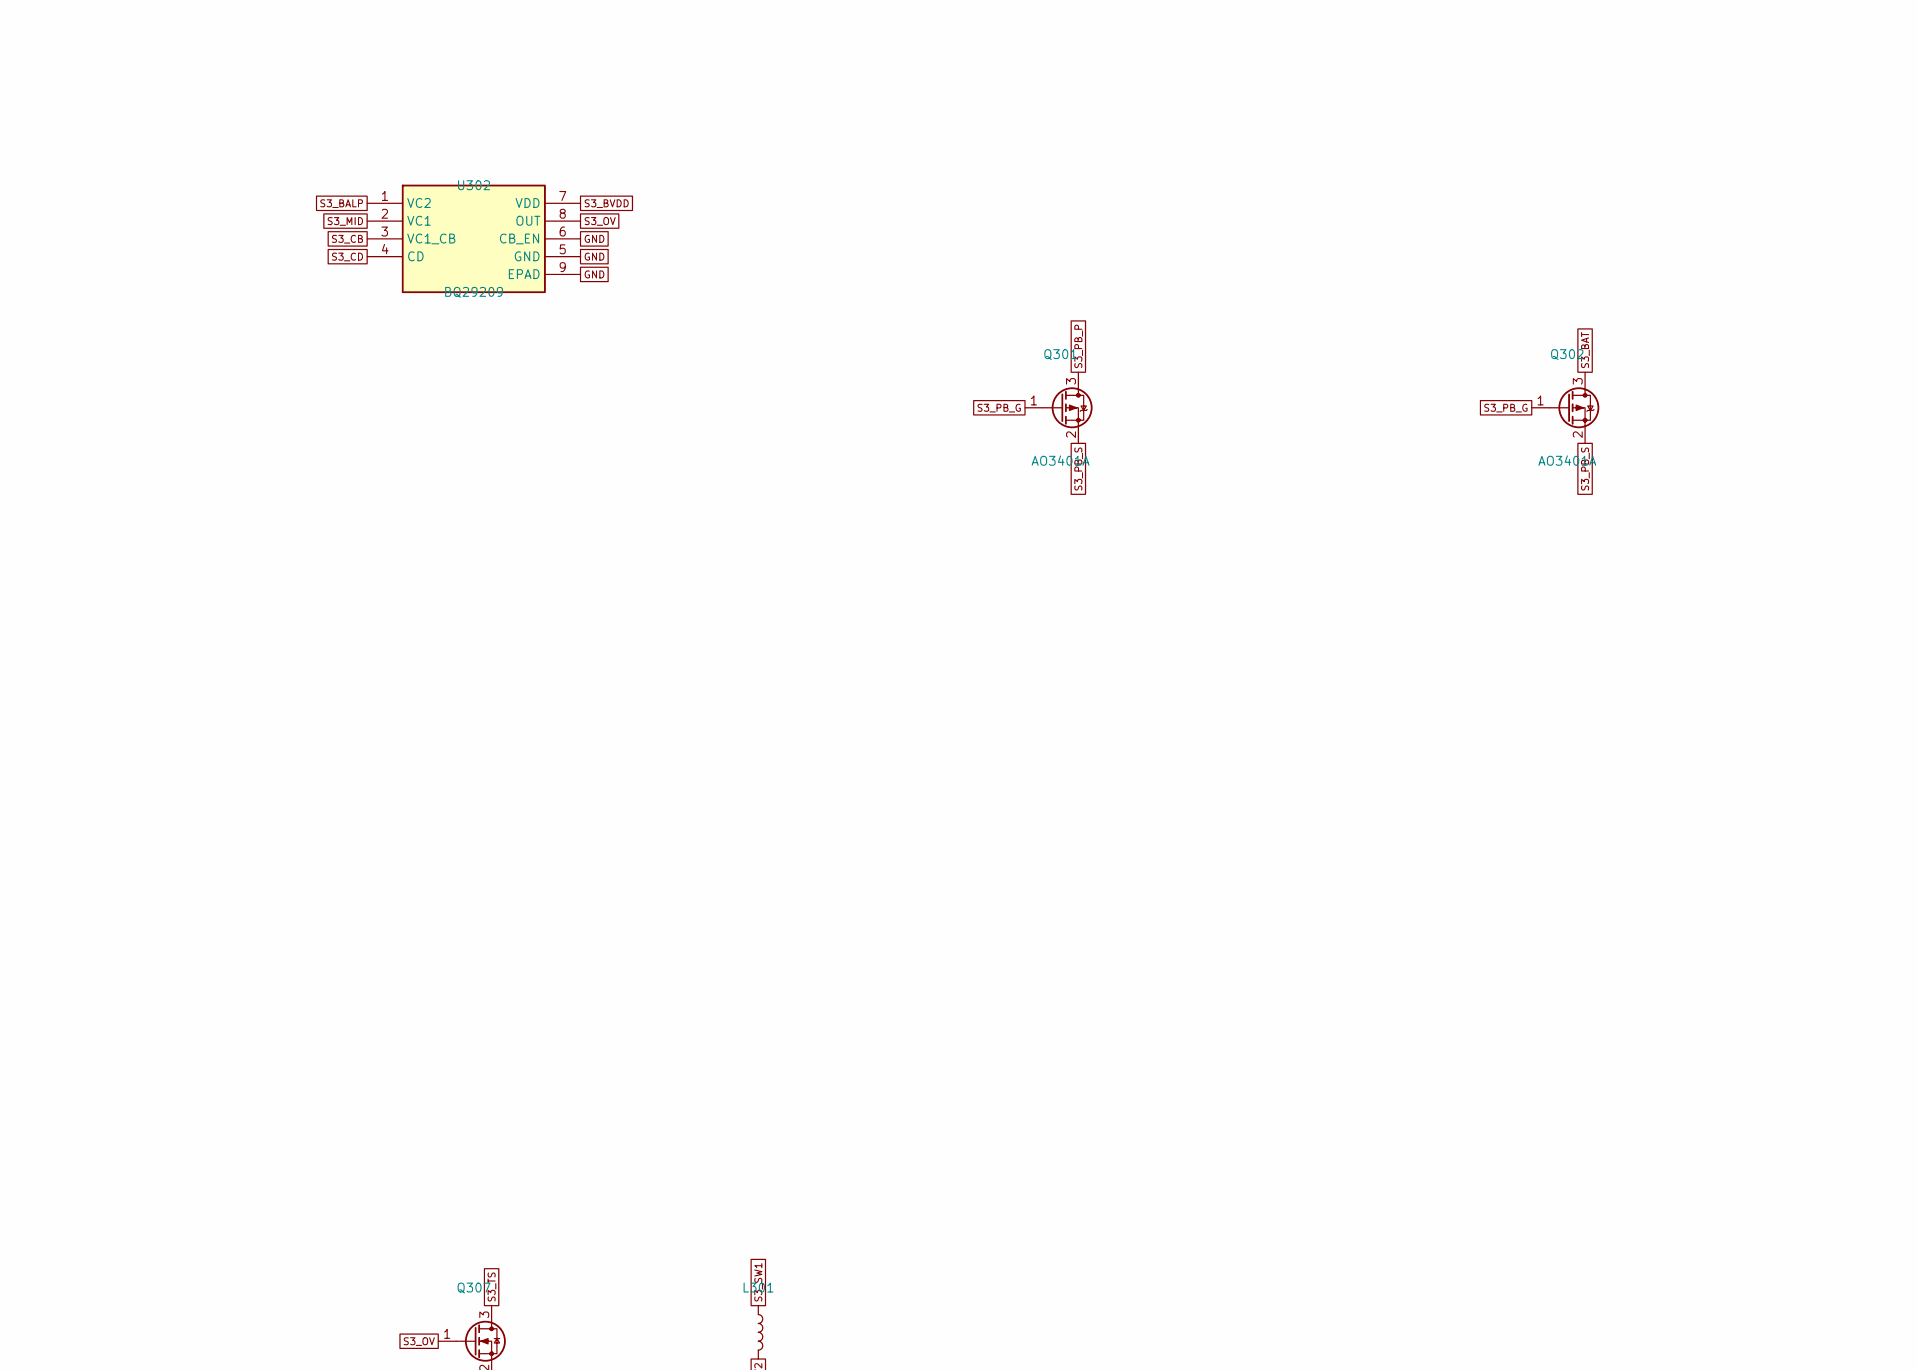
[picture p25: schematic slot3.kicad_sch, Charger slot 3: BQ25798 + PicoBlade (1S) / XT30 (2S) switch…, part in row 1, column 2]

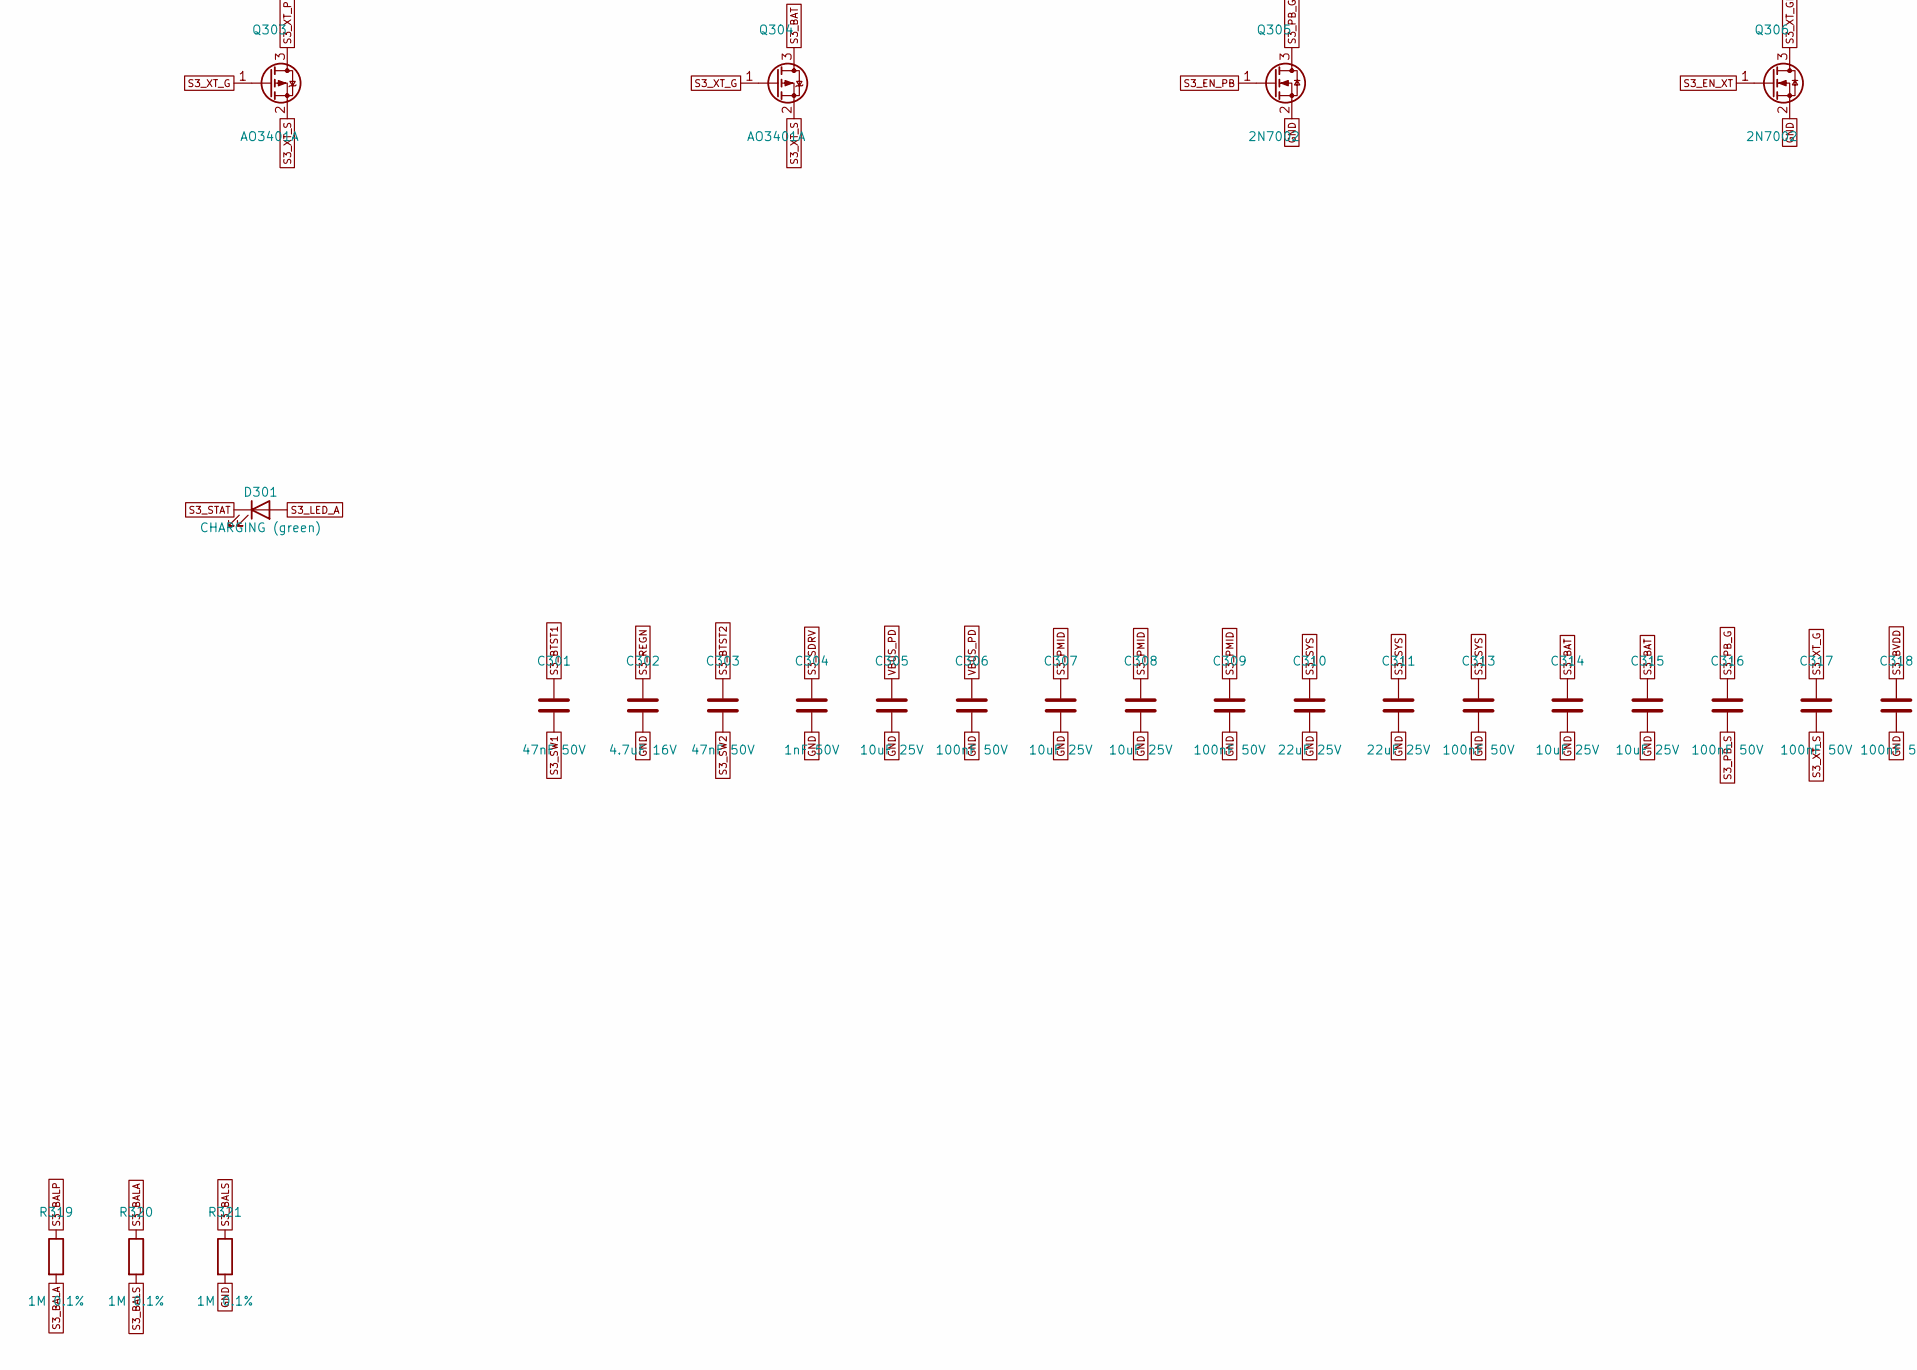
[picture p26: schematic slot3.kicad_sch, Charger slot 3: BQ25798 + PicoBlade (1S) / XT30 (2S) switch…, part in row 2, column 1]

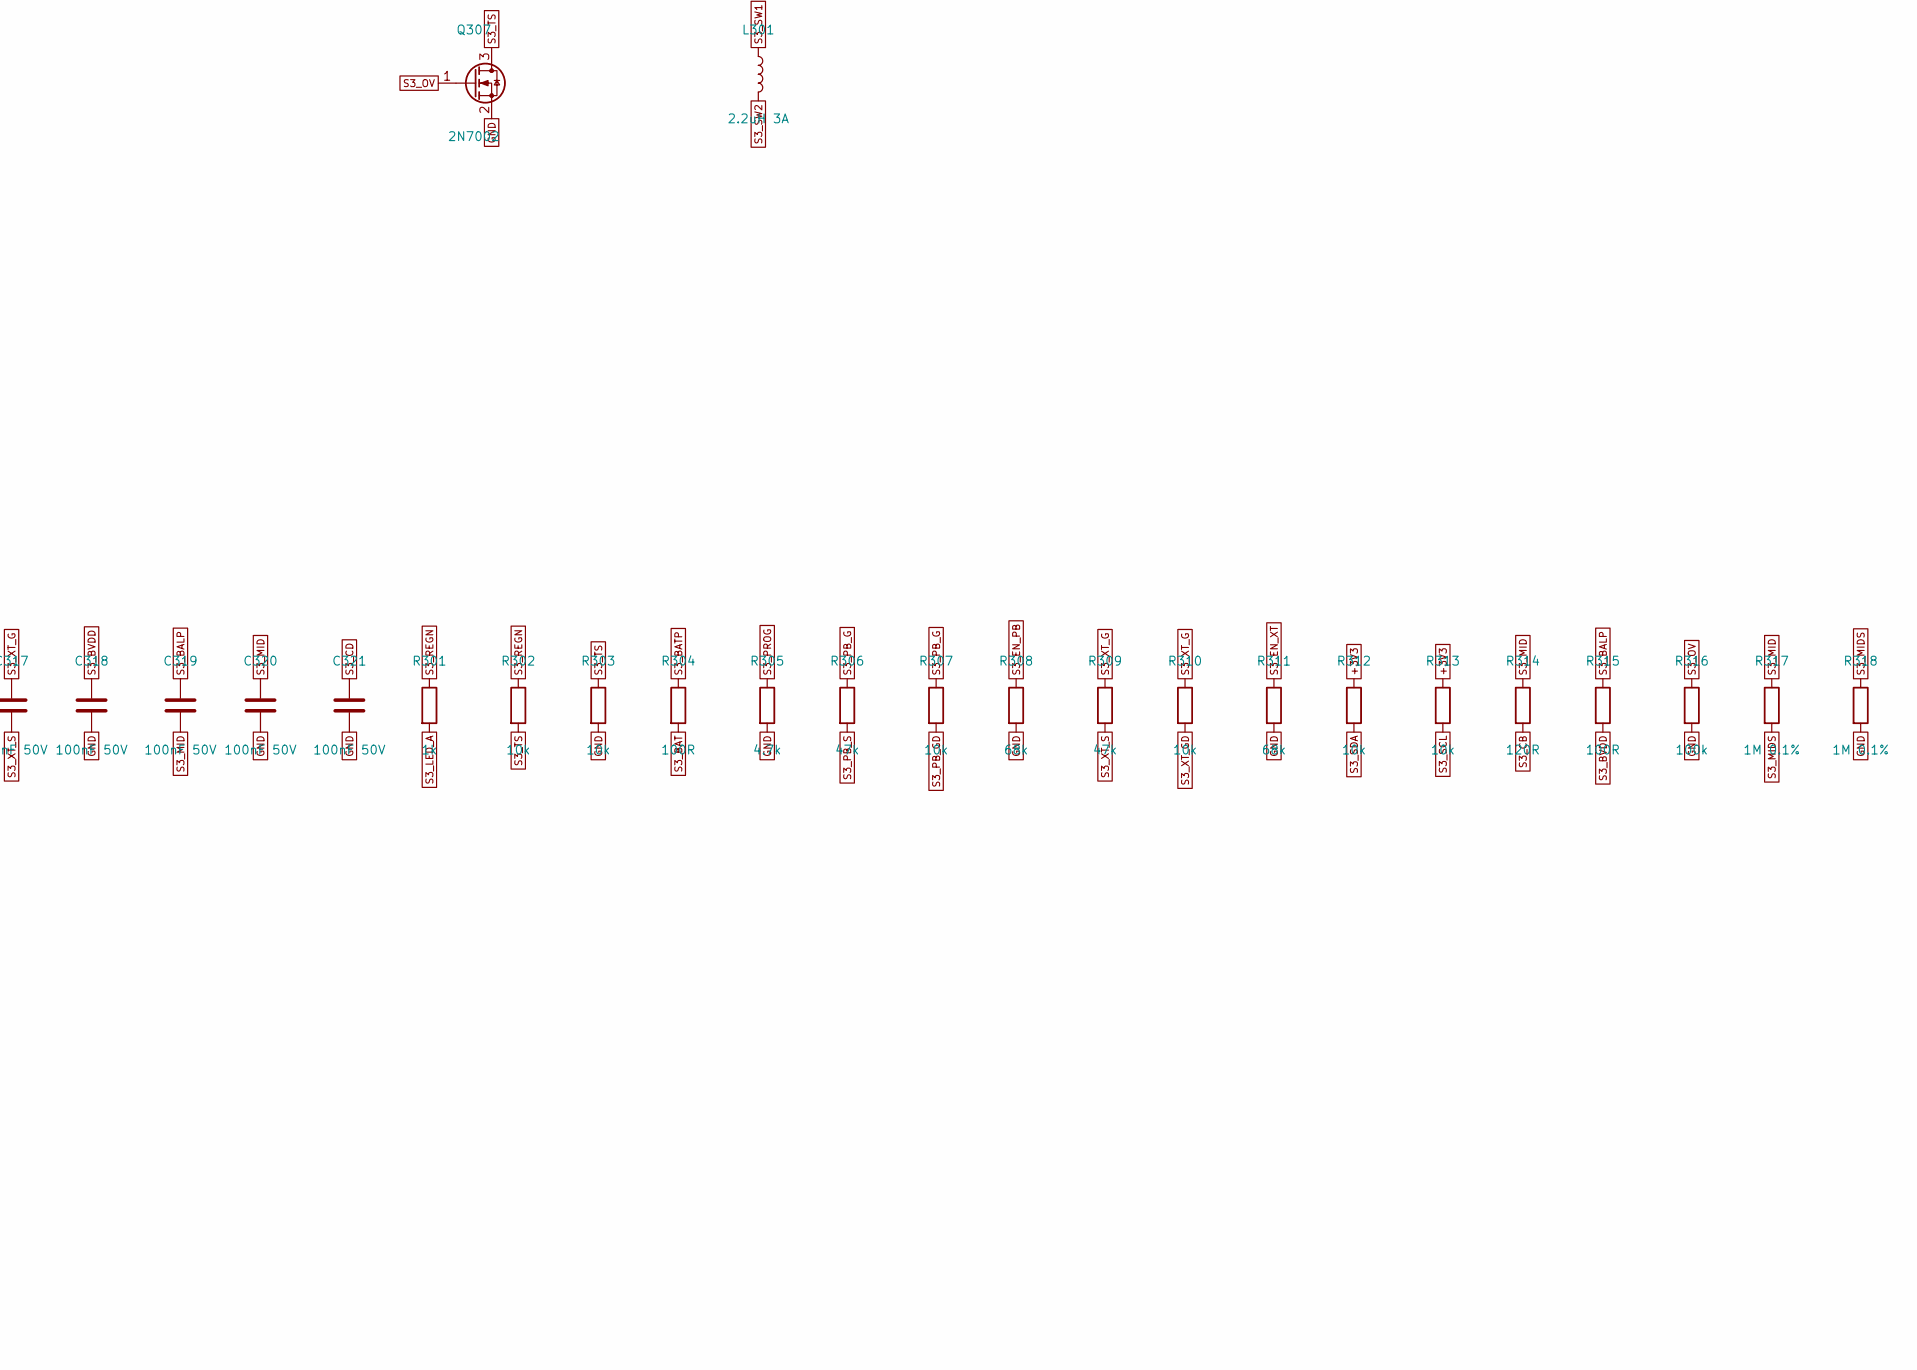
[picture p27: schematic slot3.kicad_sch, Charger slot 3: BQ25798 + PicoBlade (1S) / XT30 (2S) switch…, part in row 2, column 2]

Parts:
C301, C303: 47nF 50V; C_0402_1005Metric; MPN CL05B473KB5NNNC
C302: 4.7uF 16V; C_0603_1608Metric; MPN CL10A475KO8NNNC; LCSC C19666
C304: 1nF 50V; C_0402_1005Metric; MPN CL05B102KB5NNNC; LCSC C1523
C305, C307, C308, C314, C315: 10uF 25V; C_0805_2012Metric; MPN CL21A106KAYNNNE; LCSC C15850
C306, C309, C313, C316, C317, C318, C319, C320, C321: 100nF 50V; C_0402_1005Metric; MPN CL05B104KB54PNC; LCSC C307331
C310, C311: 22uF 25V; C_0805_2012Metric; MPN CL21A226MAQNNNE; LCSC C45783
D301: CHARGING (green); LED_0603_1608Metric; MPN 19-217/GHC-YR1S2/3T; LCSC C72043
J301: XT30 2S; AMASS_XT30UPB-M_1x02_P5.0mm_Vertical; MPN XT30UPB-M; LCSC C99101
J302: PicoBlade 1S; Molex_PicoBlade_53047-0210_1x02_P1.25mm_Vertical; MPN 0530470210
J303: XH balance 2S; JST_XH_B3B-XH-A_1x03_P2.50mm_Vertical; MPN B3B-XH-A; LCSC C144394
L301: 2.2uH 3A; L_Changjiang_FNR4030S; MPN FNR4030S2R2MT
Q301, Q302, Q303, Q304: AO3401A; SOT-23; MPN AO3401A; LCSC C15127
Q305, Q306, Q307: 2N7002; SOT-23; MPN 2N7002; LCSC C8545
R301: 1k; R_0402_1005Metric; MPN 0402WGF1001TCE; LCSC C11702
R302, R303, R307, R310, R312, R313: 10k; R_0402_1005Metric; MPN 0402WGF1002TCE; LCSC C25744
R304, R315: 100R; R_0402_1005Metric; MPN 0402WGF1000TCE; LCSC C25076
R305: 4.7k; R_0402_1005Metric; MPN 0402WGF4701TCE; LCSC C25900
R306, R309: 47k; R_0402_1005Metric; MPN 0402WGF4702TCE; LCSC C25792
R308, R311: 68k; R_0402_1005Metric; MPN 0402WGF6802TCE; LCSC C36871
R314: 120R; R_0402_1005Metric; MPN 0402WGF1200TCE
R316: 100k; R_0402_1005Metric; MPN 0402WGF1003TCE; LCSC C25741
R317, R318, R319, R320, R321: 1M 0.1%; R_0402_1005Metric; MPN RT0402BRD071ML
U301: BQ25798; Texas_RQM0029A_VQFN-29_4x4mm_P0.4mm; MPN BQ25798RQMR; LCSC C2876768
U302: BQ29209; VSON-8-1EP_3x3mm_P0.65mm_EP1.65x2.4mm; MPN BQ29209DRBR

Connections:
+3V3: R312.1, R313.1; also elsewhere on the board
CE_ALL_N: U301.13 (~CE); also elsewhere on the board
GND: C302.2, C304.2, C305.2, C306.2, C307.2, C308.2, C309.2, C310.2, C311.2, C313.2, C314.2, C315.2, C318.2, C320.2, C321.2, J301.1, J302.2, J303.1, Q305.2 (S), Q306.2 (S), Q307.2 (S), R303.2, R305.2, R308.2, R311.2, R316.2, R318.2, R321.2, U301.10 (ACDRV2), U301.11 (ACDRV1), U301.27 (GND), U302.5 (GND), U302.6 (CB_EN), U302.9 (EPAD); also elsewhere on the board
S3_BALA: R319.2, R320.1
S3_BALP: C319.1, J303.3, R315.1, R319.1, U302.1 (VC2)
S3_BALS: R320.2, R321.1; also elsewhere on the board
S3_BAT: C314.1, C315.1, Q302.3 (D), Q304.3 (D), R304.2, U301.22 (BAT), U301.23 (BAT)
S3_BATP: R304.1, U301.18 (BATP)
S3_BTST1: C301.1, U301.4 (BTST1)
S3_BTST2: C303.1, U301.19 (BTST2)
S3_BVDD: C318.1, R315.2, U302.7 (VDD)
S3_CB: R314.2, U302.3 (VC1_CB)
S3_CD: C321.1, U302.4 (CD)
S3_EN_PB: Q305.1 (G), R308.1, U301.6 (D+)
S3_EN_XT: Q306.1 (G), R311.1, U301.7 (D-)
S3_LED_A: D301.2 (A), R301.2
S3_MID: C319.2, C320.1, J303.2, R314.1, R317.1, U302.2 (VC1)
S3_MIDS: R317.2, R318.1; also elsewhere on the board
S3_OV: Q307.1 (G), R316.1, U302.8 (OUT)
S3_PB_G: C316.1, Q301.1 (G), Q302.1 (G), R306.1, R307.1
S3_PB_GD: Q305.3 (D), R307.2
S3_PB_P: J302.1, Q301.3 (D)
S3_PB_S: C316.2, Q301.2 (S), Q302.2 (S), R306.2
S3_PMID: C307.1, C308.1, C309.1, U301.29 (PMID)
S3_PROG: R305.1, U301.20 (PROG)
S3_REGN: C302.1, R301.1, R302.1, U301.5 (REGN), U301.17 (ILIM_HIZ)
S3_SCL: R313.2, U301.14 (SCL); also elsewhere on the board
S3_SDA: R312.2, U301.15 (SDA); also elsewhere on the board
S3_SDRV: C304.1, U301.24 (SDRV)
S3_STAT: D301.1 (K), U301.1 (STAT)
S3_SW1: C301.2, L301.1, U301.28 (SW1)
S3_SW2: C303.2, L301.2, U301.26 (SW2)
S3_SYS: C310.1, C311.1, C313.1, U301.25 (SYS)
S3_TS: Q307.3 (D), R302.2, R303.1, U301.16 (TS)
S3_XT_G: C317.1, Q303.1 (G), Q304.1 (G), R309.1, R310.1
S3_XT_GD: Q306.3 (D), R310.2
S3_XT_P: J301.2, Q303.3 (D)
S3_XT_S: C317.2, Q303.2 (S), Q304.2 (S), R309.2
VBUS_PD: C305.1, C306.1, U301.2 (VBUS), U301.3 (VBUS), U301.8 (VAC2), U301.9 (VAC1); also elsewhere on the board

Notes on the sheet:
BQ25798 buck-boost charger. D+ drives the PicoBlade switch, D- the XT30 switch (register 0x47). Each connector has a back-to-back P-FET pair so the two packs can never be connected together.
