Mirokuki/Battery-Charger/hardware/lipo-charger.kicad_pcb

## KiCad design hardware/lipo-charger.kicad_pcb (continued)

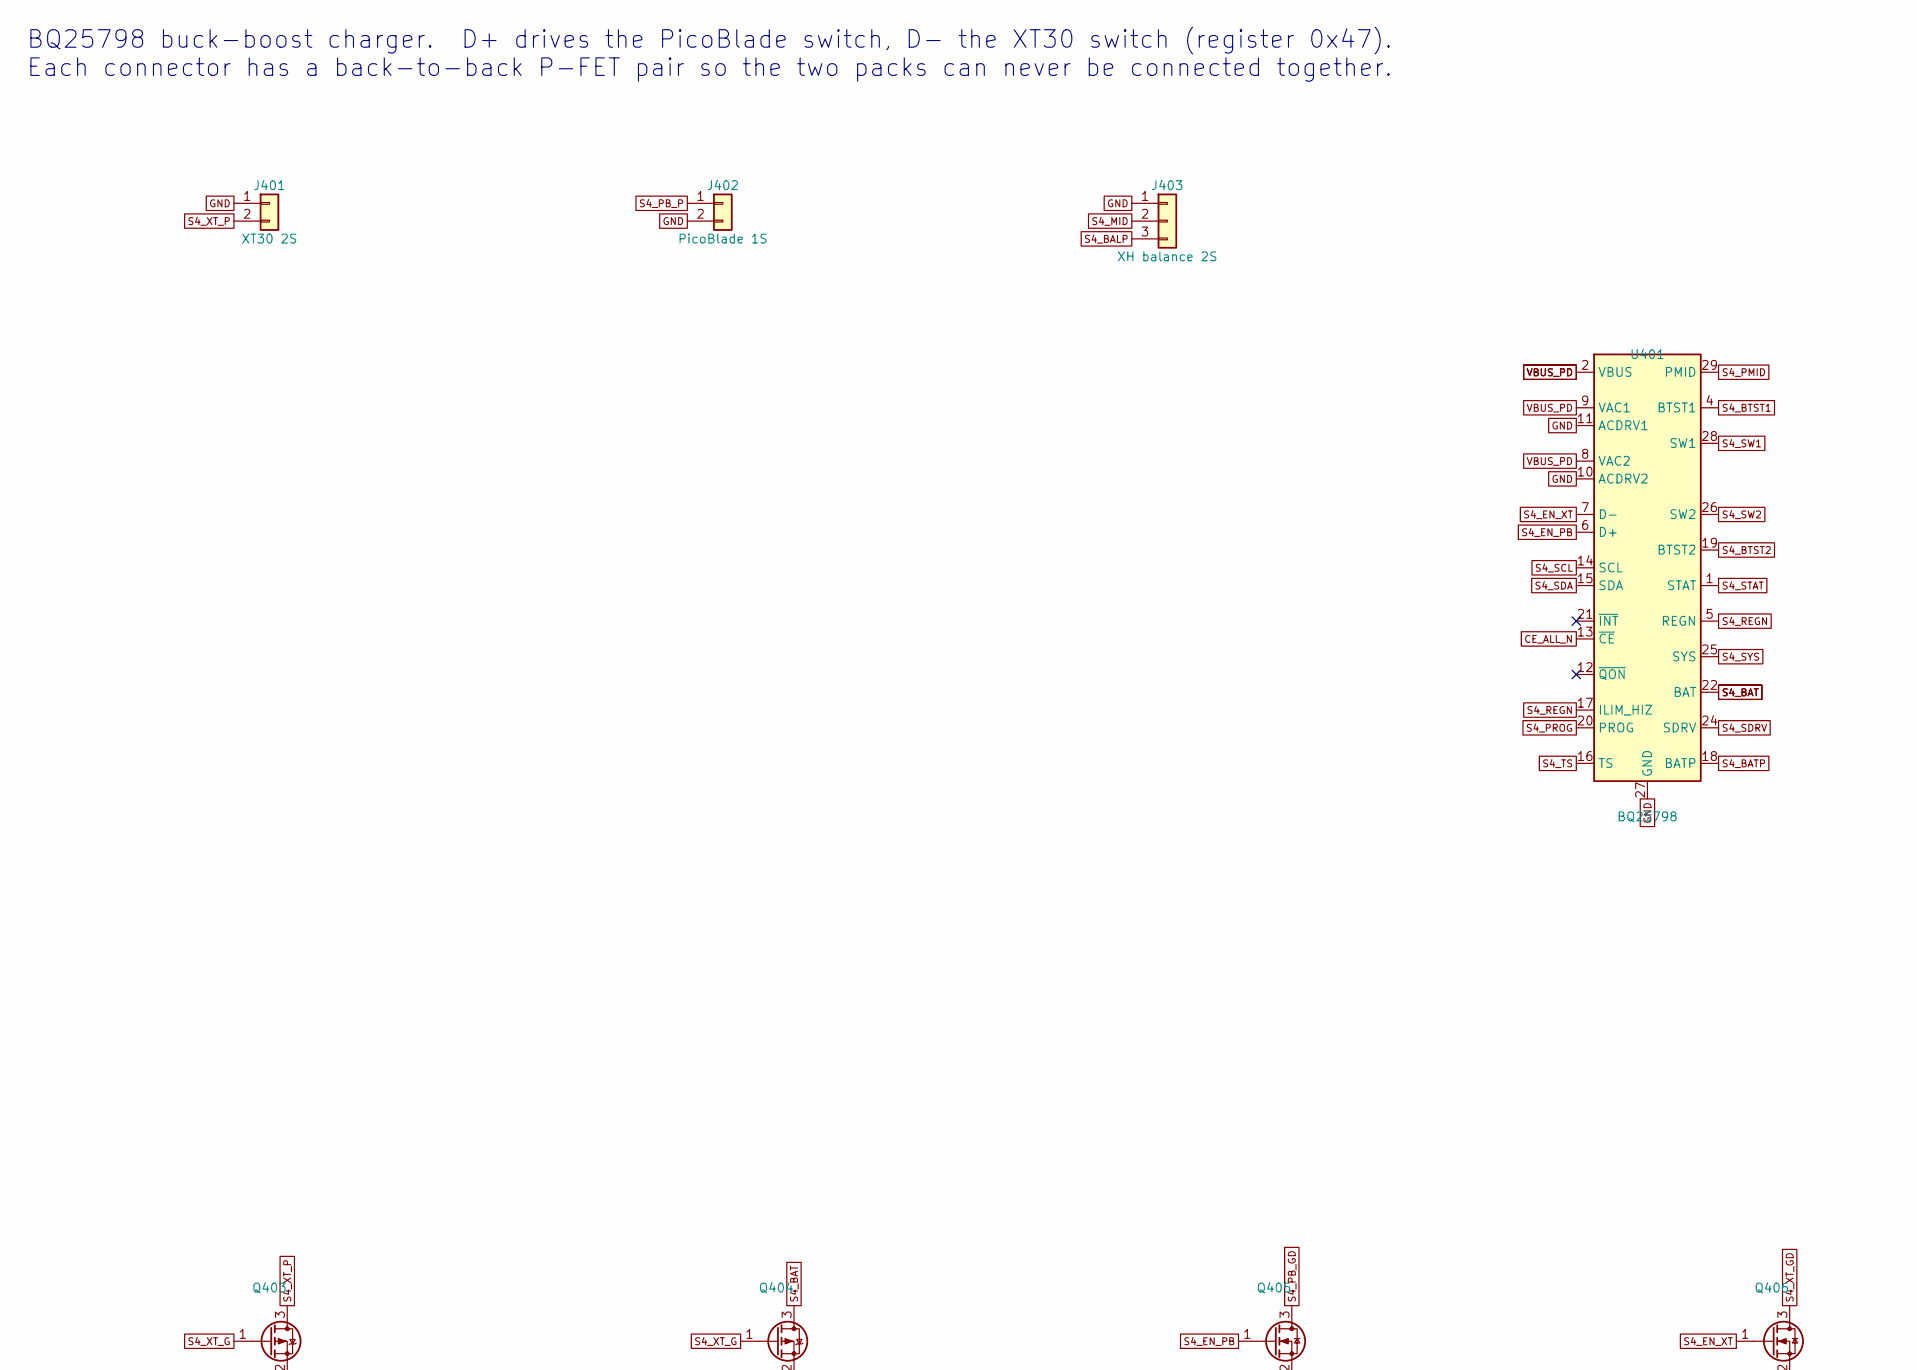
[picture p28: schematic slot4.kicad_sch, Charger slot 4: BQ25798 + PicoBlade (1S) / XT30 (2S) switch…, part in row 1, column 1]

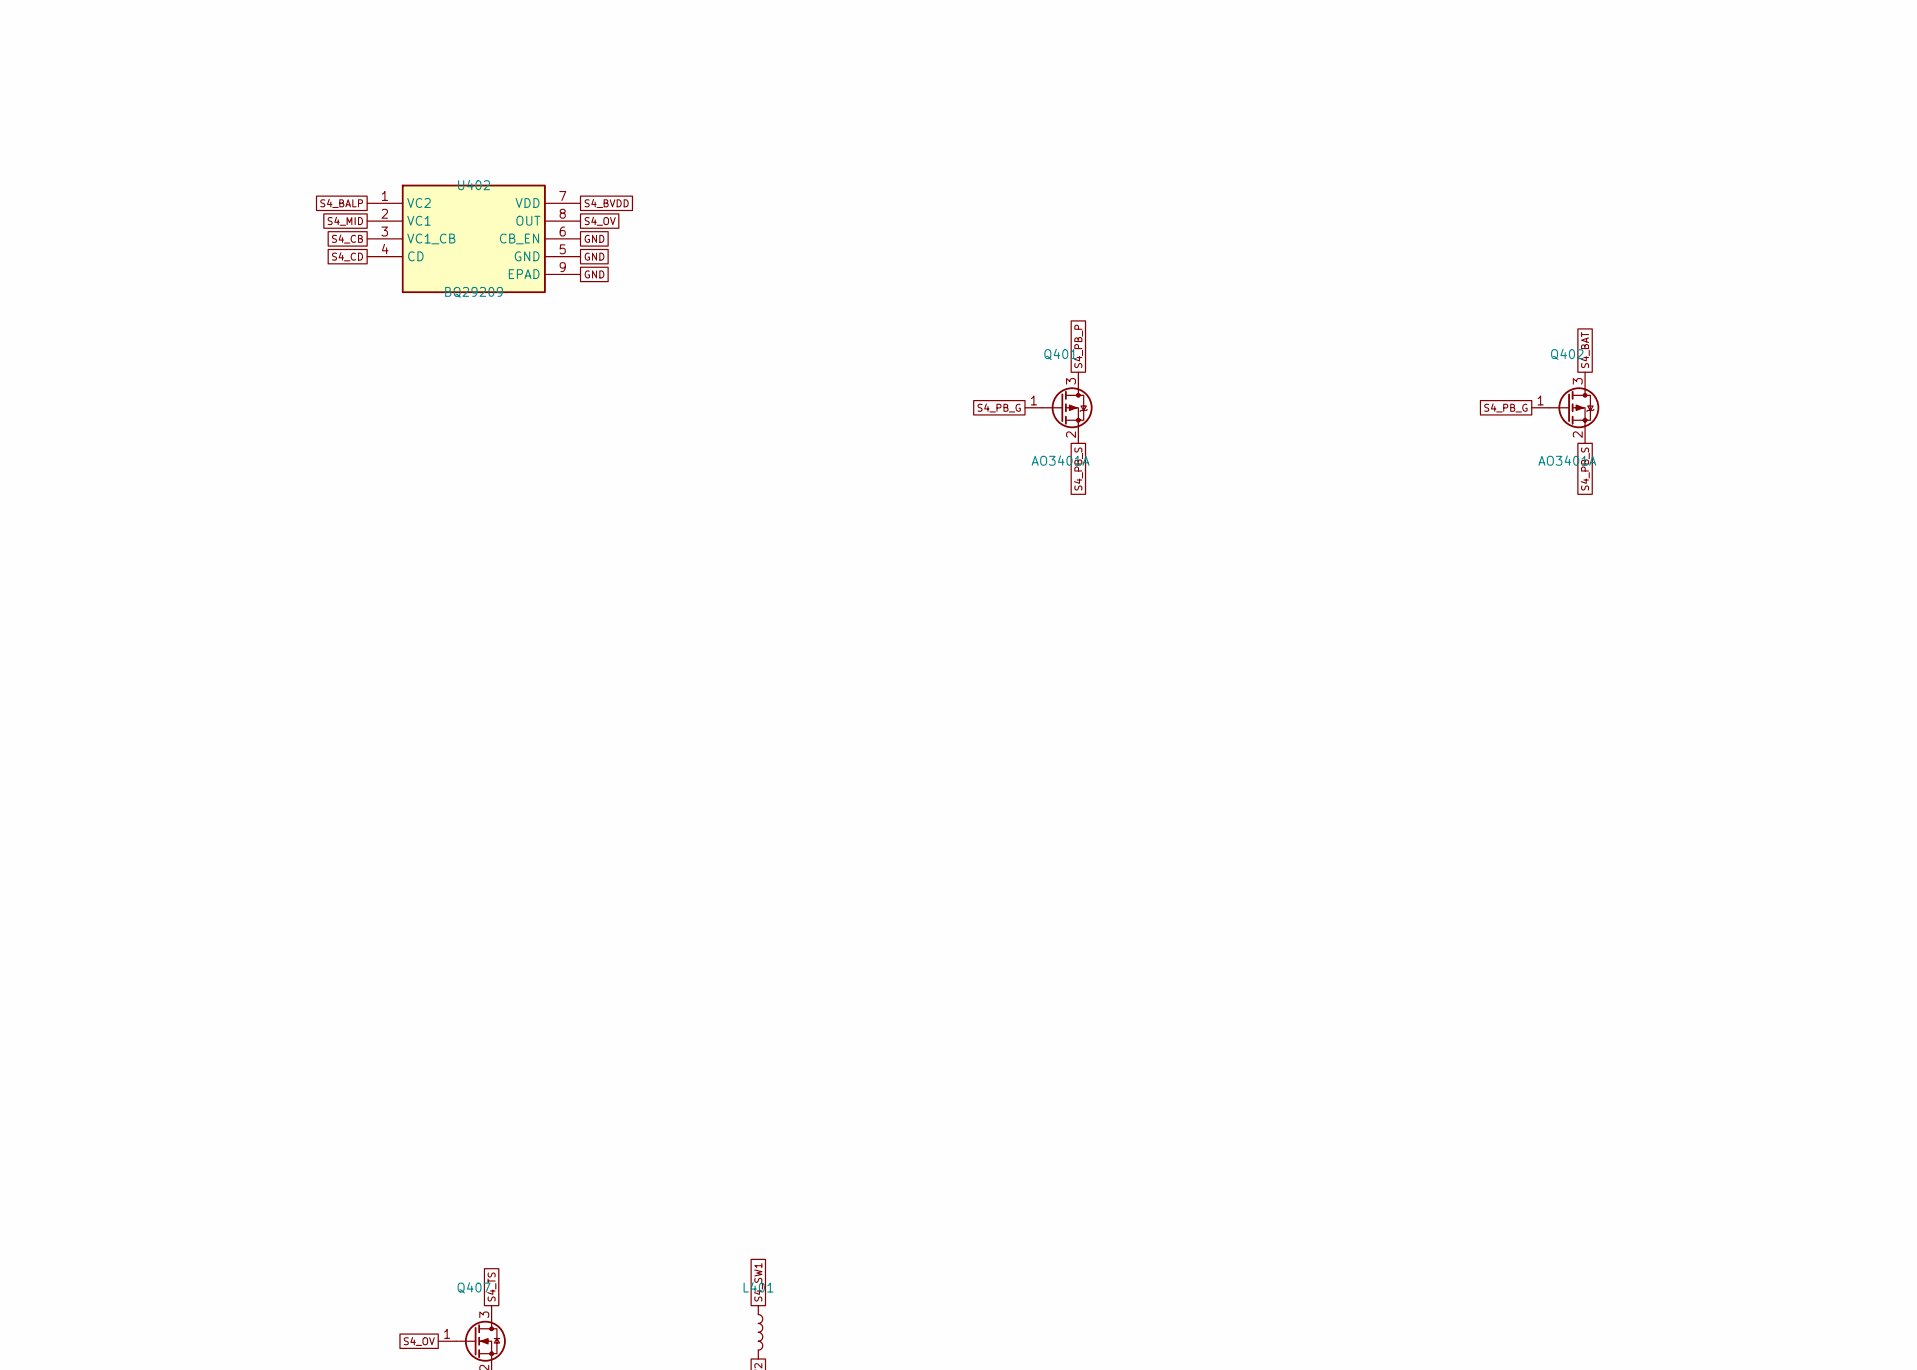
[picture p29: schematic slot4.kicad_sch, Charger slot 4: BQ25798 + PicoBlade (1S) / XT30 (2S) switch…, part in row 1, column 2]

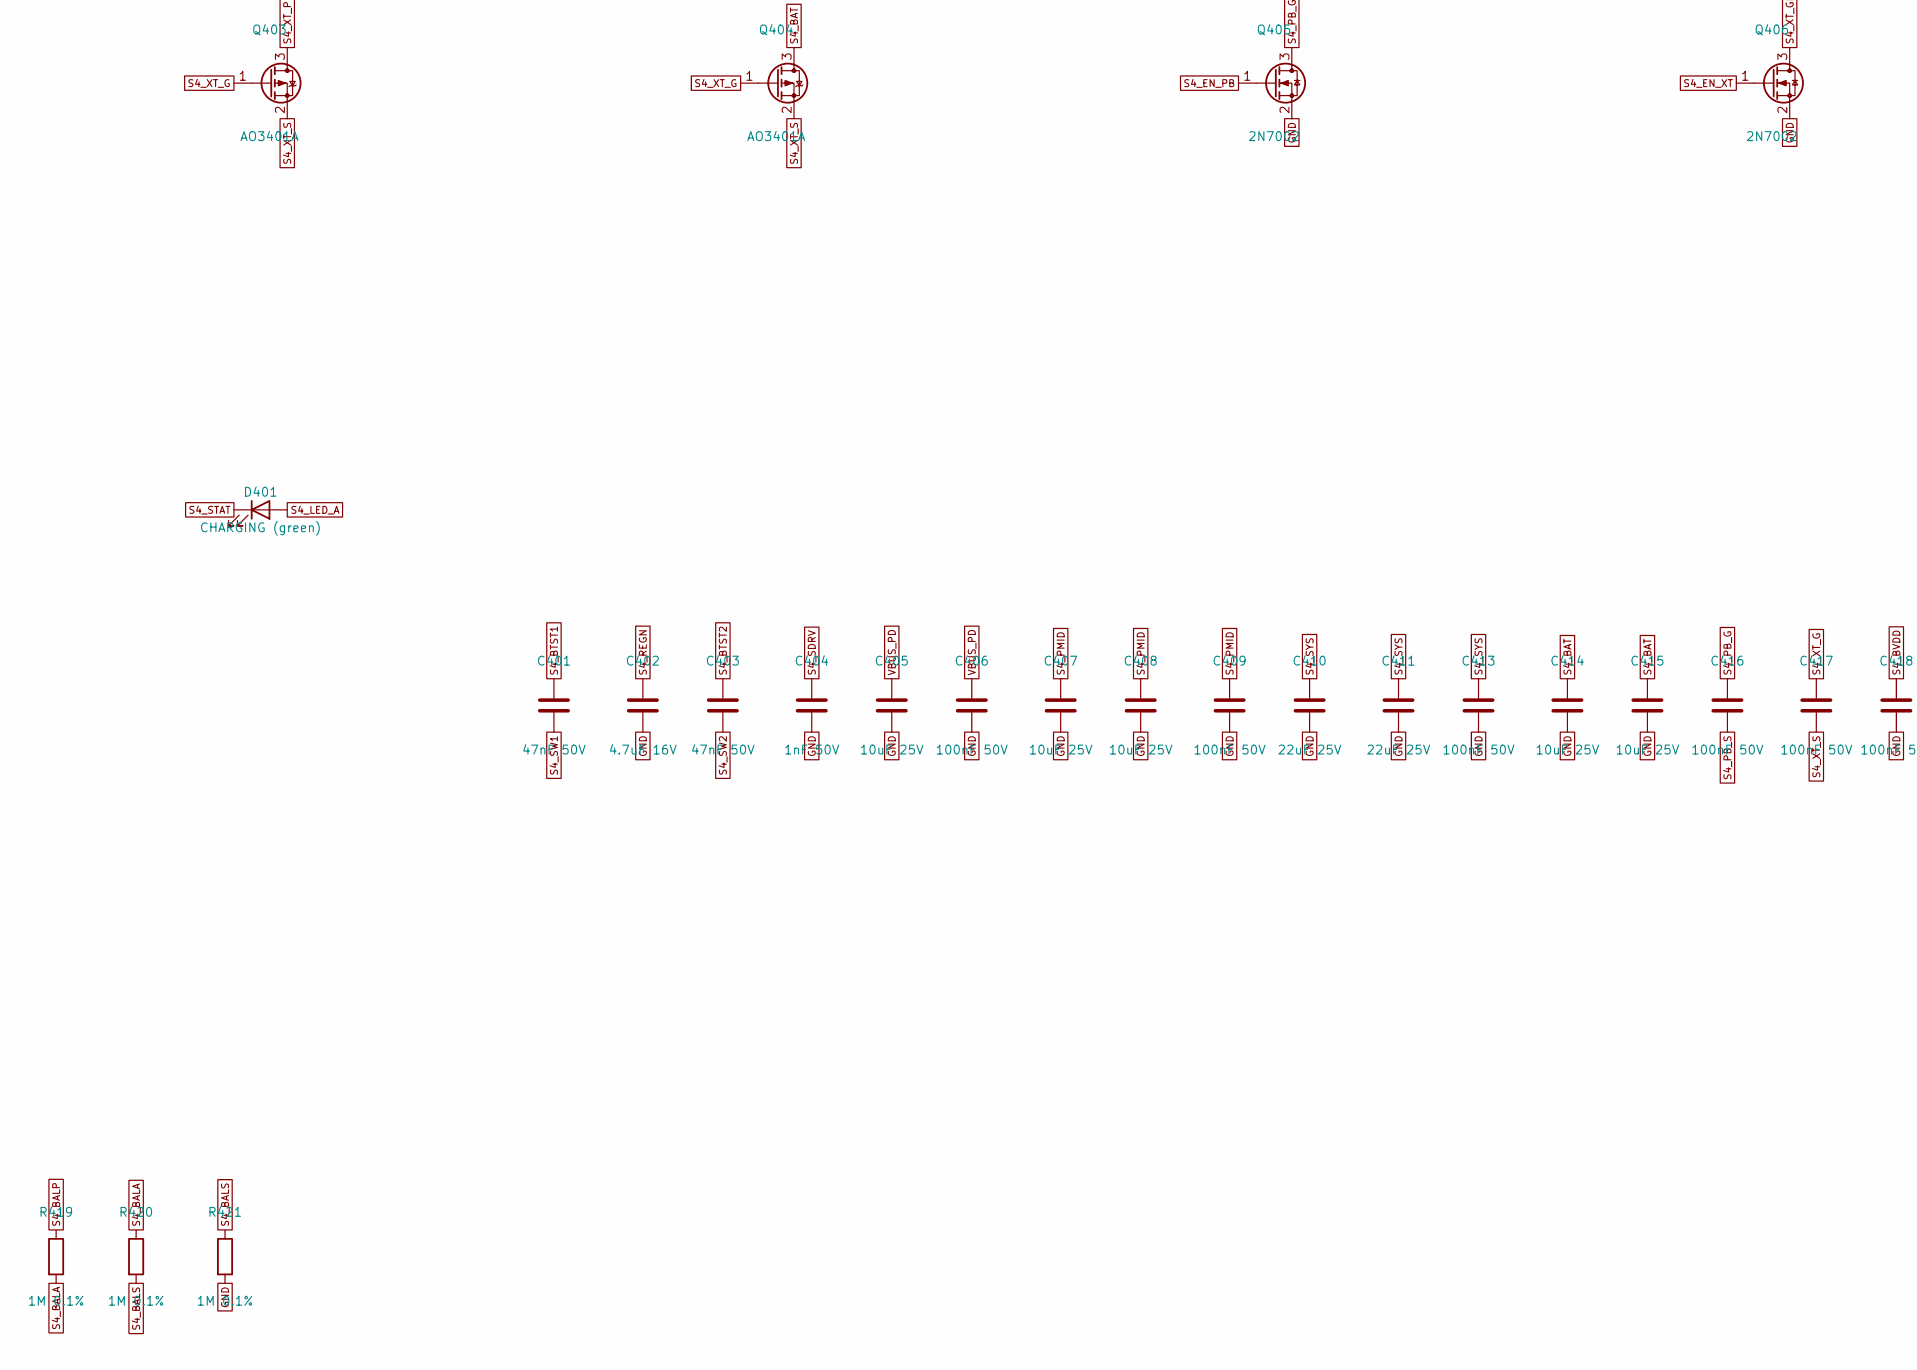
[picture p30: schematic slot4.kicad_sch, Charger slot 4: BQ25798 + PicoBlade (1S) / XT30 (2S) switch…, part in row 2, column 1]

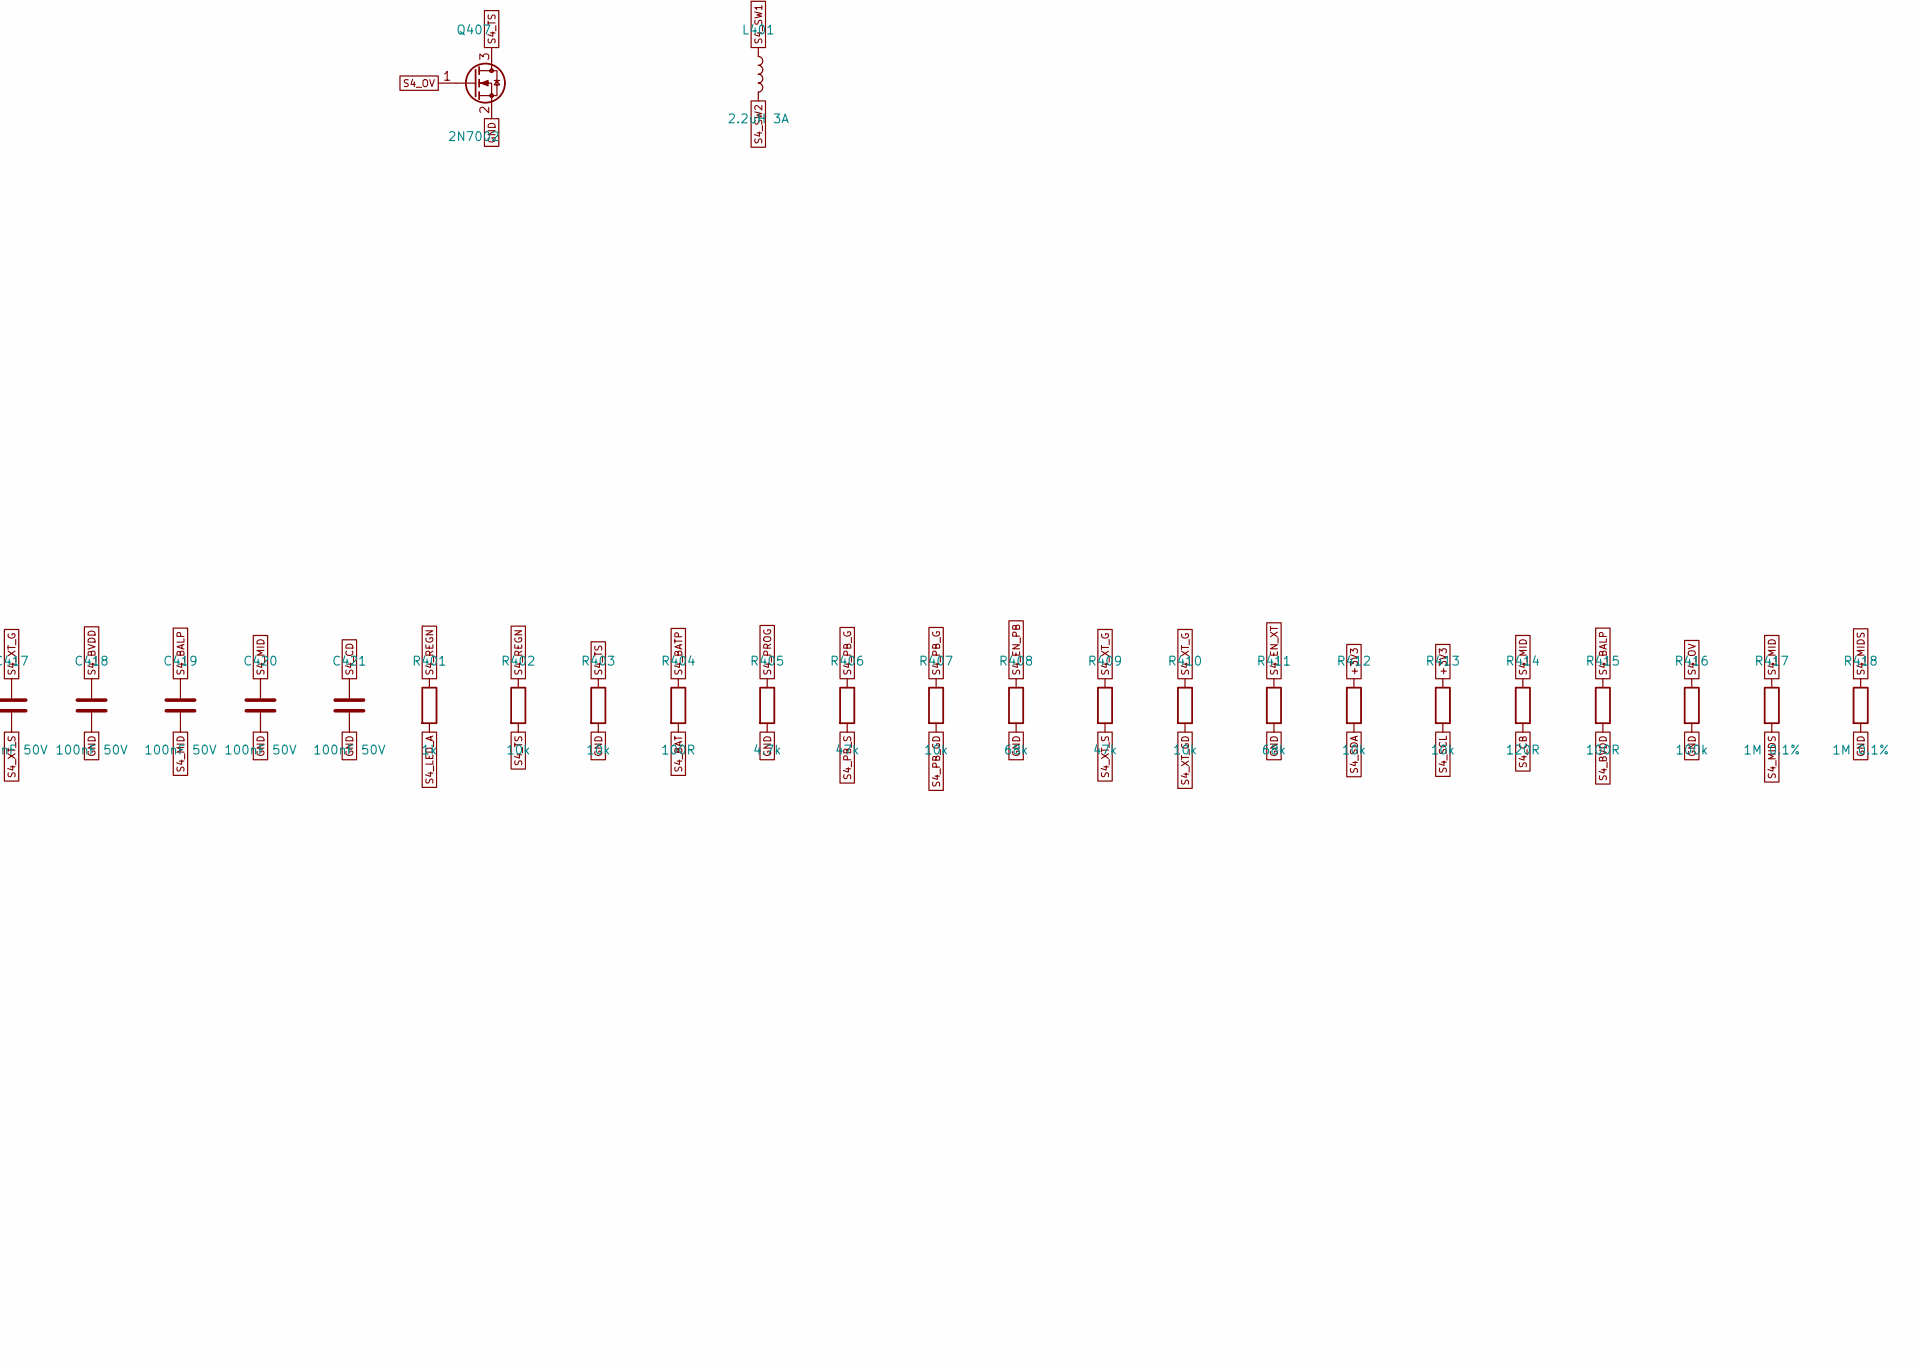
[picture p31: schematic slot4.kicad_sch, Charger slot 4: BQ25798 + PicoBlade (1S) / XT30 (2S) switch…, part in row 2, column 2]

Parts:
C401, C403: 47nF 50V; C_0402_1005Metric; MPN CL05B473KB5NNNC
C402: 4.7uF 16V; C_0603_1608Metric; MPN CL10A475KO8NNNC; LCSC C19666
C404: 1nF 50V; C_0402_1005Metric; MPN CL05B102KB5NNNC; LCSC C1523
C405, C407, C408, C414, C415: 10uF 25V; C_0805_2012Metric; MPN CL21A106KAYNNNE; LCSC C15850
C406, C409, C413, C416, C417, C418, C419, C420, C421: 100nF 50V; C_0402_1005Metric; MPN CL05B104KB54PNC; LCSC C307331
C410, C411: 22uF 25V; C_0805_2012Metric; MPN CL21A226MAQNNNE; LCSC C45783
D401: CHARGING (green); LED_0603_1608Metric; MPN 19-217/GHC-YR1S2/3T; LCSC C72043
J401: XT30 2S; AMASS_XT30UPB-M_1x02_P5.0mm_Vertical; MPN XT30UPB-M; LCSC C99101
J402: PicoBlade 1S; Molex_PicoBlade_53047-0210_1x02_P1.25mm_Vertical; MPN 0530470210
J403: XH balance 2S; JST_XH_B3B-XH-A_1x03_P2.50mm_Vertical; MPN B3B-XH-A; LCSC C144394
L401: 2.2uH 3A; L_Changjiang_FNR4030S; MPN FNR4030S2R2MT
Q401, Q402, Q403, Q404: AO3401A; SOT-23; MPN AO3401A; LCSC C15127
Q405, Q406, Q407: 2N7002; SOT-23; MPN 2N7002; LCSC C8545
R401: 1k; R_0402_1005Metric; MPN 0402WGF1001TCE; LCSC C11702
R402, R403, R407, R410, R412, R413: 10k; R_0402_1005Metric; MPN 0402WGF1002TCE; LCSC C25744
R404, R415: 100R; R_0402_1005Metric; MPN 0402WGF1000TCE; LCSC C25076
R405: 4.7k; R_0402_1005Metric; MPN 0402WGF4701TCE; LCSC C25900
R406, R409: 47k; R_0402_1005Metric; MPN 0402WGF4702TCE; LCSC C25792
R408, R411: 68k; R_0402_1005Metric; MPN 0402WGF6802TCE; LCSC C36871
R414: 120R; R_0402_1005Metric; MPN 0402WGF1200TCE
R416: 100k; R_0402_1005Metric; MPN 0402WGF1003TCE; LCSC C25741
R417, R418, R419, R420, R421: 1M 0.1%; R_0402_1005Metric; MPN RT0402BRD071ML
U401: BQ25798; Texas_RQM0029A_VQFN-29_4x4mm_P0.4mm; MPN BQ25798RQMR; LCSC C2876768
U402: BQ29209; VSON-8-1EP_3x3mm_P0.65mm_EP1.65x2.4mm; MPN BQ29209DRBR

Connections:
+3V3: R412.1, R413.1; also elsewhere on the board
CE_ALL_N: U401.13 (~CE); also elsewhere on the board
GND: C402.2, C404.2, C405.2, C406.2, C407.2, C408.2, C409.2, C410.2, C411.2, C413.2, C414.2, C415.2, C418.2, C420.2, C421.2, J401.1, J402.2, J403.1, Q405.2 (S), Q406.2 (S), Q407.2 (S), R403.2, R405.2, R408.2, R411.2, R416.2, R418.2, R421.2, U401.10 (ACDRV2), U401.11 (ACDRV1), U401.27 (GND), U402.5 (GND), U402.6 (CB_EN), U402.9 (EPAD); also elsewhere on the board
S4_BALA: R419.2, R420.1
S4_BALP: C419.1, J403.3, R415.1, R419.1, U402.1 (VC2)
S4_BALS: R420.2, R421.1; also elsewhere on the board
S4_BAT: C414.1, C415.1, Q402.3 (D), Q404.3 (D), R404.2, U401.22 (BAT), U401.23 (BAT)
S4_BATP: R404.1, U401.18 (BATP)
S4_BTST1: C401.1, U401.4 (BTST1)
S4_BTST2: C403.1, U401.19 (BTST2)
S4_BVDD: C418.1, R415.2, U402.7 (VDD)
S4_CB: R414.2, U402.3 (VC1_CB)
S4_CD: C421.1, U402.4 (CD)
S4_EN_PB: Q405.1 (G), R408.1, U401.6 (D+)
S4_EN_XT: Q406.1 (G), R411.1, U401.7 (D-)
S4_LED_A: D401.2 (A), R401.2
S4_MID: C419.2, C420.1, J403.2, R414.1, R417.1, U402.2 (VC1)
S4_MIDS: R417.2, R418.1; also elsewhere on the board
S4_OV: Q407.1 (G), R416.1, U402.8 (OUT)
S4_PB_G: C416.1, Q401.1 (G), Q402.1 (G), R406.1, R407.1
S4_PB_GD: Q405.3 (D), R407.2
S4_PB_P: J402.1, Q401.3 (D)
S4_PB_S: C416.2, Q401.2 (S), Q402.2 (S), R406.2
S4_PMID: C407.1, C408.1, C409.1, U401.29 (PMID)
S4_PROG: R405.1, U401.20 (PROG)
S4_REGN: C402.1, R401.1, R402.1, U401.5 (REGN), U401.17 (ILIM_HIZ)
S4_SCL: R413.2, U401.14 (SCL); also elsewhere on the board
S4_SDA: R412.2, U401.15 (SDA); also elsewhere on the board
S4_SDRV: C404.1, U401.24 (SDRV)
S4_STAT: D401.1 (K), U401.1 (STAT)
S4_SW1: C401.2, L401.1, U401.28 (SW1)
S4_SW2: C403.2, L401.2, U401.26 (SW2)
S4_SYS: C410.1, C411.1, C413.1, U401.25 (SYS)
S4_TS: Q407.3 (D), R402.2, R403.1, U401.16 (TS)
S4_XT_G: C417.1, Q403.1 (G), Q404.1 (G), R409.1, R410.1
S4_XT_GD: Q406.3 (D), R410.2
S4_XT_P: J401.2, Q403.3 (D)
S4_XT_S: C417.2, Q403.2 (S), Q404.2 (S), R409.2
VBUS_PD: C405.1, C406.1, U401.2 (VBUS), U401.3 (VBUS), U401.8 (VAC2), U401.9 (VAC1); also elsewhere on the board

Notes on the sheet:
BQ25798 buck-boost charger. D+ drives the PicoBlade switch, D- the XT30 switch (register 0x47). Each connector has a back-to-back P-FET pair so the two packs can never be connected together.
