Mirokuki/Battery-Charger/hardware/lipo-charger.kicad_pcb

## KiCad design hardware/lipo-charger.kicad_pcb (continued)

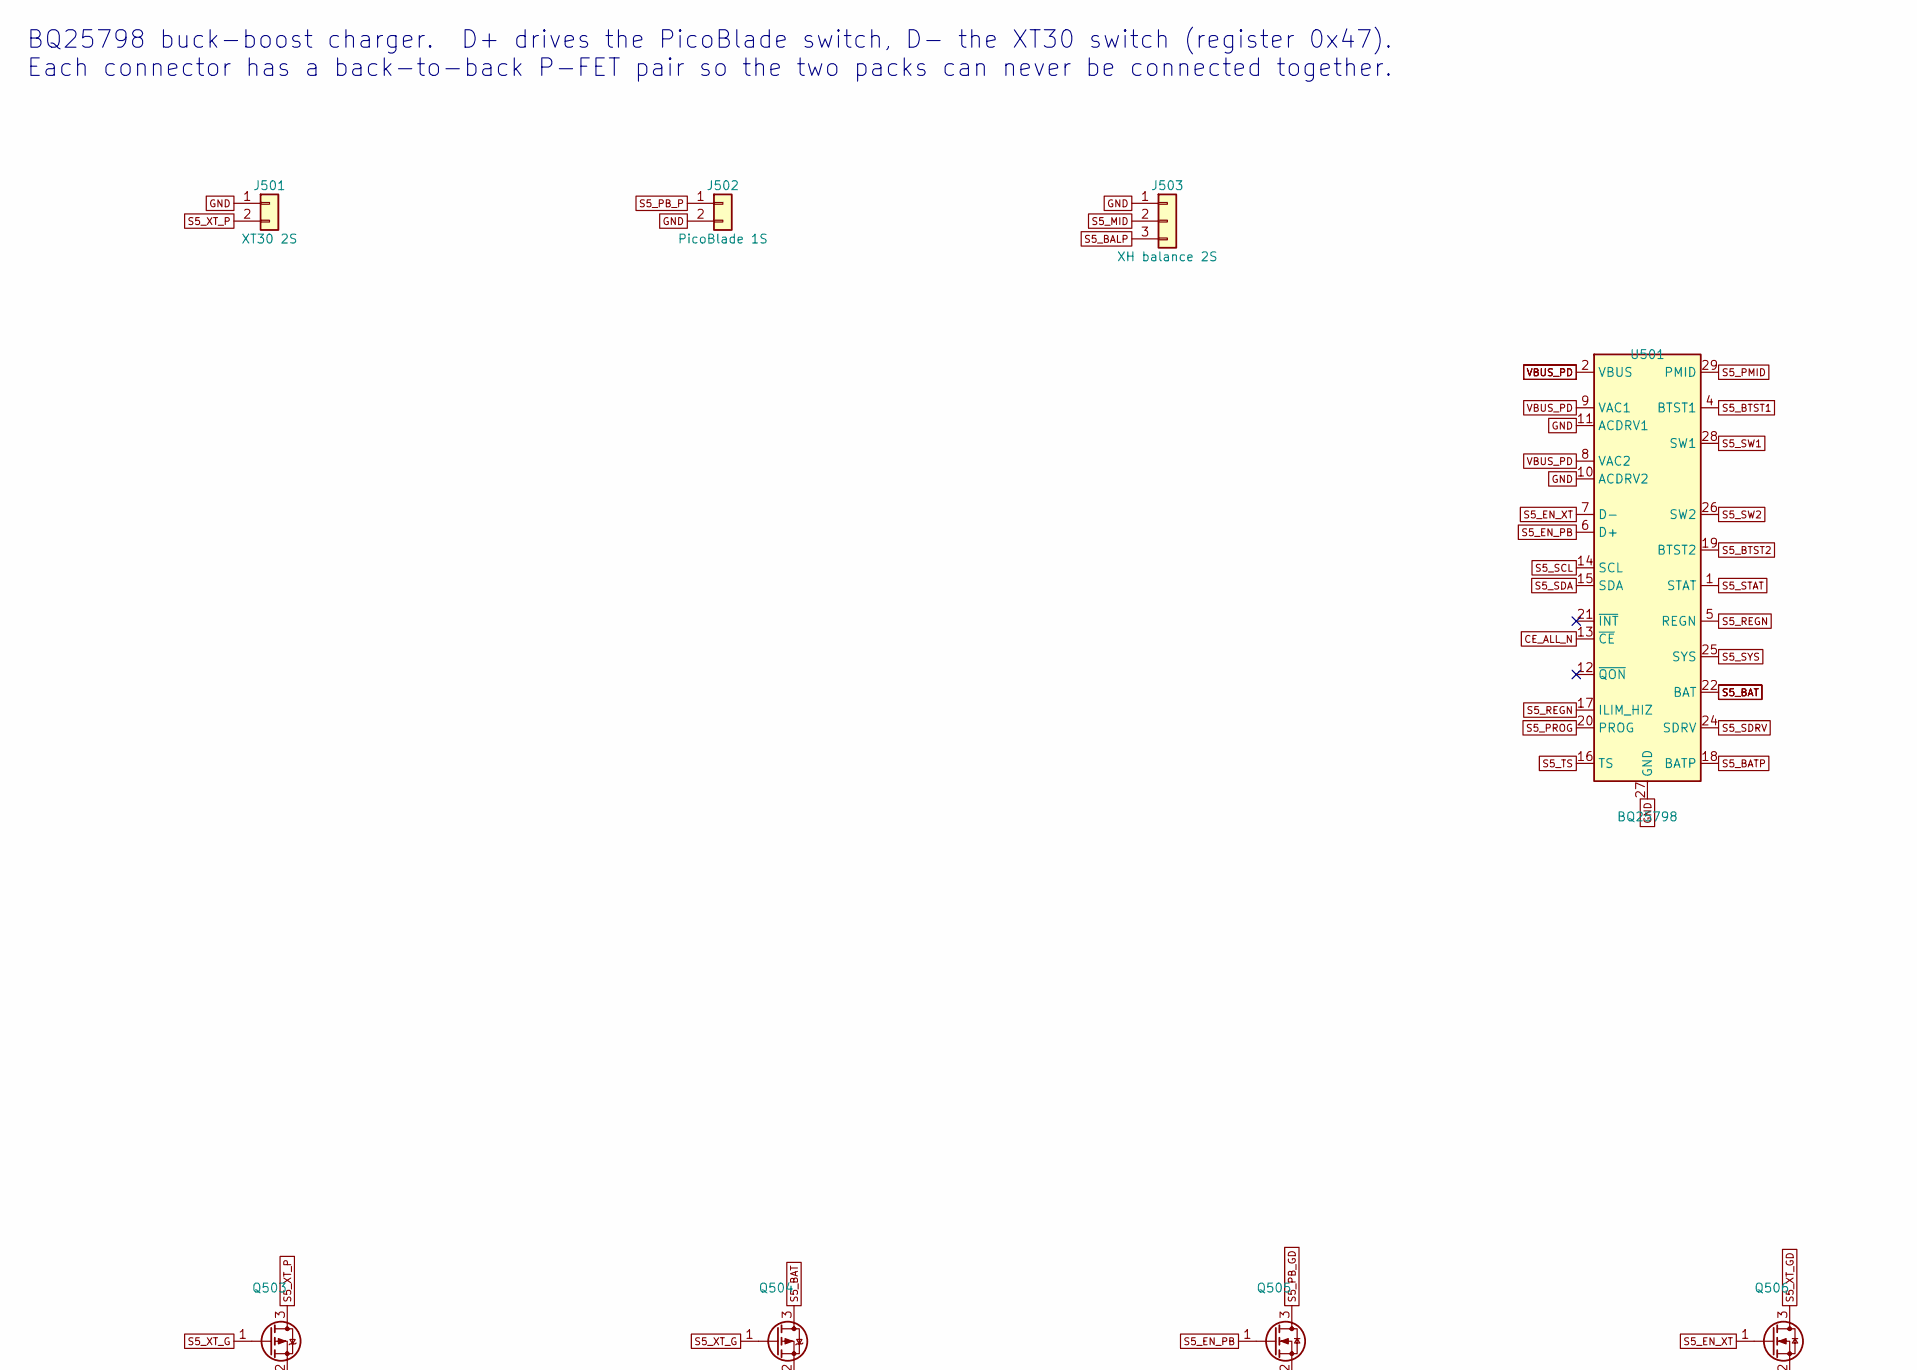
[picture p32: schematic slot5.kicad_sch, Charger slot 5: BQ25798 + PicoBlade (1S) / XT30 (2S) switch…, part in row 1, column 1]

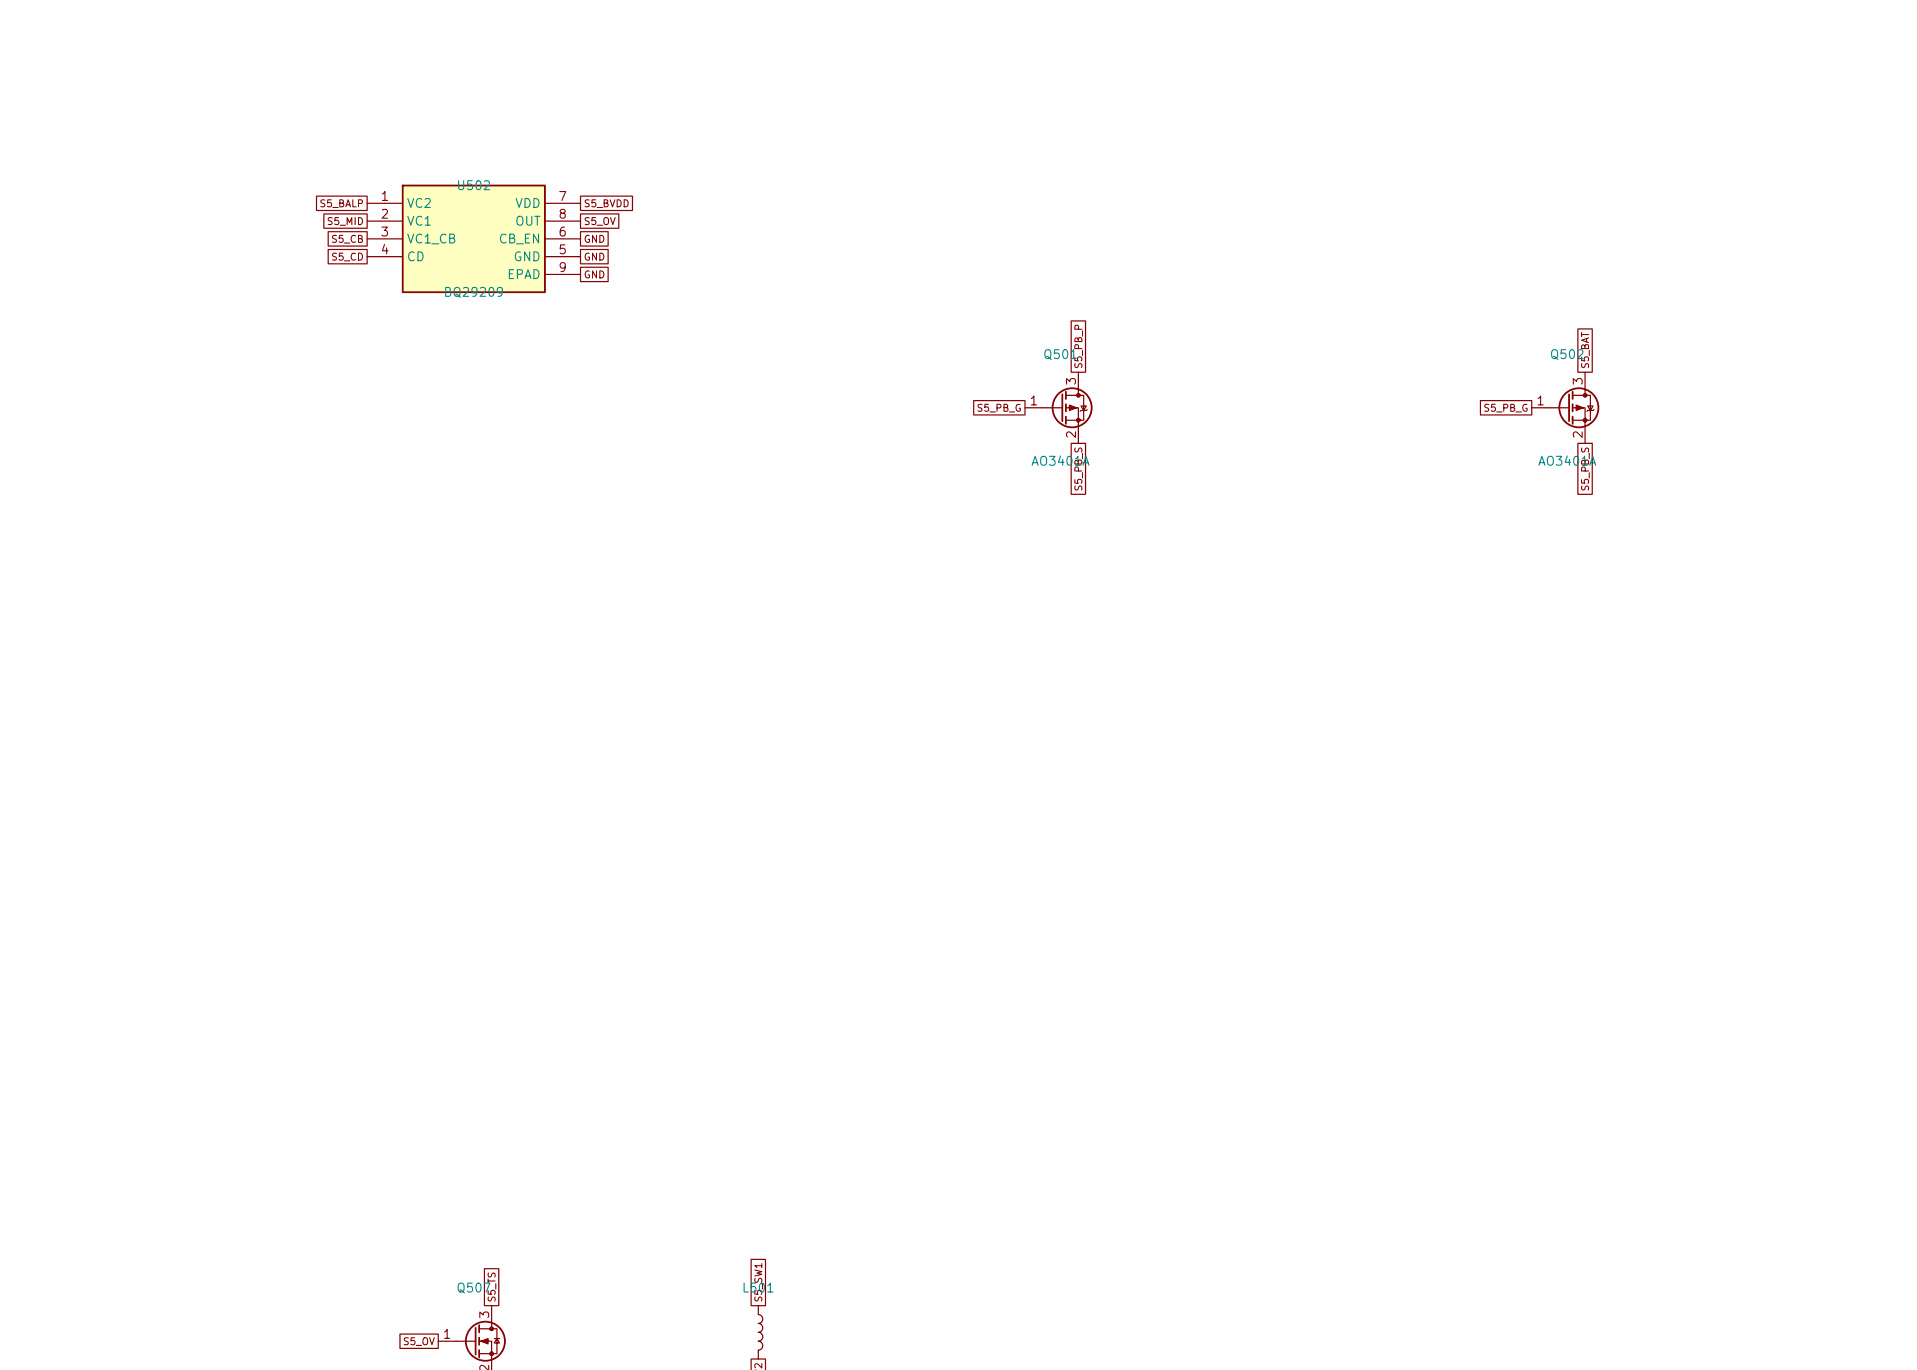
[picture p33: schematic slot5.kicad_sch, Charger slot 5: BQ25798 + PicoBlade (1S) / XT30 (2S) switch…, part in row 1, column 2]

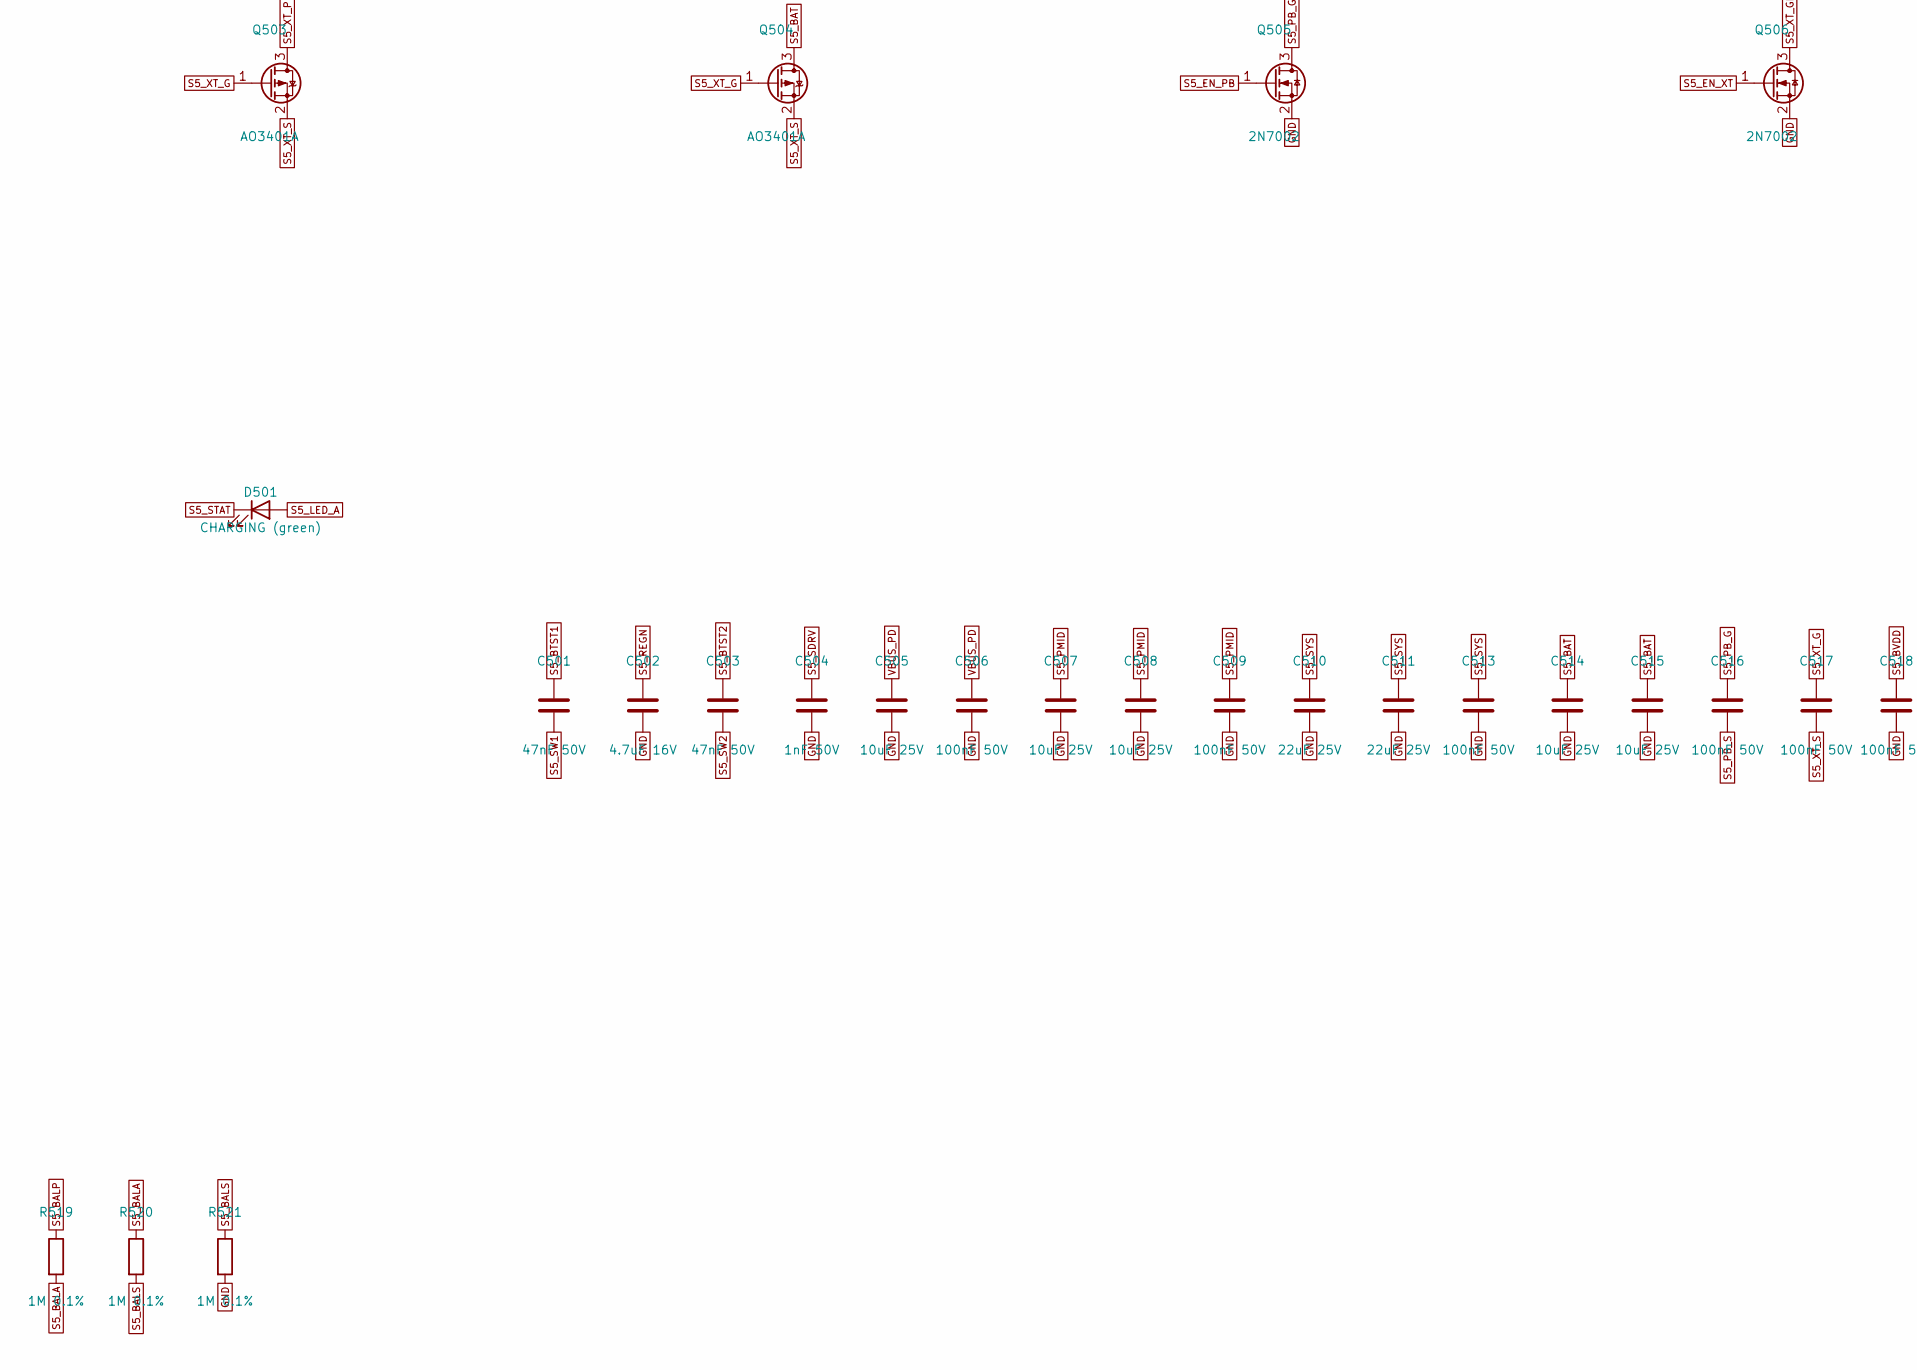
[picture p34: schematic slot5.kicad_sch, Charger slot 5: BQ25798 + PicoBlade (1S) / XT30 (2S) switch…, part in row 2, column 1]

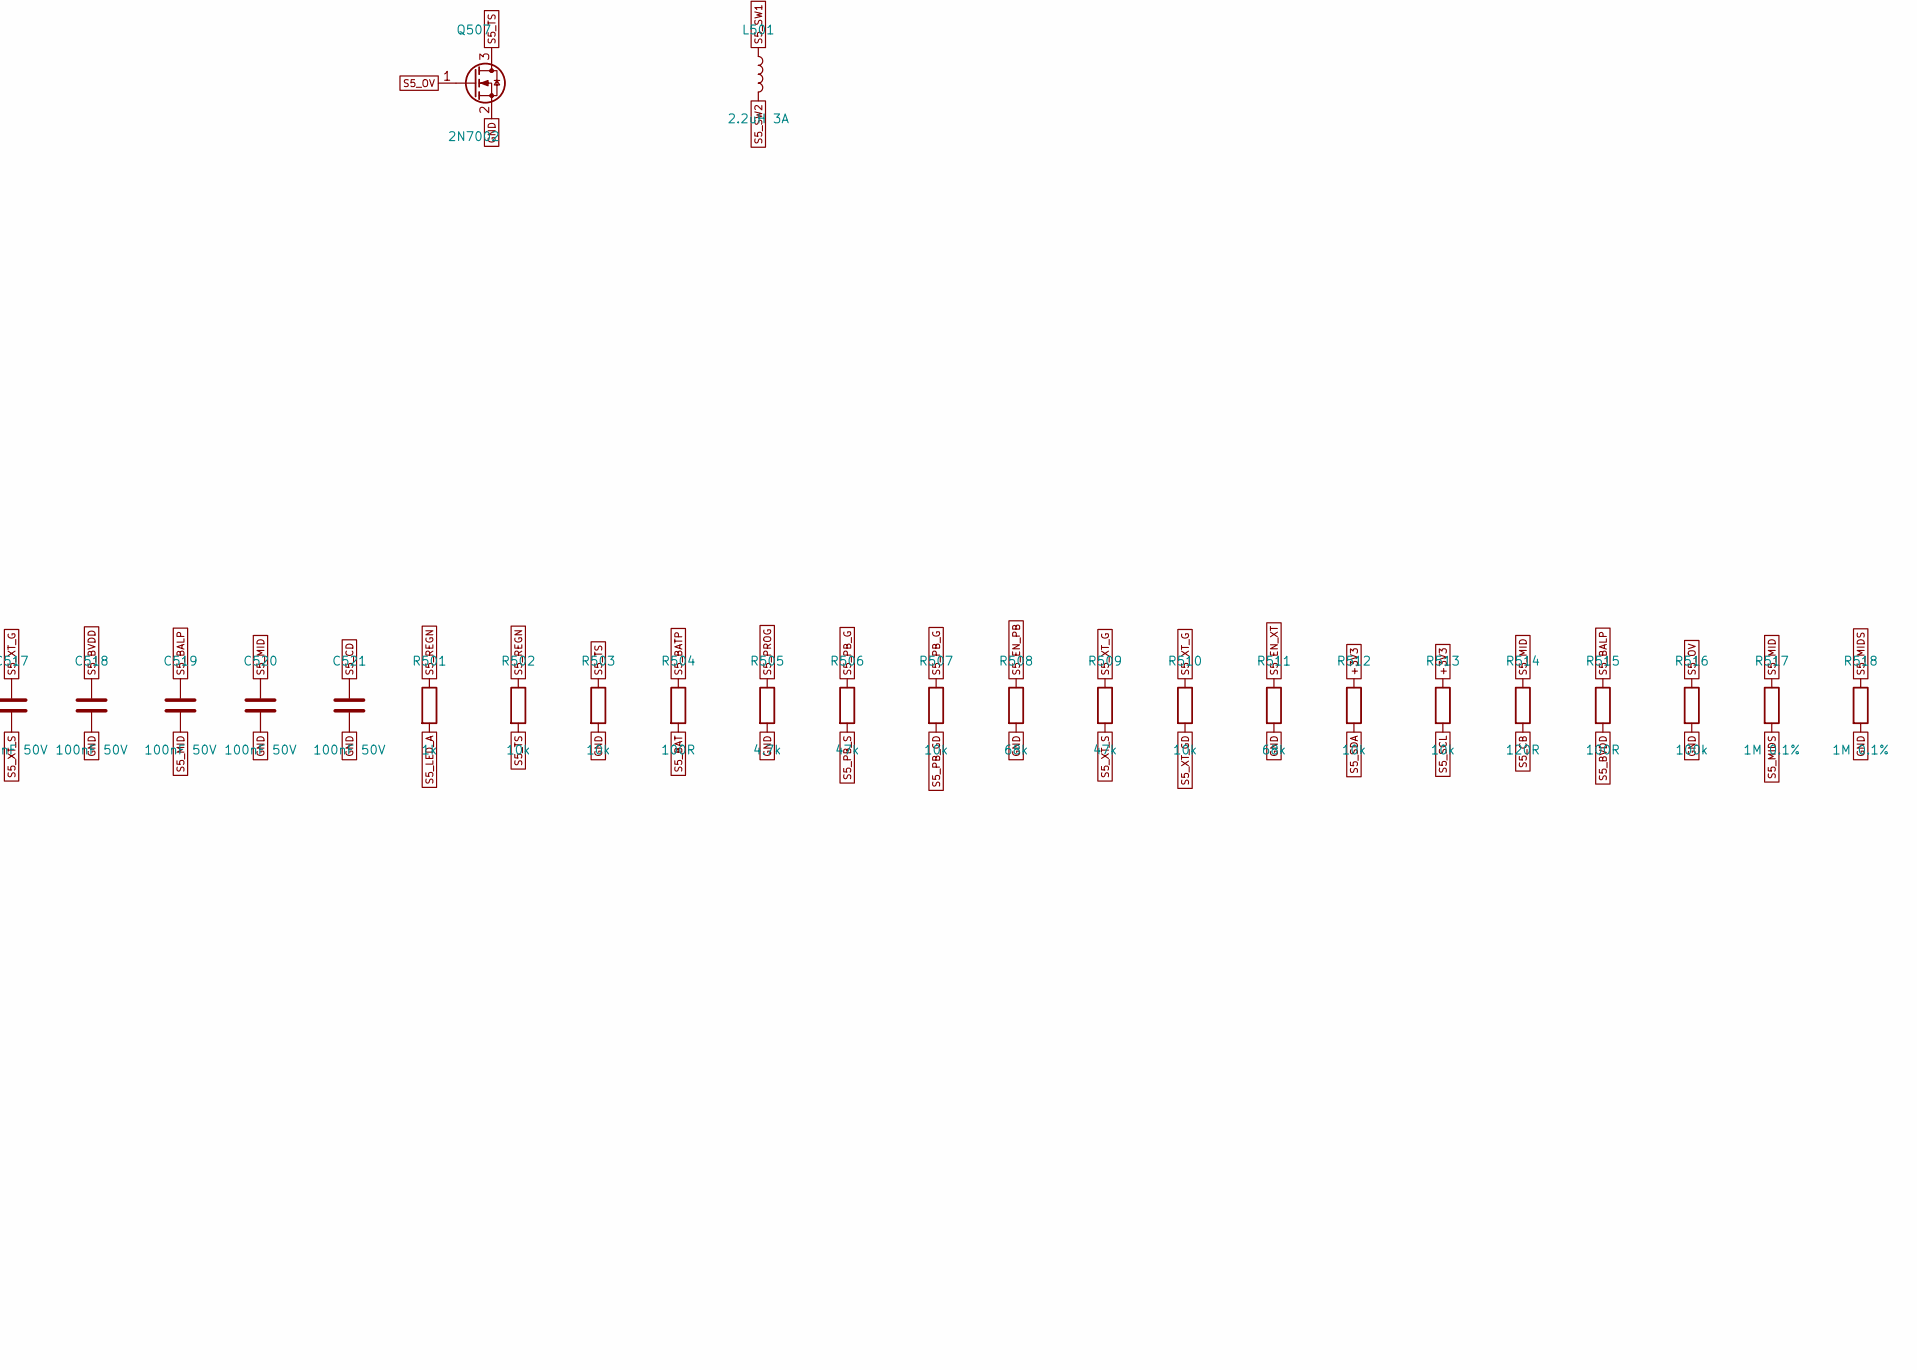
[picture p35: schematic slot5.kicad_sch, Charger slot 5: BQ25798 + PicoBlade (1S) / XT30 (2S) switch…, part in row 2, column 2]

Parts:
C501, C503: 47nF 50V; C_0402_1005Metric; MPN CL05B473KB5NNNC
C502: 4.7uF 16V; C_0603_1608Metric; MPN CL10A475KO8NNNC; LCSC C19666
C504: 1nF 50V; C_0402_1005Metric; MPN CL05B102KB5NNNC; LCSC C1523
C505, C507, C508, C514, C515: 10uF 25V; C_0805_2012Metric; MPN CL21A106KAYNNNE; LCSC C15850
C506, C509, C513, C516, C517, C518, C519, C520, C521: 100nF 50V; C_0402_1005Metric; MPN CL05B104KB54PNC; LCSC C307331
C510, C511: 22uF 25V; C_0805_2012Metric; MPN CL21A226MAQNNNE; LCSC C45783
D501: CHARGING (green); LED_0603_1608Metric; MPN 19-217/GHC-YR1S2/3T; LCSC C72043
J501: XT30 2S; AMASS_XT30UPB-M_1x02_P5.0mm_Vertical; MPN XT30UPB-M; LCSC C99101
J502: PicoBlade 1S; Molex_PicoBlade_53047-0210_1x02_P1.25mm_Vertical; MPN 0530470210
J503: XH balance 2S; JST_XH_B3B-XH-A_1x03_P2.50mm_Vertical; MPN B3B-XH-A; LCSC C144394
L501: 2.2uH 3A; L_Changjiang_FNR4030S; MPN FNR4030S2R2MT
Q501, Q502, Q503, Q504: AO3401A; SOT-23; MPN AO3401A; LCSC C15127
Q505, Q506, Q507: 2N7002; SOT-23; MPN 2N7002; LCSC C8545
R501: 1k; R_0402_1005Metric; MPN 0402WGF1001TCE; LCSC C11702
R502, R503, R507, R510, R512, R513: 10k; R_0402_1005Metric; MPN 0402WGF1002TCE; LCSC C25744
R504, R515: 100R; R_0402_1005Metric; MPN 0402WGF1000TCE; LCSC C25076
R505: 4.7k; R_0402_1005Metric; MPN 0402WGF4701TCE; LCSC C25900
R506, R509: 47k; R_0402_1005Metric; MPN 0402WGF4702TCE; LCSC C25792
R508, R511: 68k; R_0402_1005Metric; MPN 0402WGF6802TCE; LCSC C36871
R514: 120R; R_0402_1005Metric; MPN 0402WGF1200TCE
R516: 100k; R_0402_1005Metric; MPN 0402WGF1003TCE; LCSC C25741
R517, R518, R519, R520, R521: 1M 0.1%; R_0402_1005Metric; MPN RT0402BRD071ML
U501: BQ25798; Texas_RQM0029A_VQFN-29_4x4mm_P0.4mm; MPN BQ25798RQMR; LCSC C2876768
U502: BQ29209; VSON-8-1EP_3x3mm_P0.65mm_EP1.65x2.4mm; MPN BQ29209DRBR

Connections:
+3V3: R512.1, R513.1; also elsewhere on the board
CE_ALL_N: U501.13 (~CE); also elsewhere on the board
GND: C502.2, C504.2, C505.2, C506.2, C507.2, C508.2, C509.2, C510.2, C511.2, C513.2, C514.2, C515.2, C518.2, C520.2, C521.2, J501.1, J502.2, J503.1, Q505.2 (S), Q506.2 (S), Q507.2 (S), R503.2, R505.2, R508.2, R511.2, R516.2, R518.2, R521.2, U501.10 (ACDRV2), U501.11 (ACDRV1), U501.27 (GND), U502.5 (GND), U502.6 (CB_EN), U502.9 (EPAD); also elsewhere on the board
S5_BALA: R519.2, R520.1
S5_BALP: C519.1, J503.3, R515.1, R519.1, U502.1 (VC2)
S5_BALS: R520.2, R521.1; also elsewhere on the board
S5_BAT: C514.1, C515.1, Q502.3 (D), Q504.3 (D), R504.2, U501.22 (BAT), U501.23 (BAT)
S5_BATP: R504.1, U501.18 (BATP)
S5_BTST1: C501.1, U501.4 (BTST1)
S5_BTST2: C503.1, U501.19 (BTST2)
S5_BVDD: C518.1, R515.2, U502.7 (VDD)
S5_CB: R514.2, U502.3 (VC1_CB)
S5_CD: C521.1, U502.4 (CD)
S5_EN_PB: Q505.1 (G), R508.1, U501.6 (D+)
S5_EN_XT: Q506.1 (G), R511.1, U501.7 (D-)
S5_LED_A: D501.2 (A), R501.2
S5_MID: C519.2, C520.1, J503.2, R514.1, R517.1, U502.2 (VC1)
S5_MIDS: R517.2, R518.1; also elsewhere on the board
S5_OV: Q507.1 (G), R516.1, U502.8 (OUT)
S5_PB_G: C516.1, Q501.1 (G), Q502.1 (G), R506.1, R507.1
S5_PB_GD: Q505.3 (D), R507.2
S5_PB_P: J502.1, Q501.3 (D)
S5_PB_S: C516.2, Q501.2 (S), Q502.2 (S), R506.2
S5_PMID: C507.1, C508.1, C509.1, U501.29 (PMID)
S5_PROG: R505.1, U501.20 (PROG)
S5_REGN: C502.1, R501.1, R502.1, U501.5 (REGN), U501.17 (ILIM_HIZ)
S5_SCL: R513.2, U501.14 (SCL); also elsewhere on the board
S5_SDA: R512.2, U501.15 (SDA); also elsewhere on the board
S5_SDRV: C504.1, U501.24 (SDRV)
S5_STAT: D501.1 (K), U501.1 (STAT)
S5_SW1: C501.2, L501.1, U501.28 (SW1)
S5_SW2: C503.2, L501.2, U501.26 (SW2)
S5_SYS: C510.1, C511.1, C513.1, U501.25 (SYS)
S5_TS: Q507.3 (D), R502.2, R503.1, U501.16 (TS)
S5_XT_G: C517.1, Q503.1 (G), Q504.1 (G), R509.1, R510.1
S5_XT_GD: Q506.3 (D), R510.2
S5_XT_P: J501.2, Q503.3 (D)
S5_XT_S: C517.2, Q503.2 (S), Q504.2 (S), R509.2
VBUS_PD: C505.1, C506.1, U501.2 (VBUS), U501.3 (VBUS), U501.8 (VAC2), U501.9 (VAC1); also elsewhere on the board

Notes on the sheet:
BQ25798 buck-boost charger. D+ drives the PicoBlade switch, D- the XT30 switch (register 0x47). Each connector has a back-to-back P-FET pair so the two packs can never be connected together.
