Mirokuki/Battery-Charger/hardware/lipo-charger.kicad_pcb

## KiCad design hardware/lipo-charger.kicad_pcb (continued)

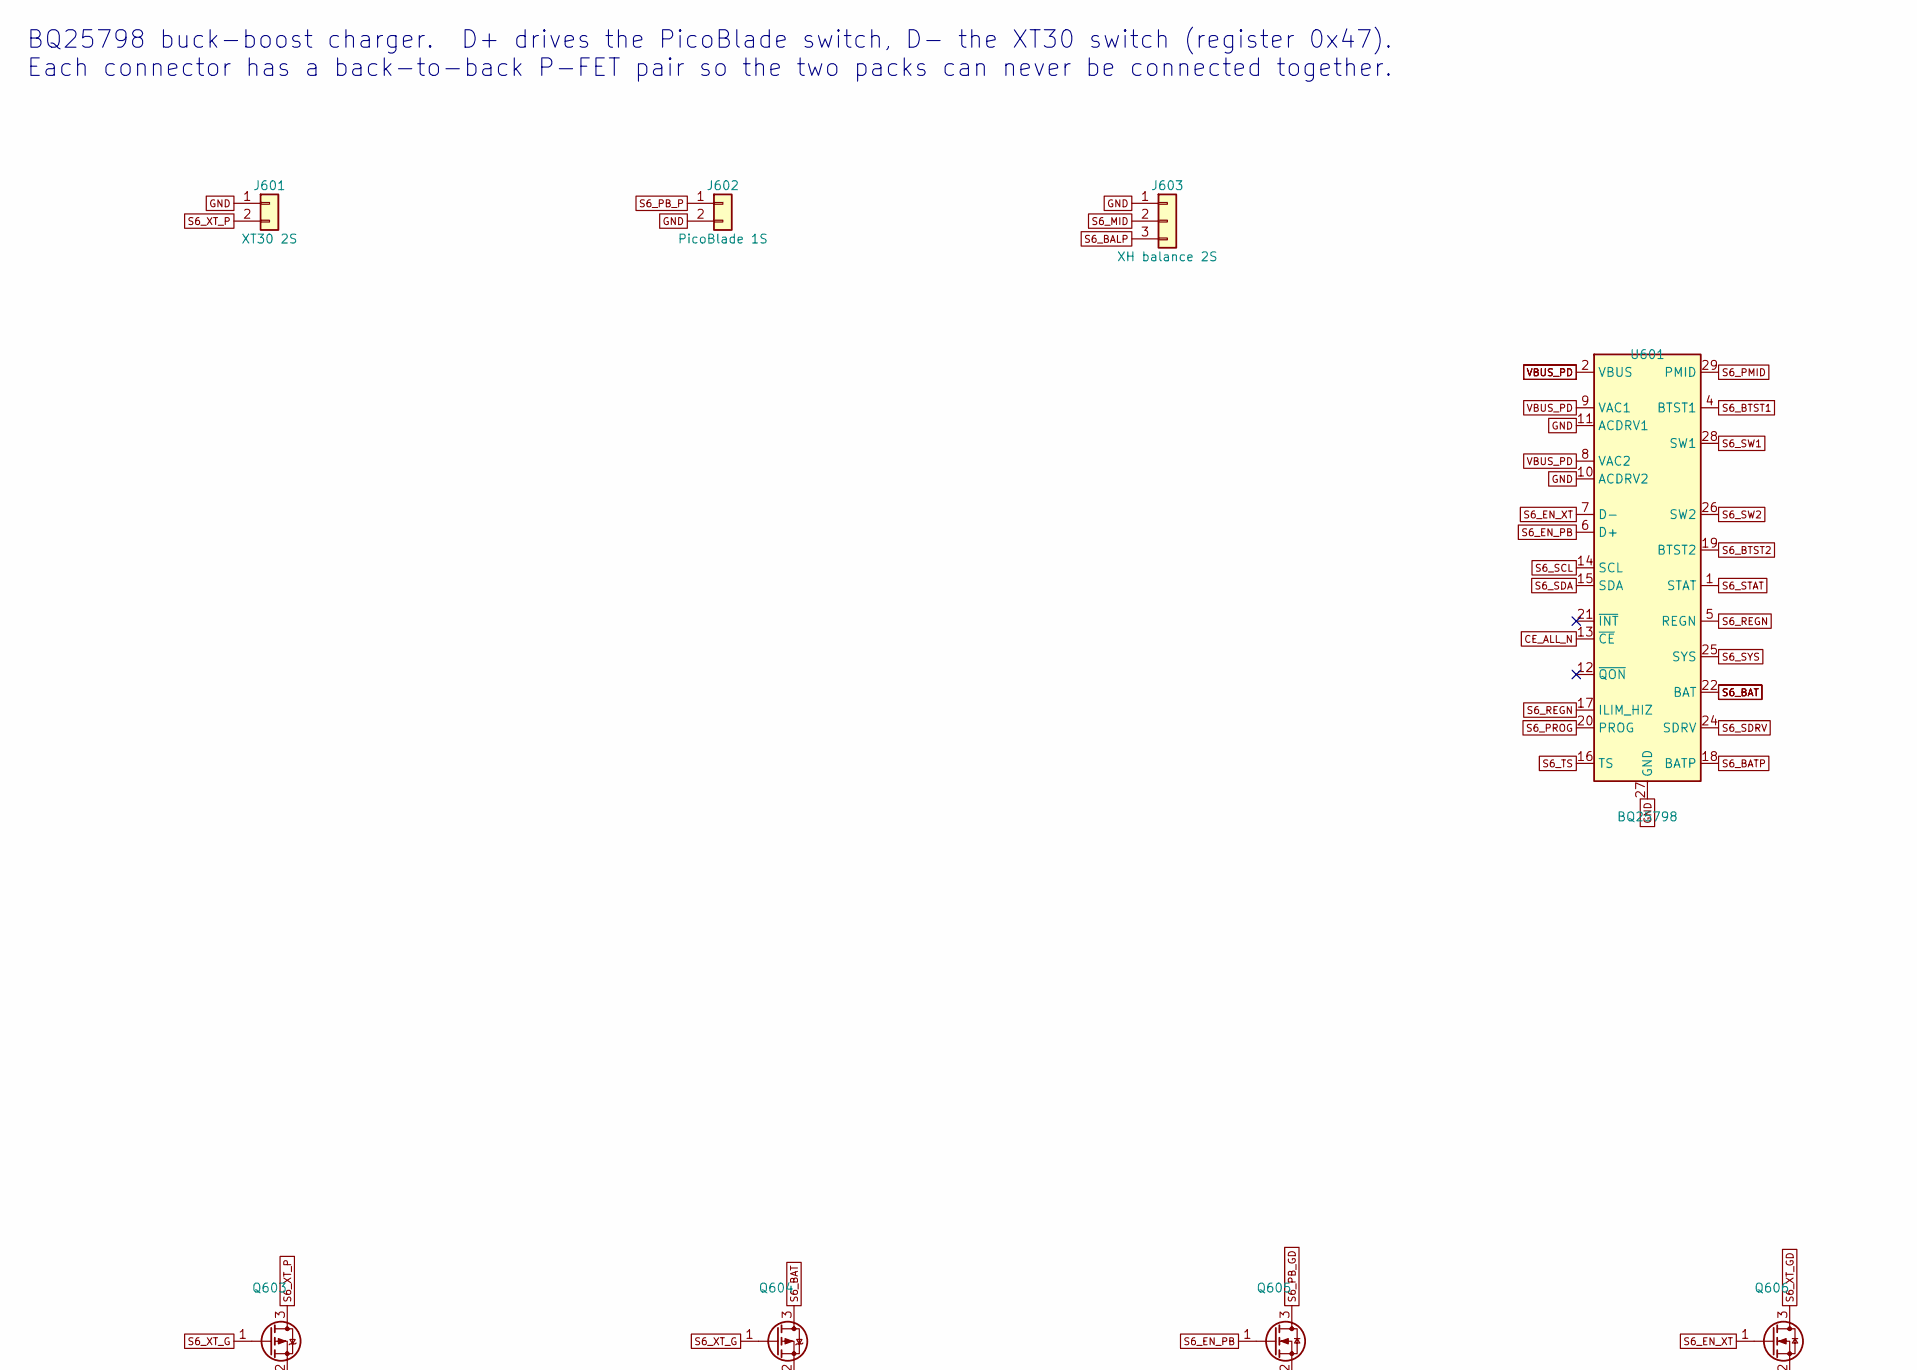
[picture p36: schematic slot6.kicad_sch, Charger slot 6: BQ25798 + PicoBlade (1S) / XT30 (2S) switch…, part in row 1, column 1]

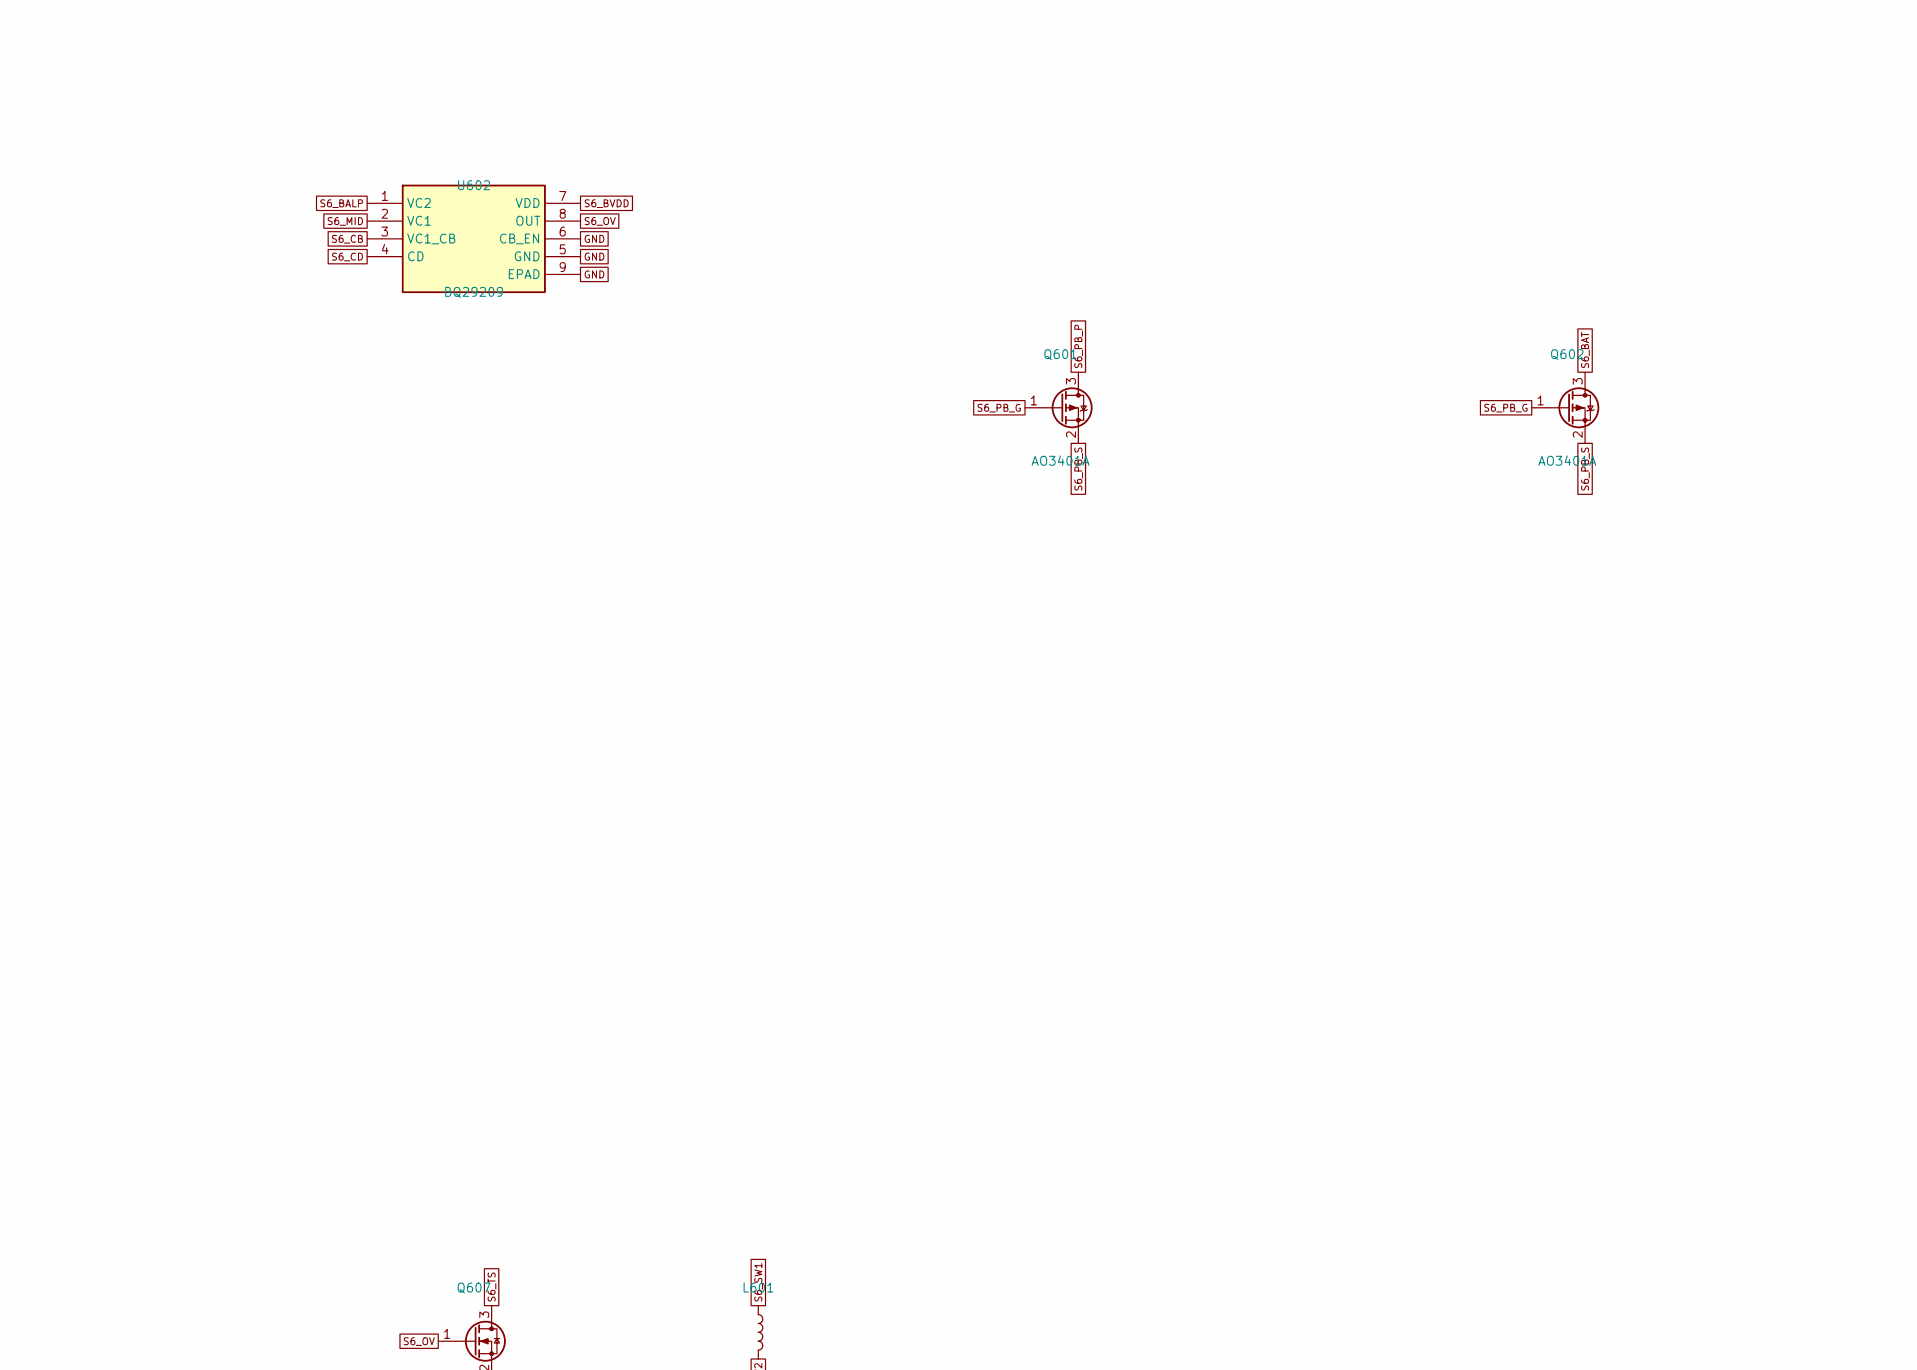
[picture p37: schematic slot6.kicad_sch, Charger slot 6: BQ25798 + PicoBlade (1S) / XT30 (2S) switch…, part in row 1, column 2]

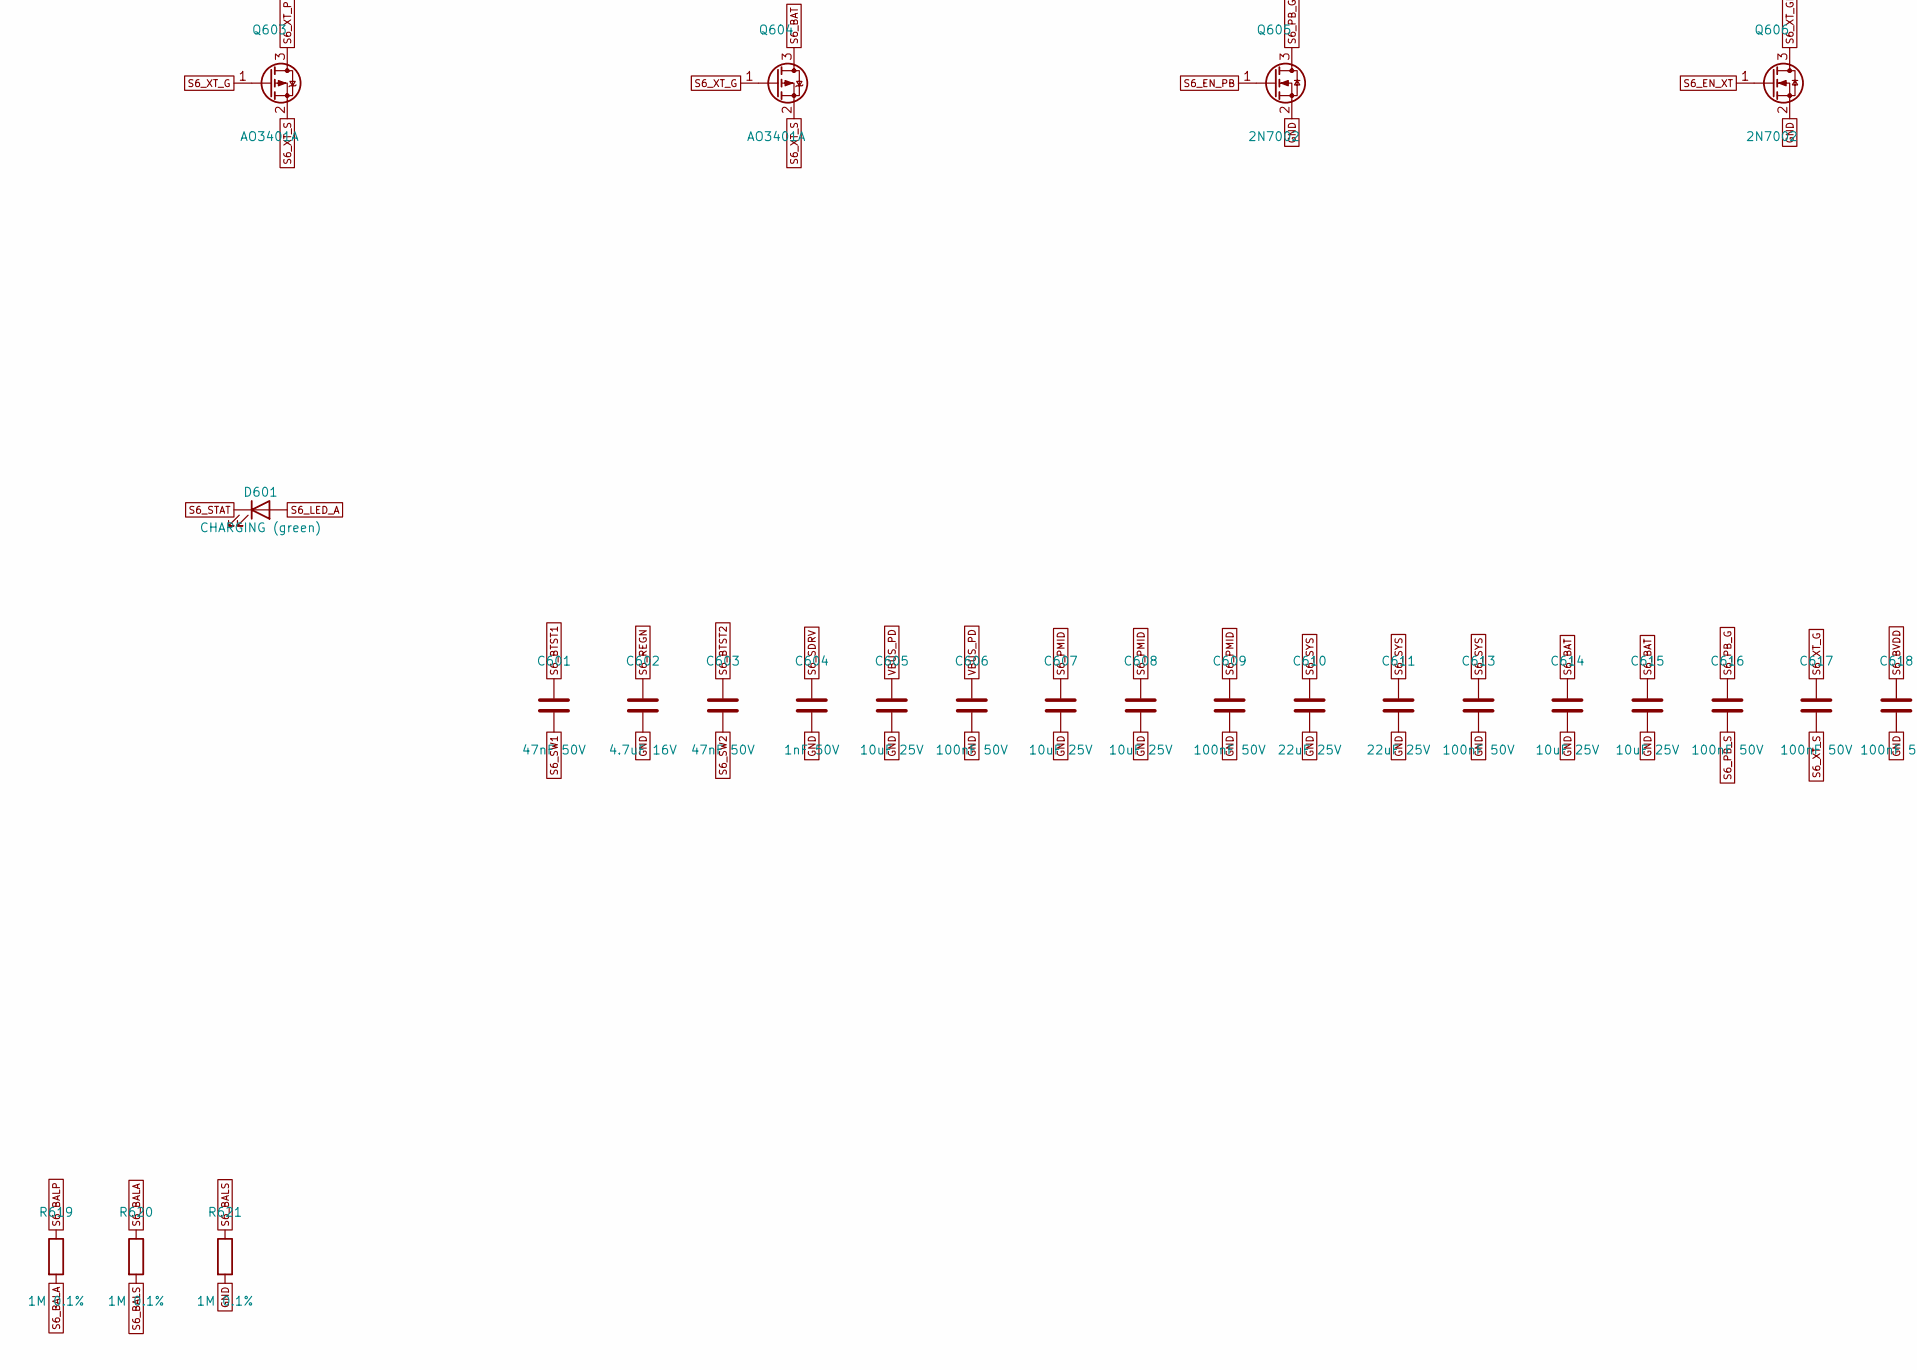
[picture p38: schematic slot6.kicad_sch, Charger slot 6: BQ25798 + PicoBlade (1S) / XT30 (2S) switch…, part in row 2, column 1]

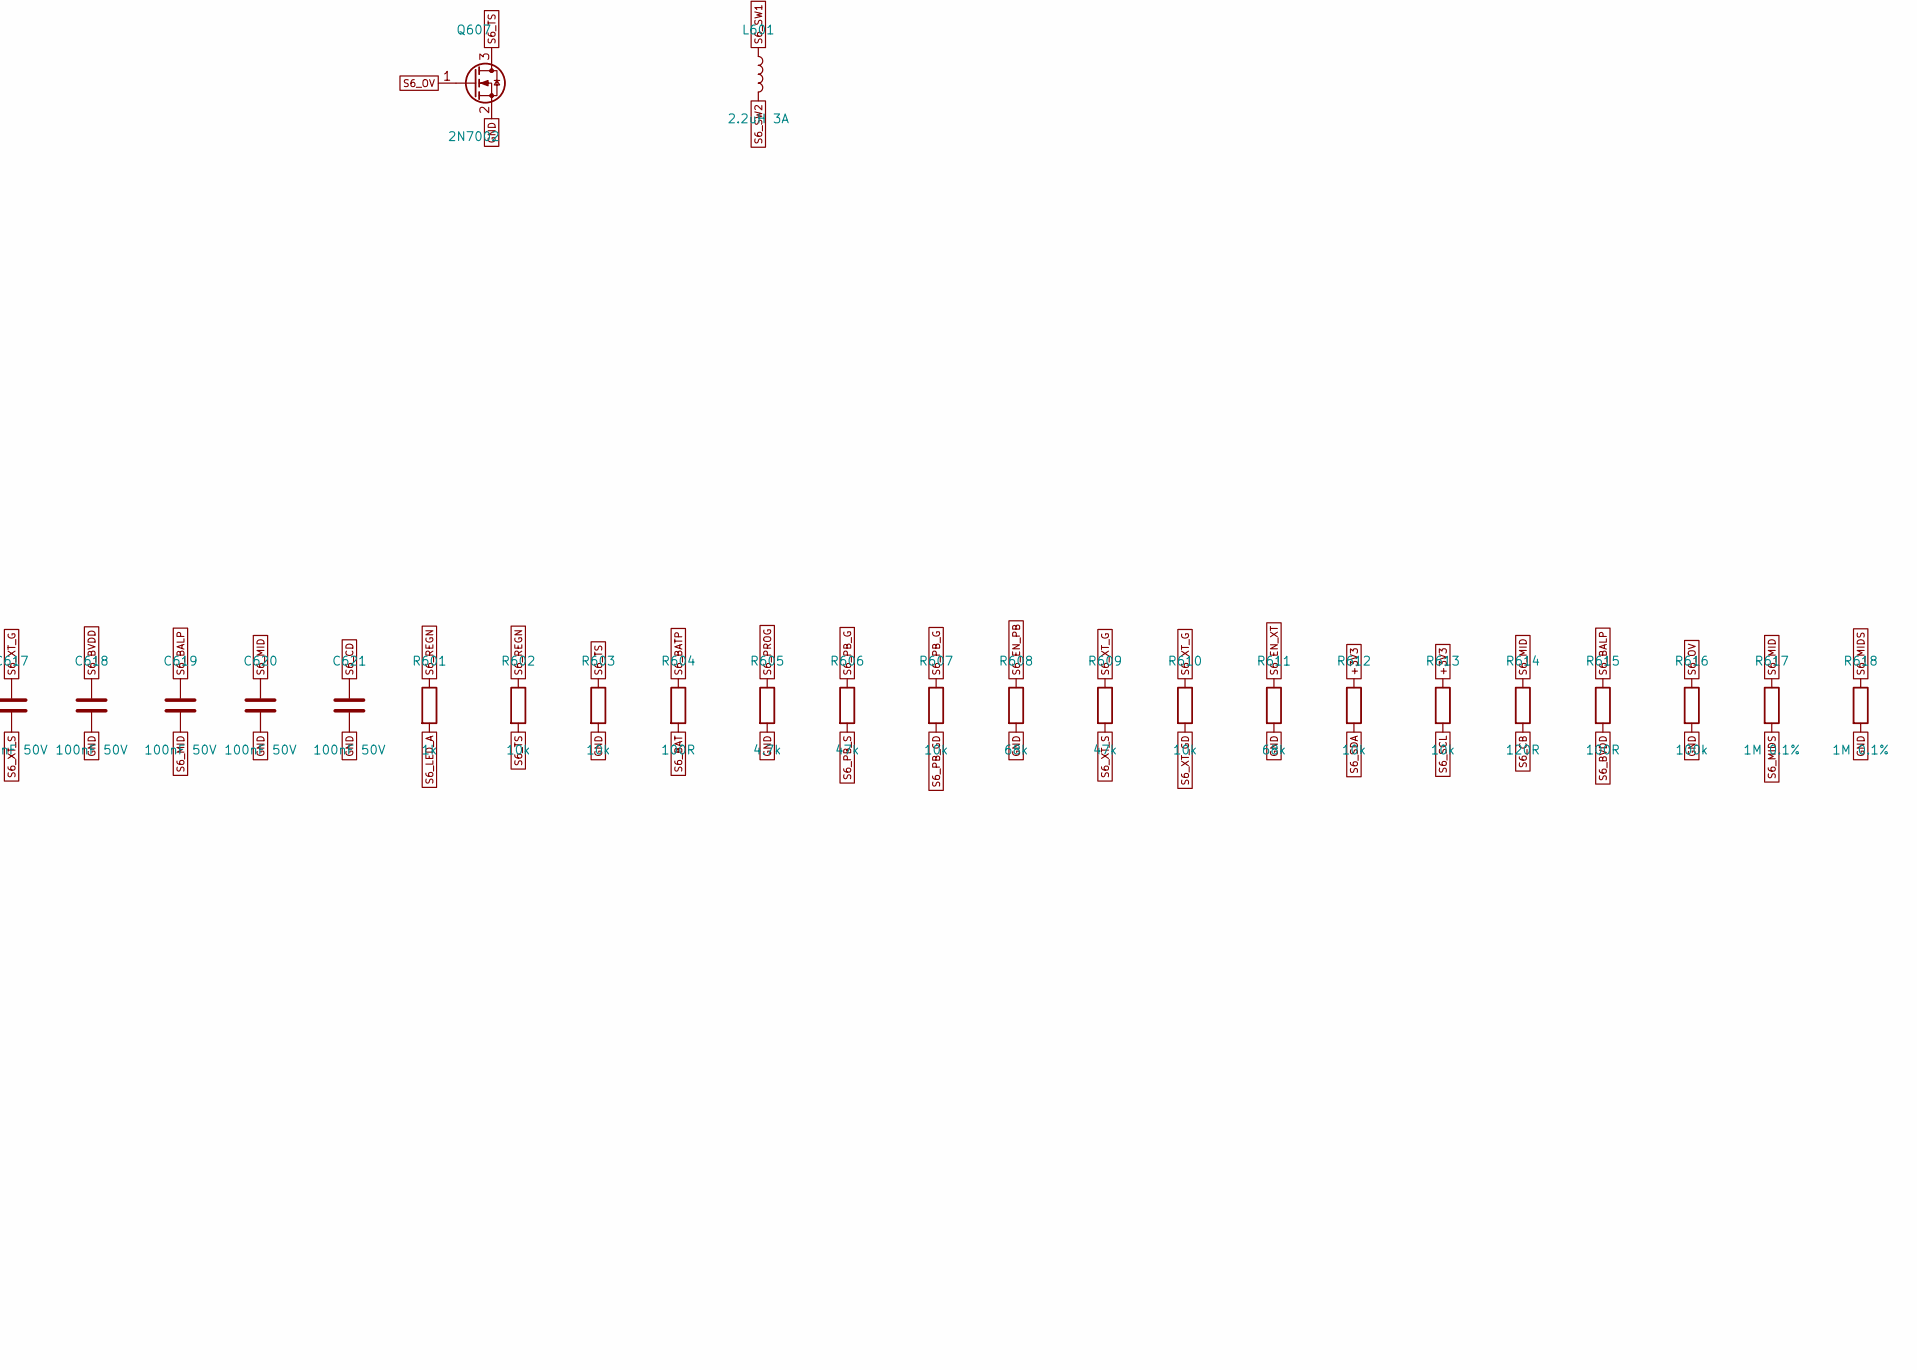
[picture p39: schematic slot6.kicad_sch, Charger slot 6: BQ25798 + PicoBlade (1S) / XT30 (2S) switch…, part in row 2, column 2]

Parts:
C601, C603: 47nF 50V; C_0402_1005Metric; MPN CL05B473KB5NNNC
C602: 4.7uF 16V; C_0603_1608Metric; MPN CL10A475KO8NNNC; LCSC C19666
C604: 1nF 50V; C_0402_1005Metric; MPN CL05B102KB5NNNC; LCSC C1523
C605, C607, C608, C614, C615: 10uF 25V; C_0805_2012Metric; MPN CL21A106KAYNNNE; LCSC C15850
C606, C609, C613, C616, C617, C618, C619, C620, C621: 100nF 50V; C_0402_1005Metric; MPN CL05B104KB54PNC; LCSC C307331
C610, C611: 22uF 25V; C_0805_2012Metric; MPN CL21A226MAQNNNE; LCSC C45783
D601: CHARGING (green); LED_0603_1608Metric; MPN 19-217/GHC-YR1S2/3T; LCSC C72043
J601: XT30 2S; AMASS_XT30UPB-M_1x02_P5.0mm_Vertical; MPN XT30UPB-M; LCSC C99101
J602: PicoBlade 1S; Molex_PicoBlade_53047-0210_1x02_P1.25mm_Vertical; MPN 0530470210
J603: XH balance 2S; JST_XH_B3B-XH-A_1x03_P2.50mm_Vertical; MPN B3B-XH-A; LCSC C144394
L601: 2.2uH 3A; L_Changjiang_FNR4030S; MPN FNR4030S2R2MT
Q601, Q602, Q603, Q604: AO3401A; SOT-23; MPN AO3401A; LCSC C15127
Q605, Q606, Q607: 2N7002; SOT-23; MPN 2N7002; LCSC C8545
R601: 1k; R_0402_1005Metric; MPN 0402WGF1001TCE; LCSC C11702
R602, R603, R607, R610, R612, R613: 10k; R_0402_1005Metric; MPN 0402WGF1002TCE; LCSC C25744
R604, R615: 100R; R_0402_1005Metric; MPN 0402WGF1000TCE; LCSC C25076
R605: 4.7k; R_0402_1005Metric; MPN 0402WGF4701TCE; LCSC C25900
R606, R609: 47k; R_0402_1005Metric; MPN 0402WGF4702TCE; LCSC C25792
R608, R611: 68k; R_0402_1005Metric; MPN 0402WGF6802TCE; LCSC C36871
R614: 120R; R_0402_1005Metric; MPN 0402WGF1200TCE
R616: 100k; R_0402_1005Metric; MPN 0402WGF1003TCE; LCSC C25741
R617, R618, R619, R620, R621: 1M 0.1%; R_0402_1005Metric; MPN RT0402BRD071ML
U601: BQ25798; Texas_RQM0029A_VQFN-29_4x4mm_P0.4mm; MPN BQ25798RQMR; LCSC C2876768
U602: BQ29209; VSON-8-1EP_3x3mm_P0.65mm_EP1.65x2.4mm; MPN BQ29209DRBR

Connections:
+3V3: R612.1, R613.1; also elsewhere on the board
CE_ALL_N: U601.13 (~CE); also elsewhere on the board
GND: C602.2, C604.2, C605.2, C606.2, C607.2, C608.2, C609.2, C610.2, C611.2, C613.2, C614.2, C615.2, C618.2, C620.2, C621.2, J601.1, J602.2, J603.1, Q605.2 (S), Q606.2 (S), Q607.2 (S), R603.2, R605.2, R608.2, R611.2, R616.2, R618.2, R621.2, U601.10 (ACDRV2), U601.11 (ACDRV1), U601.27 (GND), U602.5 (GND), U602.6 (CB_EN), U602.9 (EPAD); also elsewhere on the board
S6_BALA: R619.2, R620.1
S6_BALP: C619.1, J603.3, R615.1, R619.1, U602.1 (VC2)
S6_BALS: R620.2, R621.1; also elsewhere on the board
S6_BAT: C614.1, C615.1, Q602.3 (D), Q604.3 (D), R604.2, U601.22 (BAT), U601.23 (BAT)
S6_BATP: R604.1, U601.18 (BATP)
S6_BTST1: C601.1, U601.4 (BTST1)
S6_BTST2: C603.1, U601.19 (BTST2)
S6_BVDD: C618.1, R615.2, U602.7 (VDD)
S6_CB: R614.2, U602.3 (VC1_CB)
S6_CD: C621.1, U602.4 (CD)
S6_EN_PB: Q605.1 (G), R608.1, U601.6 (D+)
S6_EN_XT: Q606.1 (G), R611.1, U601.7 (D-)
S6_LED_A: D601.2 (A), R601.2
S6_MID: C619.2, C620.1, J603.2, R614.1, R617.1, U602.2 (VC1)
S6_MIDS: R617.2, R618.1; also elsewhere on the board
S6_OV: Q607.1 (G), R616.1, U602.8 (OUT)
S6_PB_G: C616.1, Q601.1 (G), Q602.1 (G), R606.1, R607.1
S6_PB_GD: Q605.3 (D), R607.2
S6_PB_P: J602.1, Q601.3 (D)
S6_PB_S: C616.2, Q601.2 (S), Q602.2 (S), R606.2
S6_PMID: C607.1, C608.1, C609.1, U601.29 (PMID)
S6_PROG: R605.1, U601.20 (PROG)
S6_REGN: C602.1, R601.1, R602.1, U601.5 (REGN), U601.17 (ILIM_HIZ)
S6_SCL: R613.2, U601.14 (SCL); also elsewhere on the board
S6_SDA: R612.2, U601.15 (SDA); also elsewhere on the board
S6_SDRV: C604.1, U601.24 (SDRV)
S6_STAT: D601.1 (K), U601.1 (STAT)
S6_SW1: C601.2, L601.1, U601.28 (SW1)
S6_SW2: C603.2, L601.2, U601.26 (SW2)
S6_SYS: C610.1, C611.1, C613.1, U601.25 (SYS)
S6_TS: Q607.3 (D), R602.2, R603.1, U601.16 (TS)
S6_XT_G: C617.1, Q603.1 (G), Q604.1 (G), R609.1, R610.1
S6_XT_GD: Q606.3 (D), R610.2
S6_XT_P: J601.2, Q603.3 (D)
S6_XT_S: C617.2, Q603.2 (S), Q604.2 (S), R609.2
VBUS_PD: C605.1, C606.1, U601.2 (VBUS), U601.3 (VBUS), U601.8 (VAC2), U601.9 (VAC1); also elsewhere on the board

Notes on the sheet:
BQ25798 buck-boost charger. D+ drives the PicoBlade switch, D- the XT30 switch (register 0x47). Each connector has a back-to-back P-FET pair so the two packs can never be connected together.

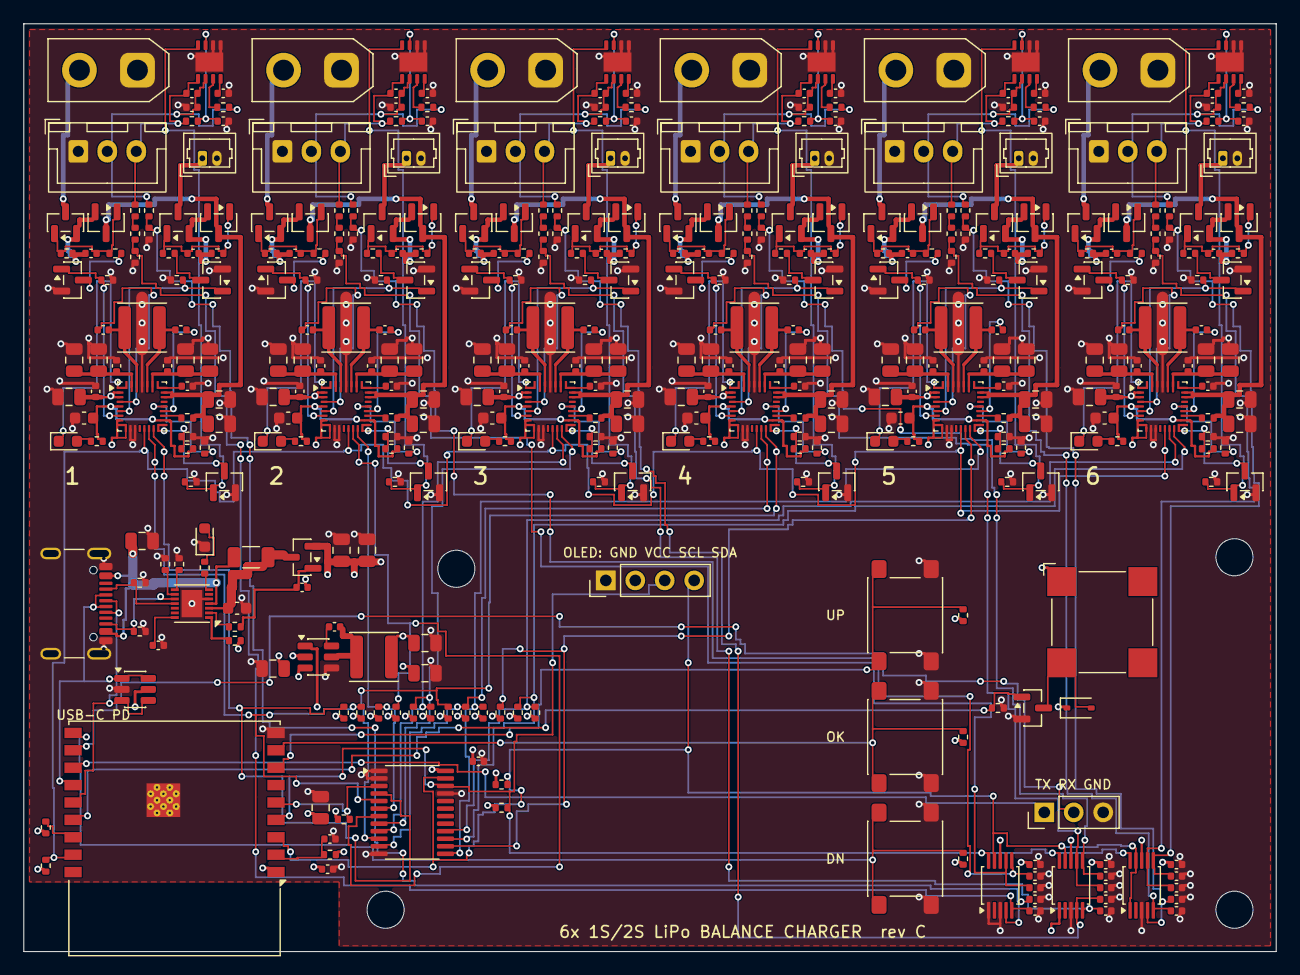
[picture p40: board lipo-charger.kicad_pcb from above]

Board: 4 copper layers, 108.0 x 80.0 mm, 401 parts (0 on the bottom side), 242 nets.

Other parts of the board:
H1, H2, H3, H4: MountingHole_3.2mm_M3
