Mirokuki/Battery-Charger/(commit log)

2026-11-09 Initial commit: 6-slot 1S LiPo/LiHV USB-C PD smart charger
    [530470210.stp, BOM_DigiKey.csv, BOM_JLCPCB.csv, BOM_Mouser.csv, charger_slot.kicad_sch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]
2026-11-11 Update schematics and 4-layer PCB routing; add schematic PDF and SVGs
    [charger_slot.kicad_sch, lipo-6slot-charger.kicad_pcb, lipo-6slot-charger.kicad_sch, manual.kicad_sch]
2026-11-12 Replace 1S charger with 6-slot 1S/2S USB-C charger design
    New design, generated from hardware/design.py:
    - One BQ25798 buck-boost charger per slot, so any slot takes a 1S pack
    (PicoBlade) or a 2S pack (XT30). Each connector has its own
    back-to-back P-FET switch, driven by the charger's D+/D- outputs.
    - AP33771C USB-PD sink (9 V), AP63203 3.3 V buck, ESP32-C3, I2C mux,
    OLED header and three buttons.
    - 108 x 68 mm 4-layer board, placed and routed by gen_pcb.py.
    KiCad DRC: 0 errors, 0 unconnected nets, board matches schematic.
    - Label-style schematic written by gen_schematic.py and checked
    against design.py (289 parts, 0 net mismatches).
    - Fab outputs for JLCPCB (gerbers, BOM, pick-an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
    [530470210.stp, BOM_DigiKey.csv, BOM_JLCPCB.csv, BOM_Mouser.csv, case_base.stl, case_lid.stl, charger_slot.kicad_sch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]
2026-11-12 Add 2S balance charging, M3 mounting and bottom-screw case
    Balance charging:
    - JST-XH balance port and BQ29209 balancer per slot. It bleeds the
    higher cell (about 10 mA) until both match, with no firmware.
    - The balancer's over-voltage flag (4.30 V per cell) pulls the
    charger's TS pin low, stopping charge in hardware. Firmware reports
    it as "cell>4.3" and ignores it in LiHV mode.
    Board:
    - Grows to 108 x 80 mm for the balance row; still single-sided SMT.
    - Mounting holes are now 3.2 mm for M3.
    - Router now rasterises custom-shaped pads from their real outline.
    It had been measuring the BQ25798's L-shaped corner pads by their
    anchor only, which DRC exposed as a REGN-to-TS short once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
    [BOM_JLCPCB.csv, case_base.stl, case_lid.stl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]
2026-11-13 Measure and display 2S cell voltages
    - Five 1 M 0.1 % resistors per slot divide the balance port's two taps
    (cell junction / 2, pack / 3), drawing about 5 uA.
    - Three ADS1115 ADCs on the main I2C bus (0x48-0x4A), one per pair of
    slots, read the dividers through 100 nF filter caps.
    - Firmware samples the 12 inputs round-robin in single-shot mode, shows
    both cells per slot ("2S 4.12/4.15"), shows a balance lead on its own
    as "bal ...", and stops a slot with "cell high" if a cell goes more
    than 80 mV over target (works in LiHV mode too).
    - Project file now lists the real root sheet. It still named the old
    design's two top-level sheets, which made KiCad load the schematic
    twice and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
    [BOM_JLCPCB.csv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]
